micro-FPGA/CRUVI/ecosystem/FMC/FMC2CRUVI-LP/FMC2CRUVI-LP.png

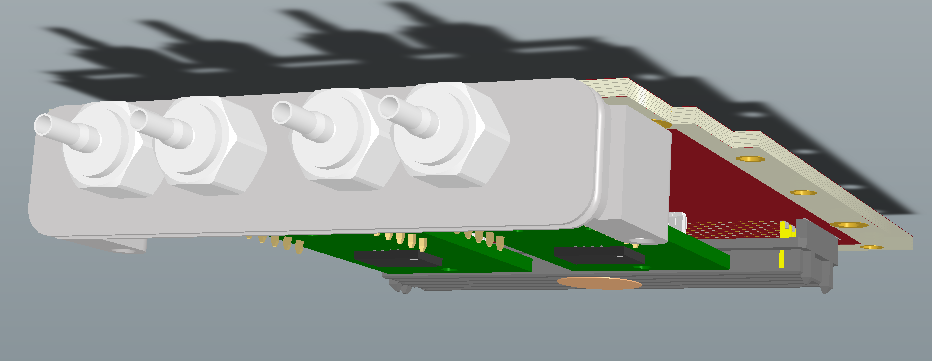
ecosystem/FMC/FMC2CRUVI-LP/FMC2CRUVI-LP.png
