micro-FPGA/CRUVI/ecosystem/TOFE/TOFE_1X_CRUVI_3W_Passive.png

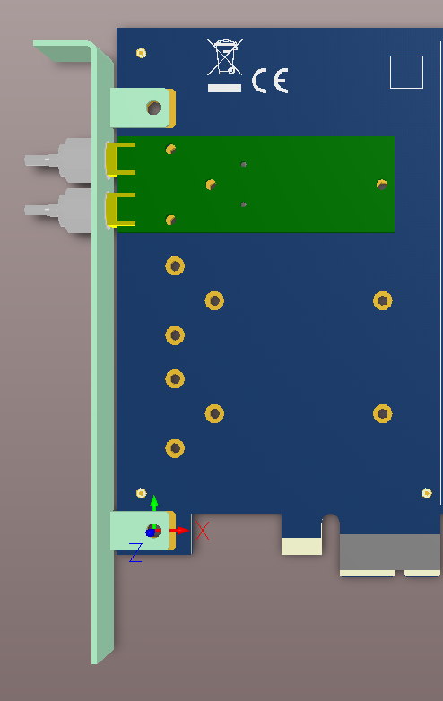
ecosystem/TOFE/TOFE_1X_CRUVI_3W_Passive.png
