micro-FPGA/CRUVI/README.md

# CRUVI
CRUVI Standard Specifications in [docs](https://github.com/micro-FPGA/CRUVI/tree/master/docs)

Mailinglist and discussions: https://groups.io/g/cruvi
