micro-FPGA/CRUVI/ecosystem/PMOD/README.md

Digilent PMOD

|Adapter|Status|
|---|---|
|CRUVI to PMOD single | Boards available |
|PMOD to CRUVI single | Boards available |

Note: if two CRUVI-2-PMOD adapters are inserted into adjacent CRUVI LS slots then dual wide PMOD modules could be used (the connector spacing matches).
