micro-FPGA/CRUVI/ecosystem/EEM/README.md

https://github.com/sinara-hw/meta/wiki/EEM

EEM has management I2C and 8 LVDS pairs that can be used as single ended I/O with unknown VCCIO voltage?

Maybe better to have EEM2CRUVI adapters always with FPGA smart translation?
