micro-FPGA/CRUVI/ecosystem/SYZYGY/README.md

Passive adapter from SYZYGY standard can fit one CRUVI HS connector almost completly so large number of CRUVI modules could be used with passive adapter. Mechanically one standard with SYZYGY can hold a two single width or one dual CRUVI module.

Passive adapter mapping from SYZYGY to CRUVI HS

|SYZYGY|CRUVI|Notes|
|-----|---|--|
|3.3V|VCC||
|5V|VBUS||
|VIO|VADJ||
|SDA|SDA||
|SCL|SCL||
|S0..S23|VADJ IO TBD||
|S24..S27|TBD|?|
|P2C_CLK|VADJ IO TBD||
|C2P_CLK|VADJ IO TBD||
|n/a|ALERT|with level shifter to S27 ?|
|R_GA|n/a|handled locally by SmartVIO|
