micro-FPGA/CRUVI/ecosystem/FMC/FMC2CRUVI-EVAL/README.md

This FMC card has CRUVI slots on the TOP so that any CRUVI modules including extended size one can be used without restrictions.
