micro-FPGA/CRUVI/ecosystem/FMC/FMC2CRUVI-LP/README.md

This FMC card can take 2 low profile CRUVI boards with full support of I/O via standard FMC bezel.
