micro-FPGA/CRUVI/CAD/Altium/templates/CR99500/current/hw/pcb/README.md

Tripple wide CRUVI carrier template with LS, HS and GT slots
