micro-FPGA/CRUVI/CAD/Altium/boards/CR00026/docs/3DB-CR00026-01-1.PDF

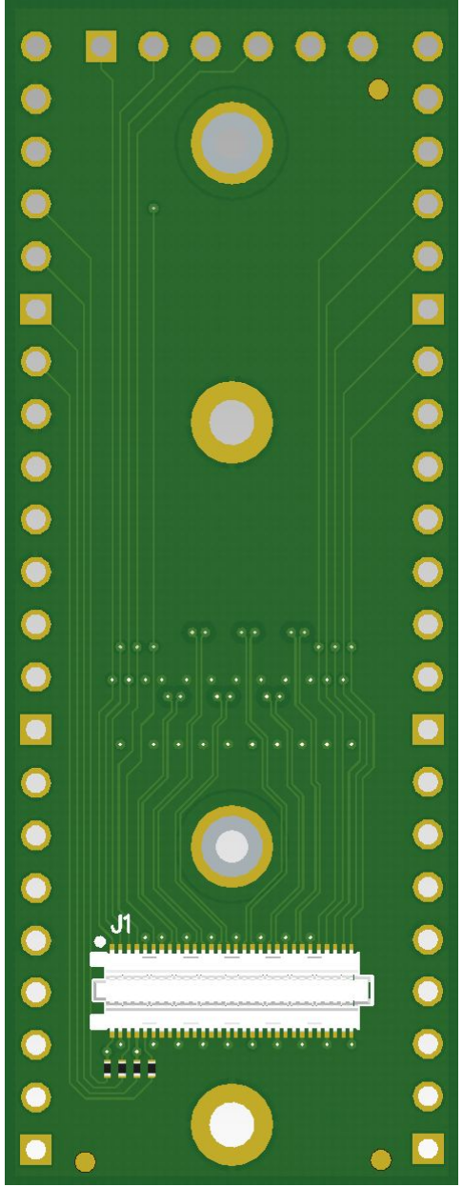
[picture p22: figure]
