micro-FPGA/CRUVI/ecosystem/FMC/FMC2CRUVI-EVAL/FMC2CRUVI-EVAL.png

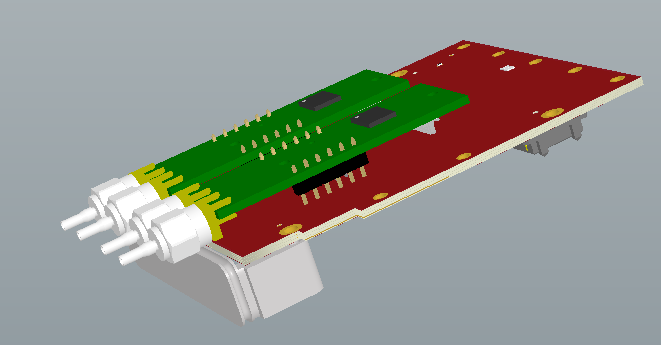
ecosystem/FMC/FMC2CRUVI-EVAL/FMC2CRUVI-EVAL.png
