micro-FPGA/CRUVI/ecosystem/PMOD/CRUVI_to_PMOD_single.png

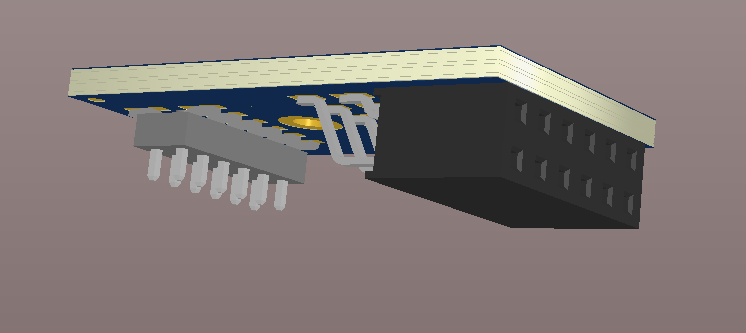
ecosystem/PMOD/CRUVI_to_PMOD_single.png
