micro-FPGA/CRUVI/ecosystem/QWIIC/CRUVI_to_QWIIC.png

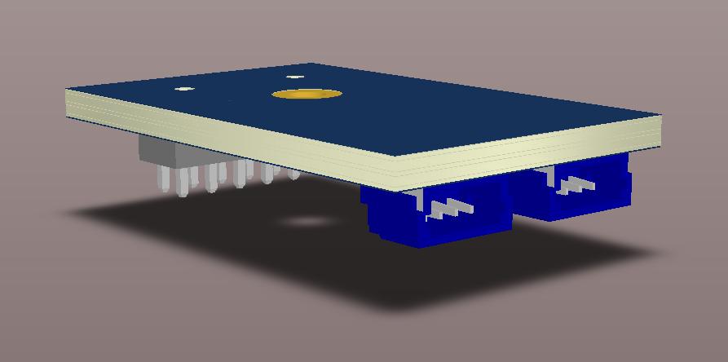
ecosystem/QWIIC/CRUVI_to_QWIIC.png
