micro-FPGA/CRUVI/ecosystem/shuttle/CRUVI-to-shuttle.png

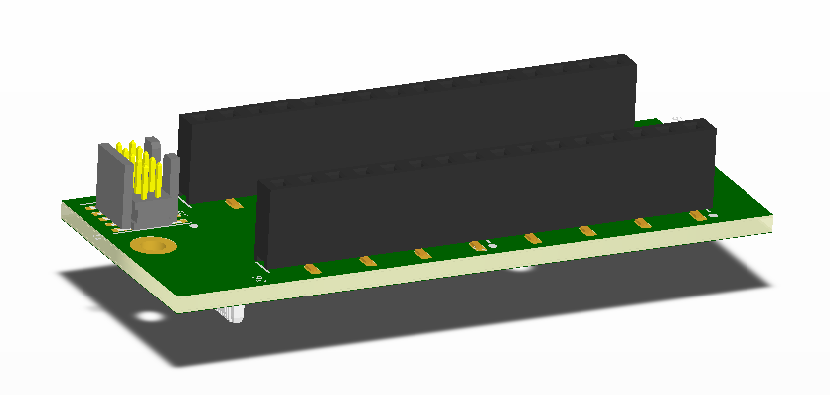
ecosystem/shuttle/CRUVI-to-shuttle.png
