micro-FPGA/CRUVI/ecosystem/shuttle/shuttle-to-CRUVI.png

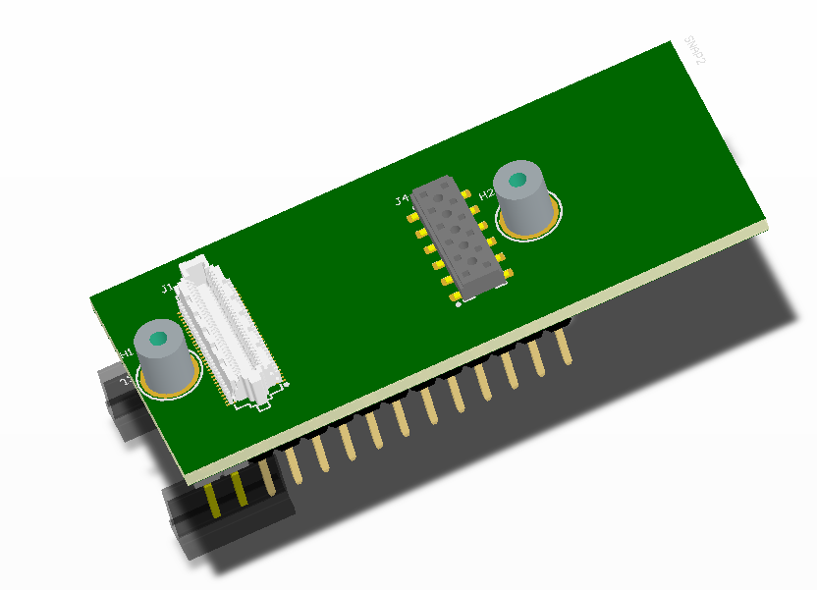
ecosystem/shuttle/shuttle-to-CRUVI.png
