micro-FPGA/CRUVI/ecosystem/SYZYGY/syzygy-2-cruvi.png

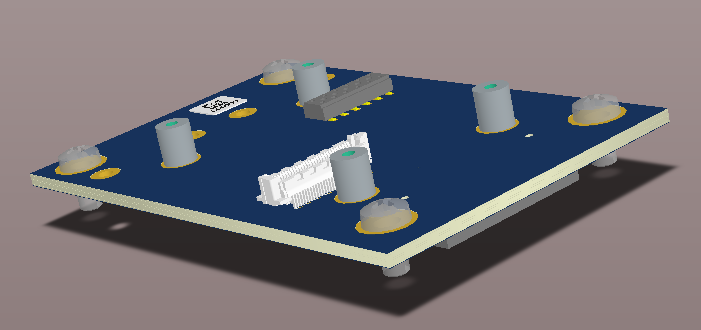
ecosystem/SYZYGY/syzygy-2-cruvi.png
