micro-FPGA/CRUVI/carriers/CR00103/test_litex/README.md

This is simple test on CR00103 that Litex generated SoC works.

As starting some top.v from ANOTHER litex project is taken, then the files are added to Radiant project. And it works.
