micro-FPGA/CRUVI/carriers/CR00103/test_litex/litex_boot.png

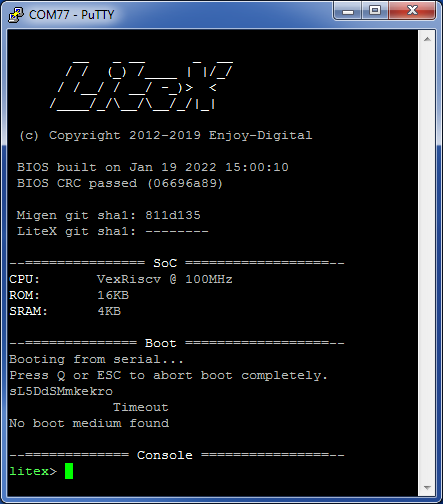
carriers/CR00103/test_litex/litex_boot.png
