micro-FPGA/CRUVI/CAD/Altium/templates/CR99400/current/hw/pcb/manufacturing reports/PDF/SCH-CR99400-01-A.PDF

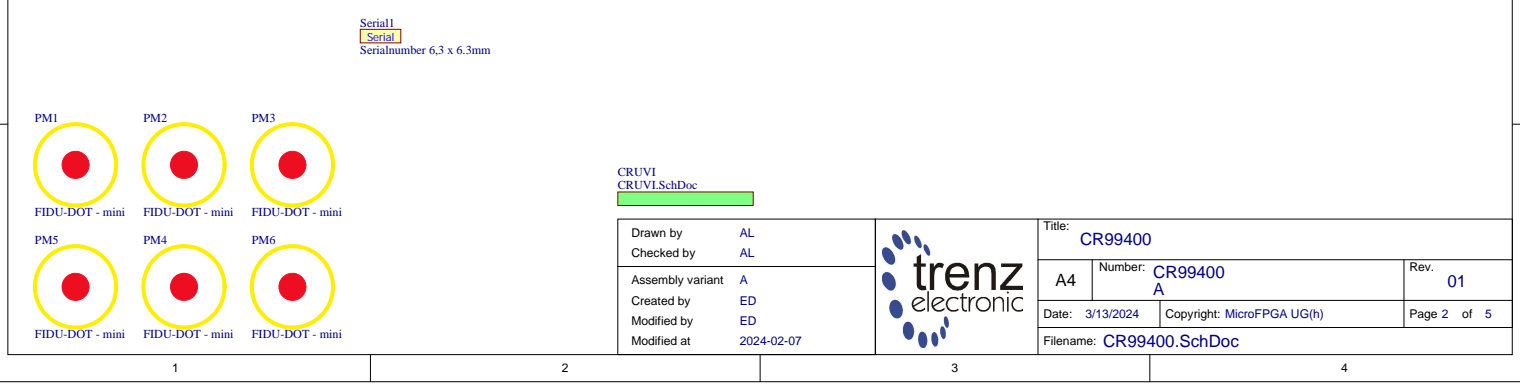
[picture p30: page 1]

Drawn by AL Checked by AL | | Title: CR99400

A4 | Number: CR99400 A | Rev. 01

Date: 3/13/2024 | Copyright: MicroFPGA UG(h) | Page 2 of 5

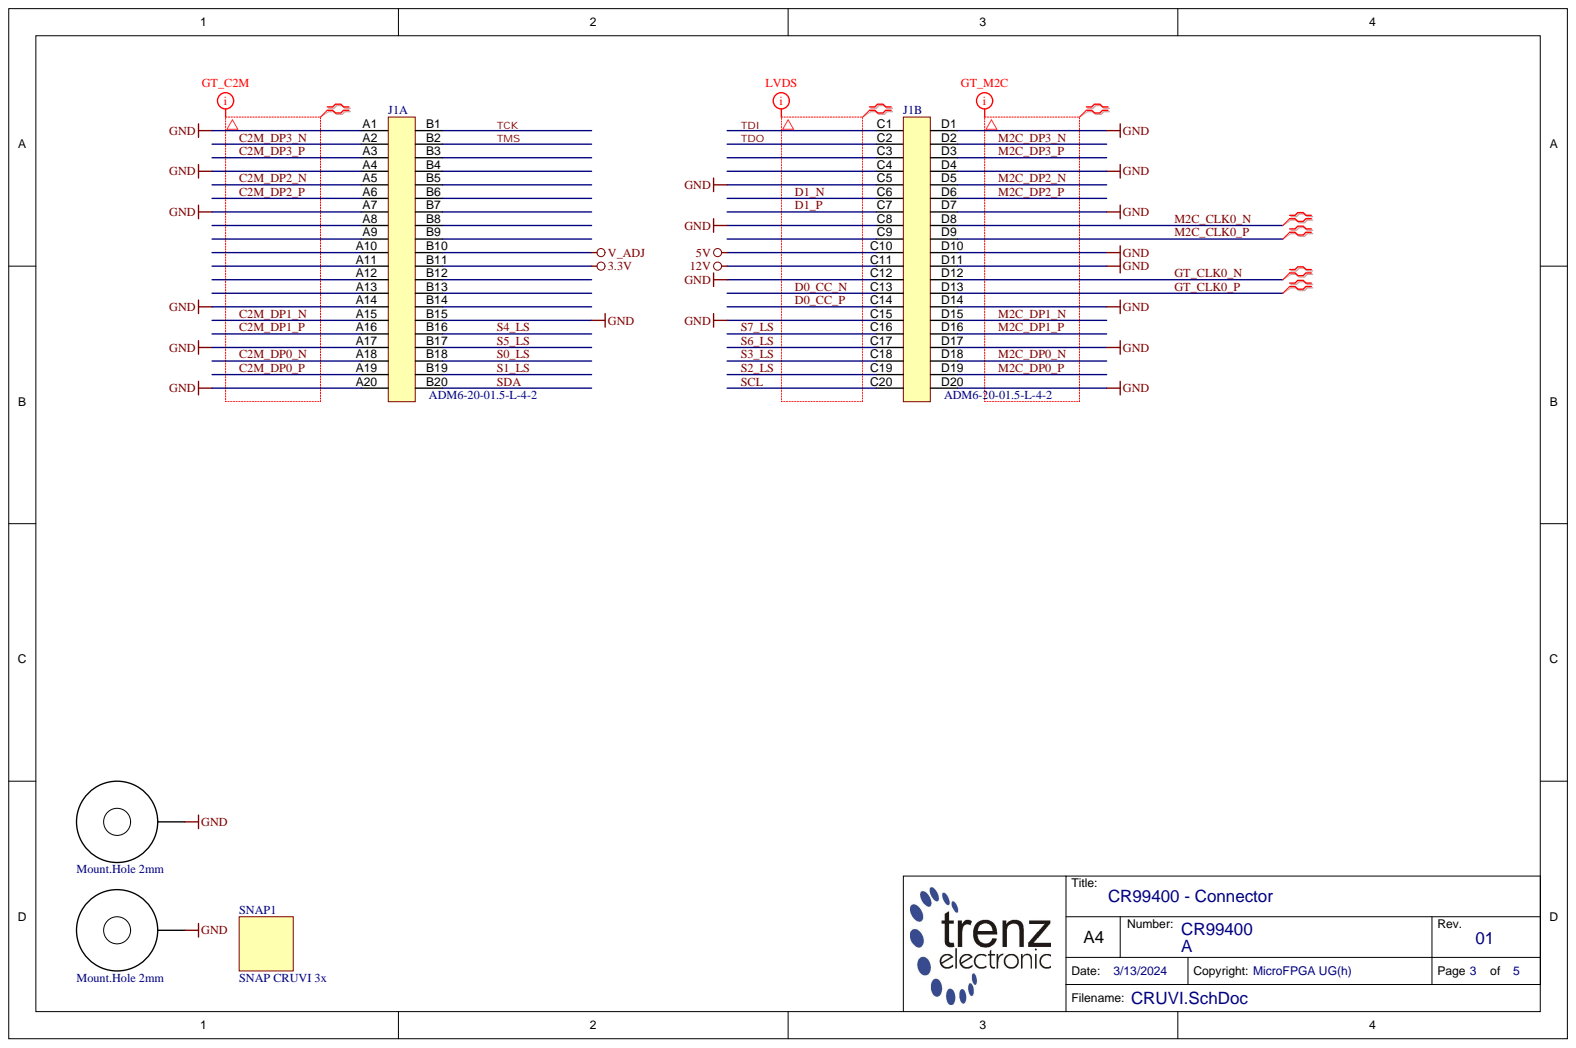
[picture p31: page 2]

D11
D12 D13 D14

Title: CR99400 - Connector

A4 | Number: CR99400 A | Rev. 01

Date: 3/13/2024 | Copyright: MicroFPGA UG(h) | Page 3 of 5
