micro-FPGA/CRUVI/CAD/Altium/boards/CR00026/docs/SCH-CR00026-01-1.PDF

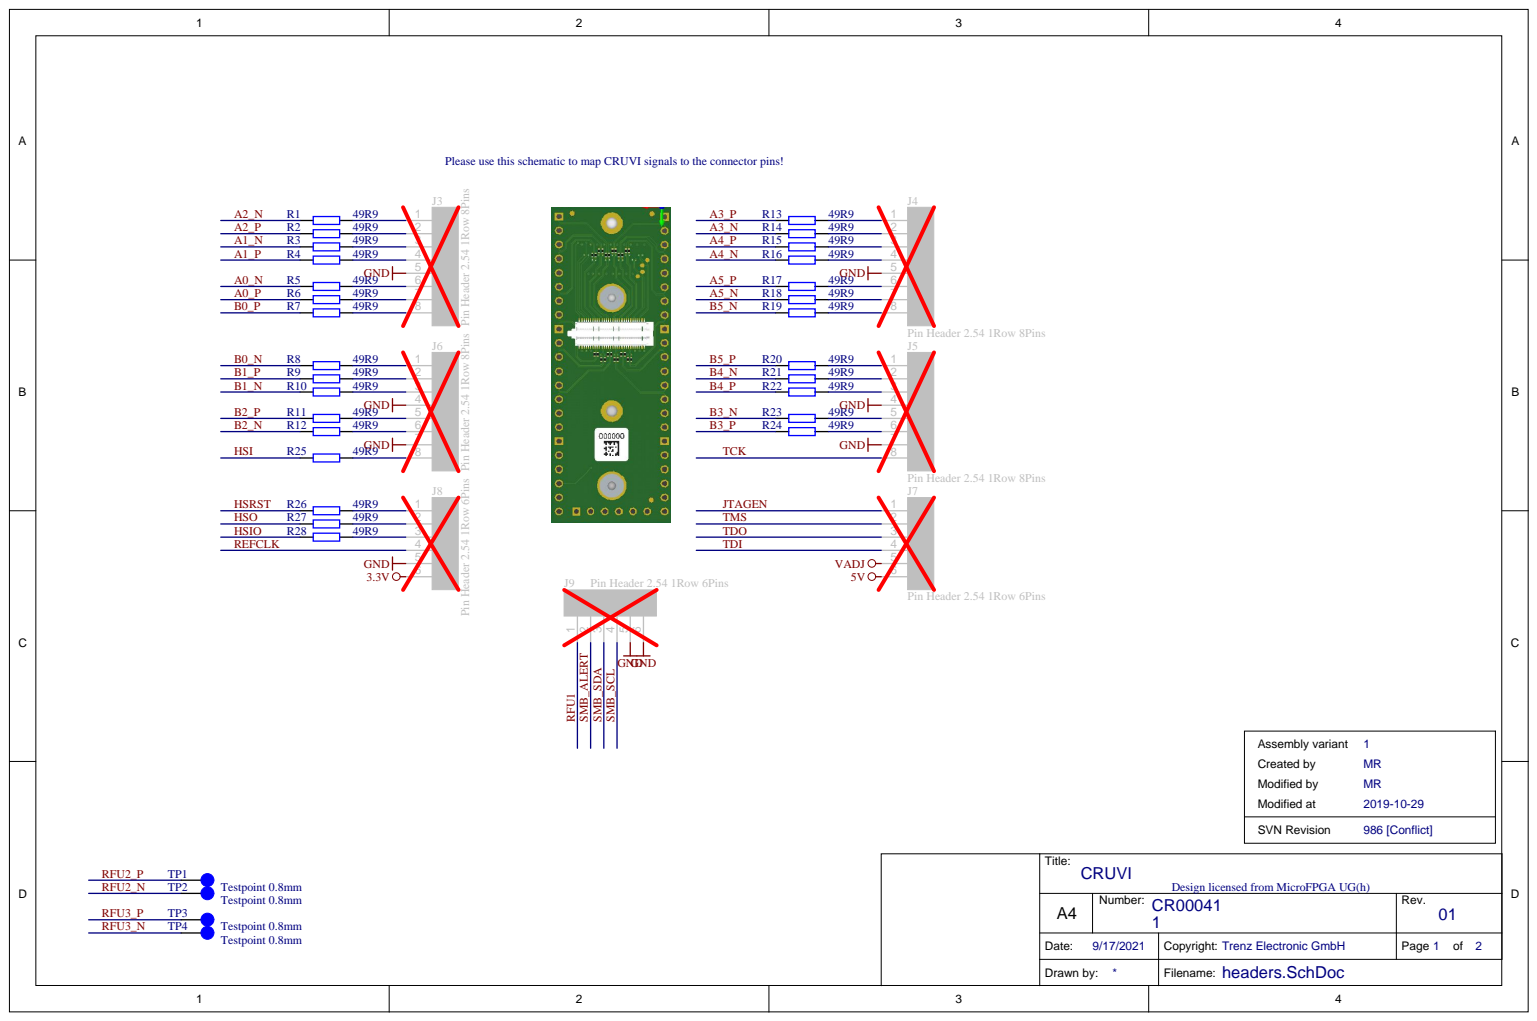
[picture p32: page 1]

Please use this schematic to map CRUVI signals to the connector pins!

Title: CRUVI Design licensed from MicroFPGA UG(h)

A4 | Number: CR00041 1 | Rev. 01

Date: 9/17/2021 | Copyright: Trenz Electronic GmbH | Page 1 of 2

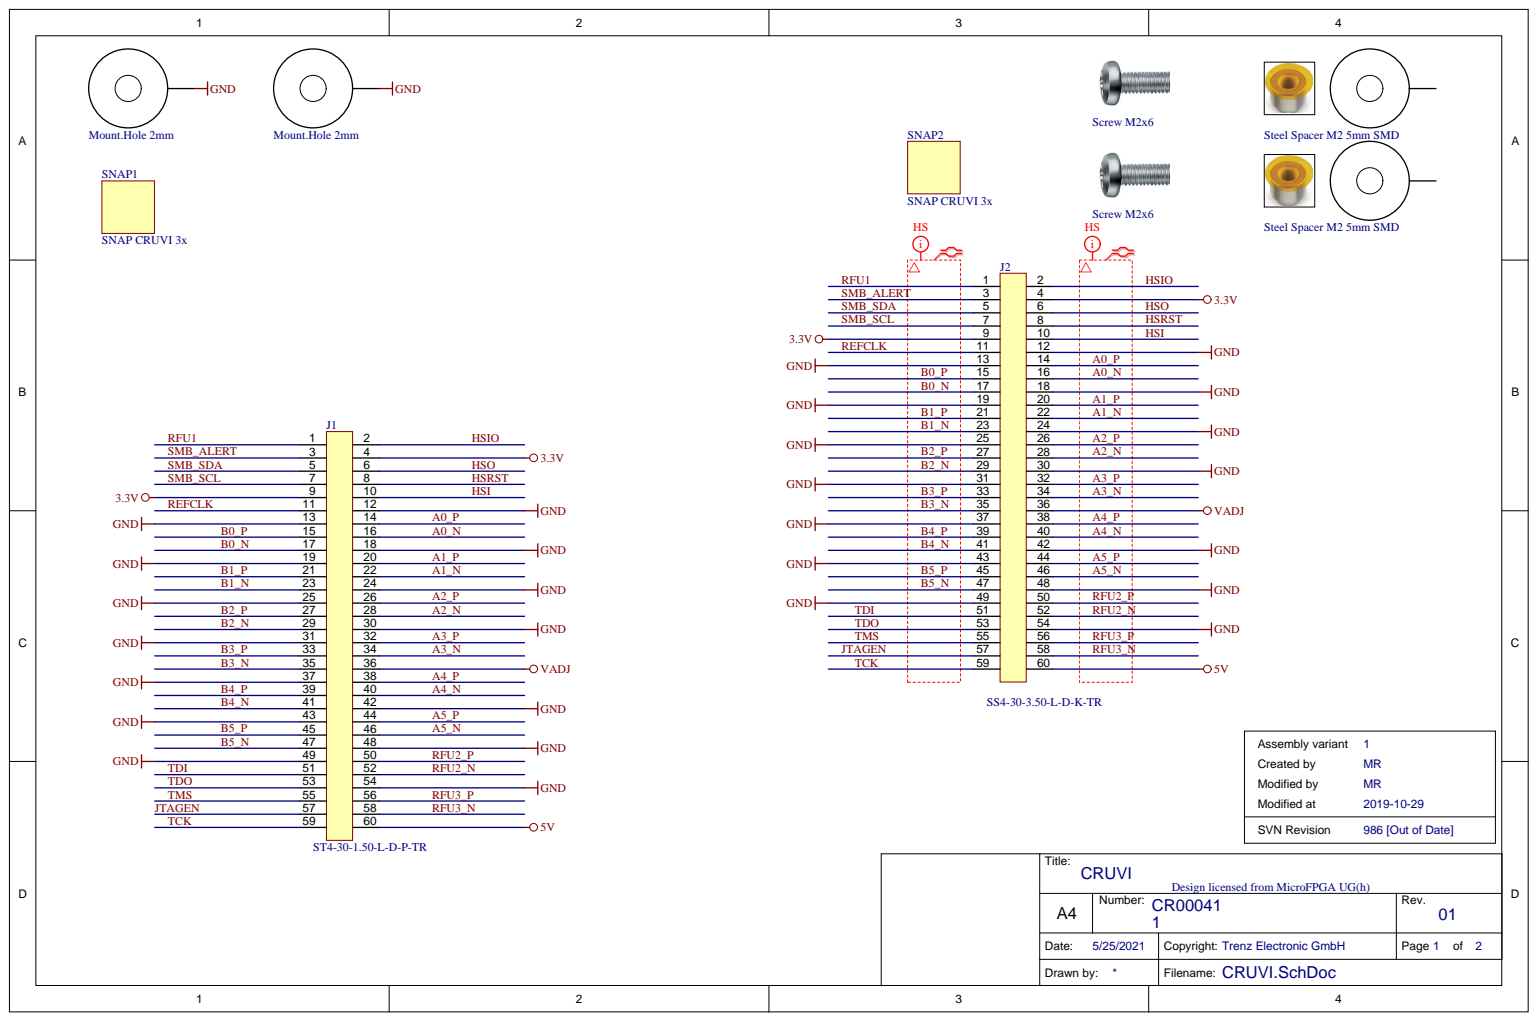
[picture p33: page 2]

50 | RFU2_P RFU2_N

RFU3_P RFU3_N

Title: CRUVI Design licensed from MicroFPGA UG(h)

A4 | Number: CR00041 1 | Rev. 01

Date: 5/25/2021 | Copyright: Trenz Electronic GmbH | Page 1 of 2

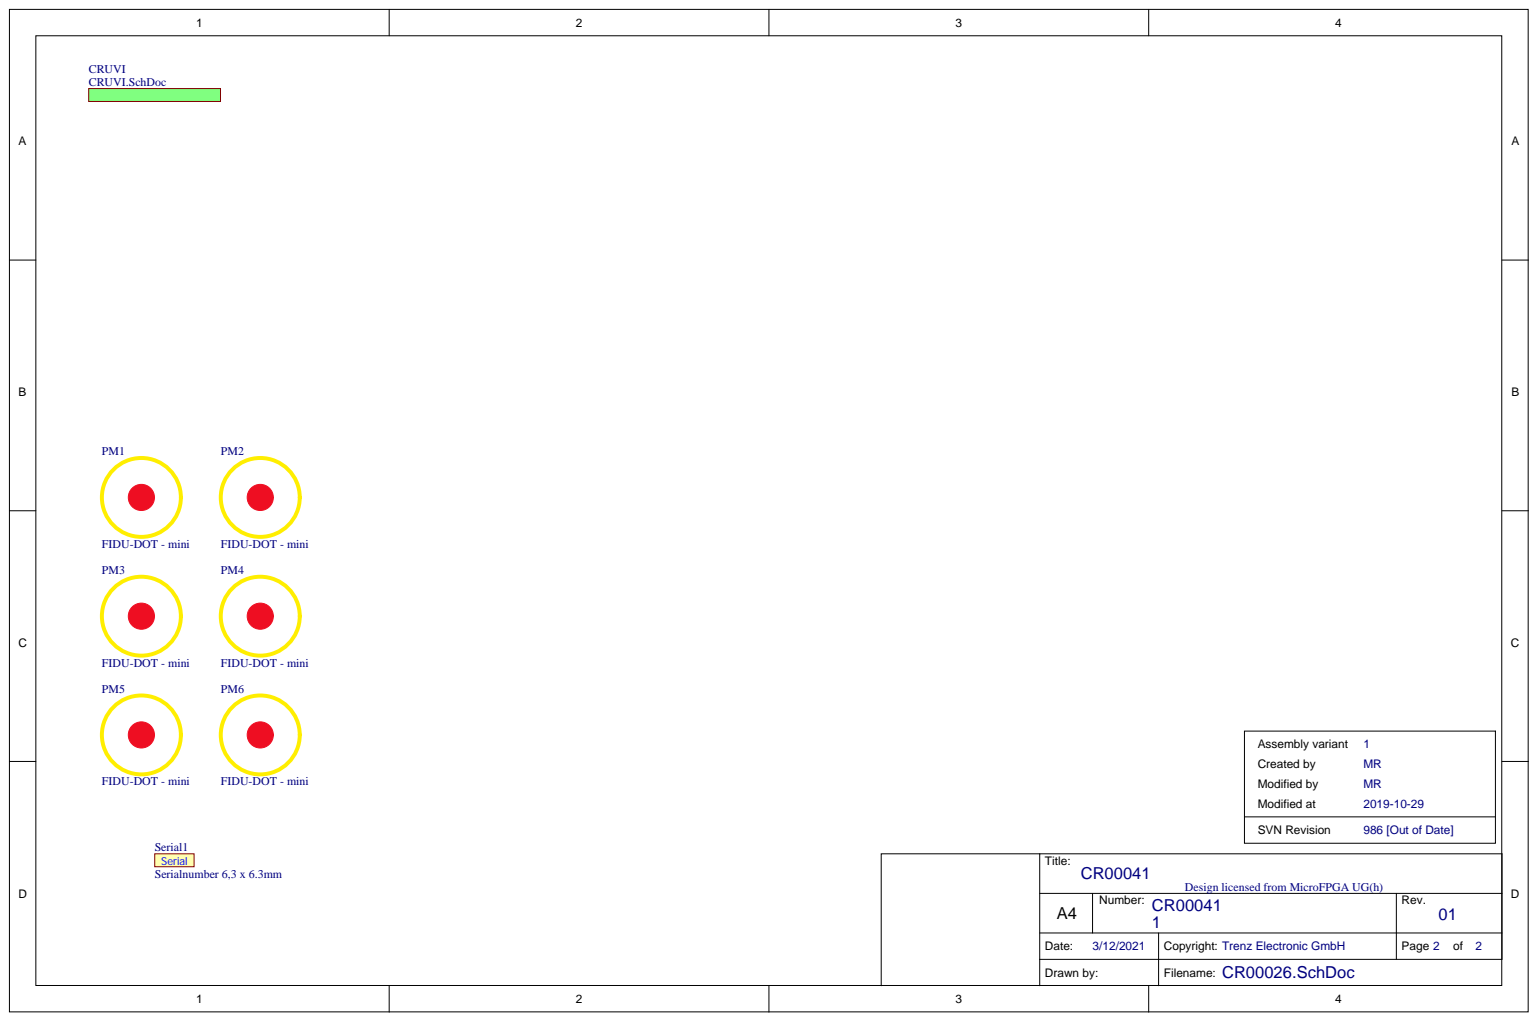
[picture p34: page 3]

Design licensed from MicroFPGA UG(h)

A4 | Number: CR00041 1 | Rev. 01

Date: 3/12/2021 | Copyright: Trenz Electronic GmbH | Page 2 of 2
