micro-FPGA/CRUVI/CAD/Altium/templates/CR99500/current/hw/pcb/manufacturing reports/PDF/3DB-CR99500-01-No Variations.PDF

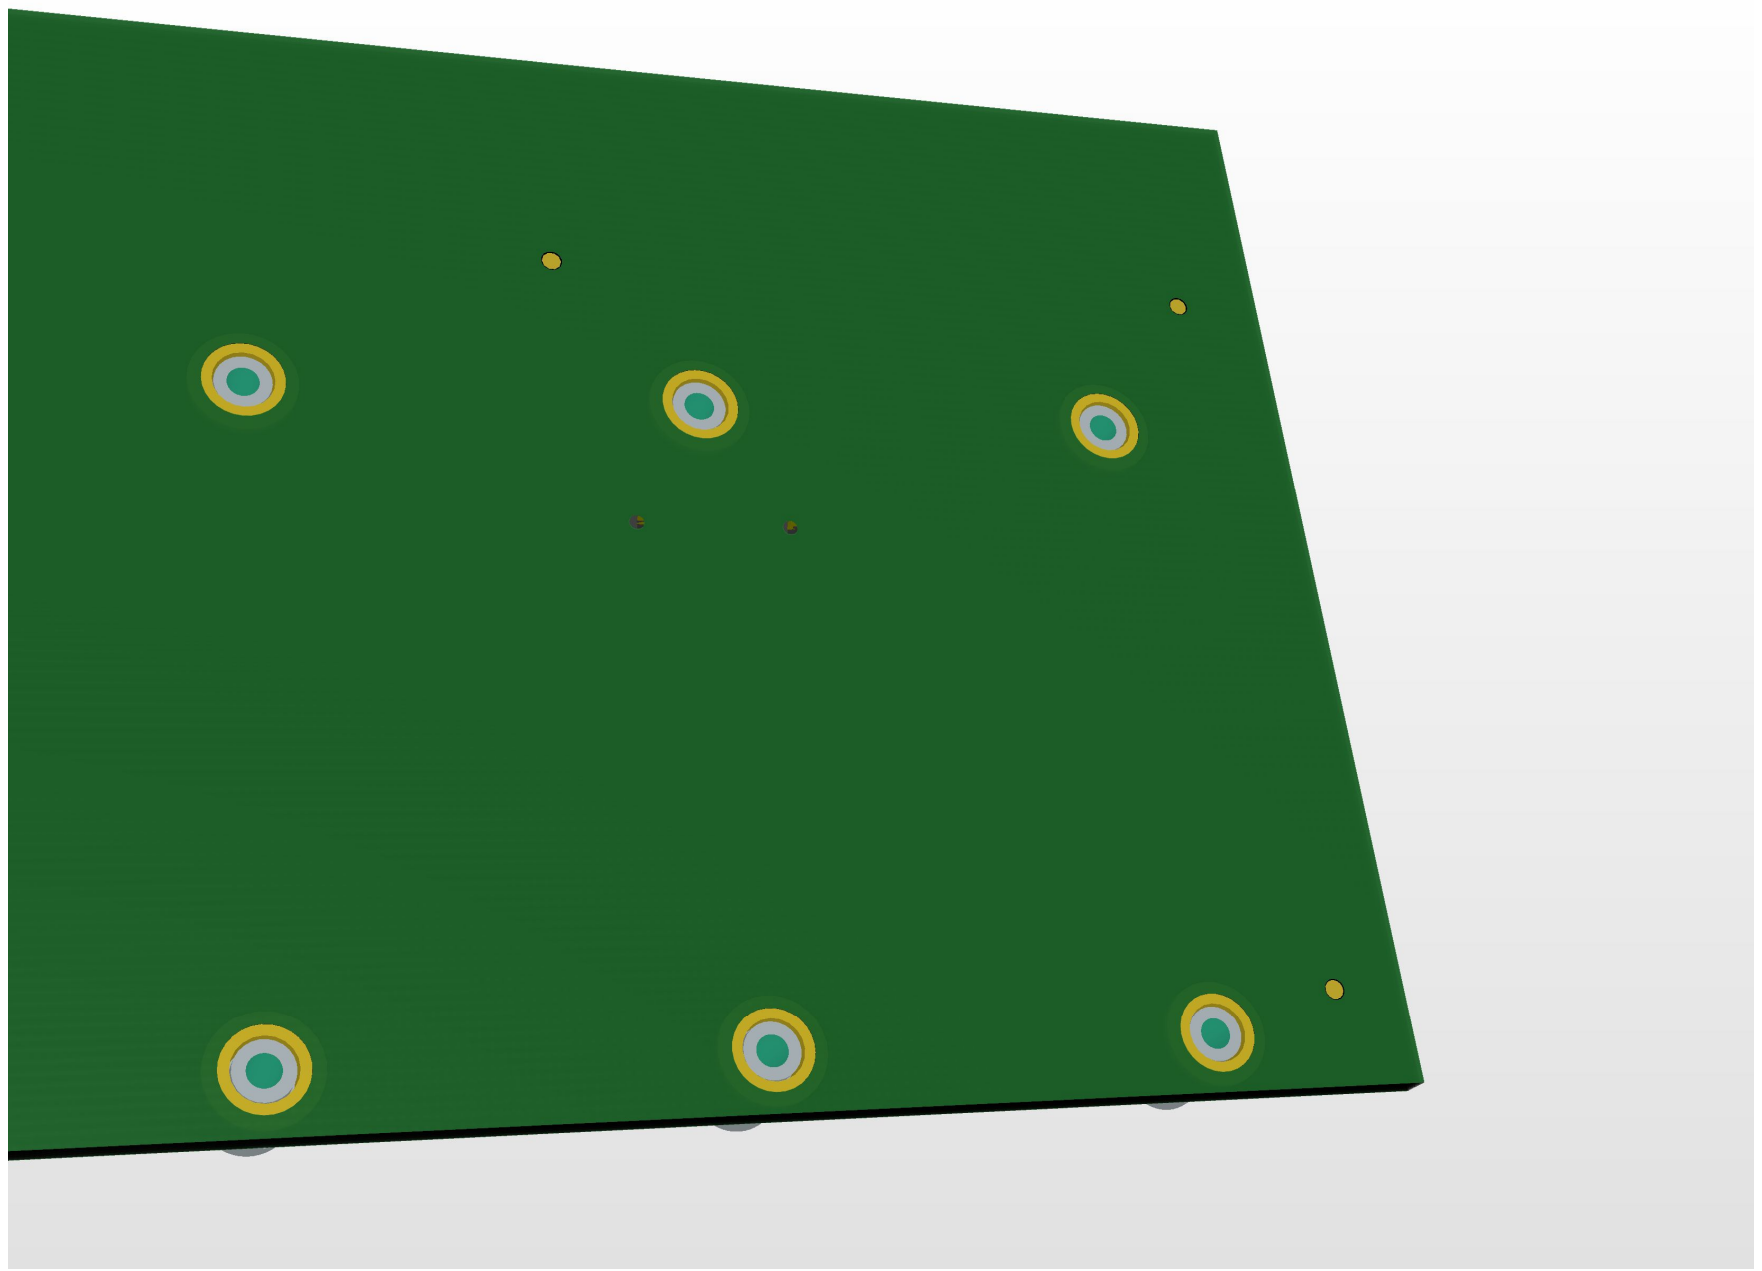
[picture p35: page 1]
