micro-FPGA/CRUVI/CAD/Altium/templates/CR99500/current/hw/pcb/manufacturing reports/PDF/AD-CR99500-01-A.PDF

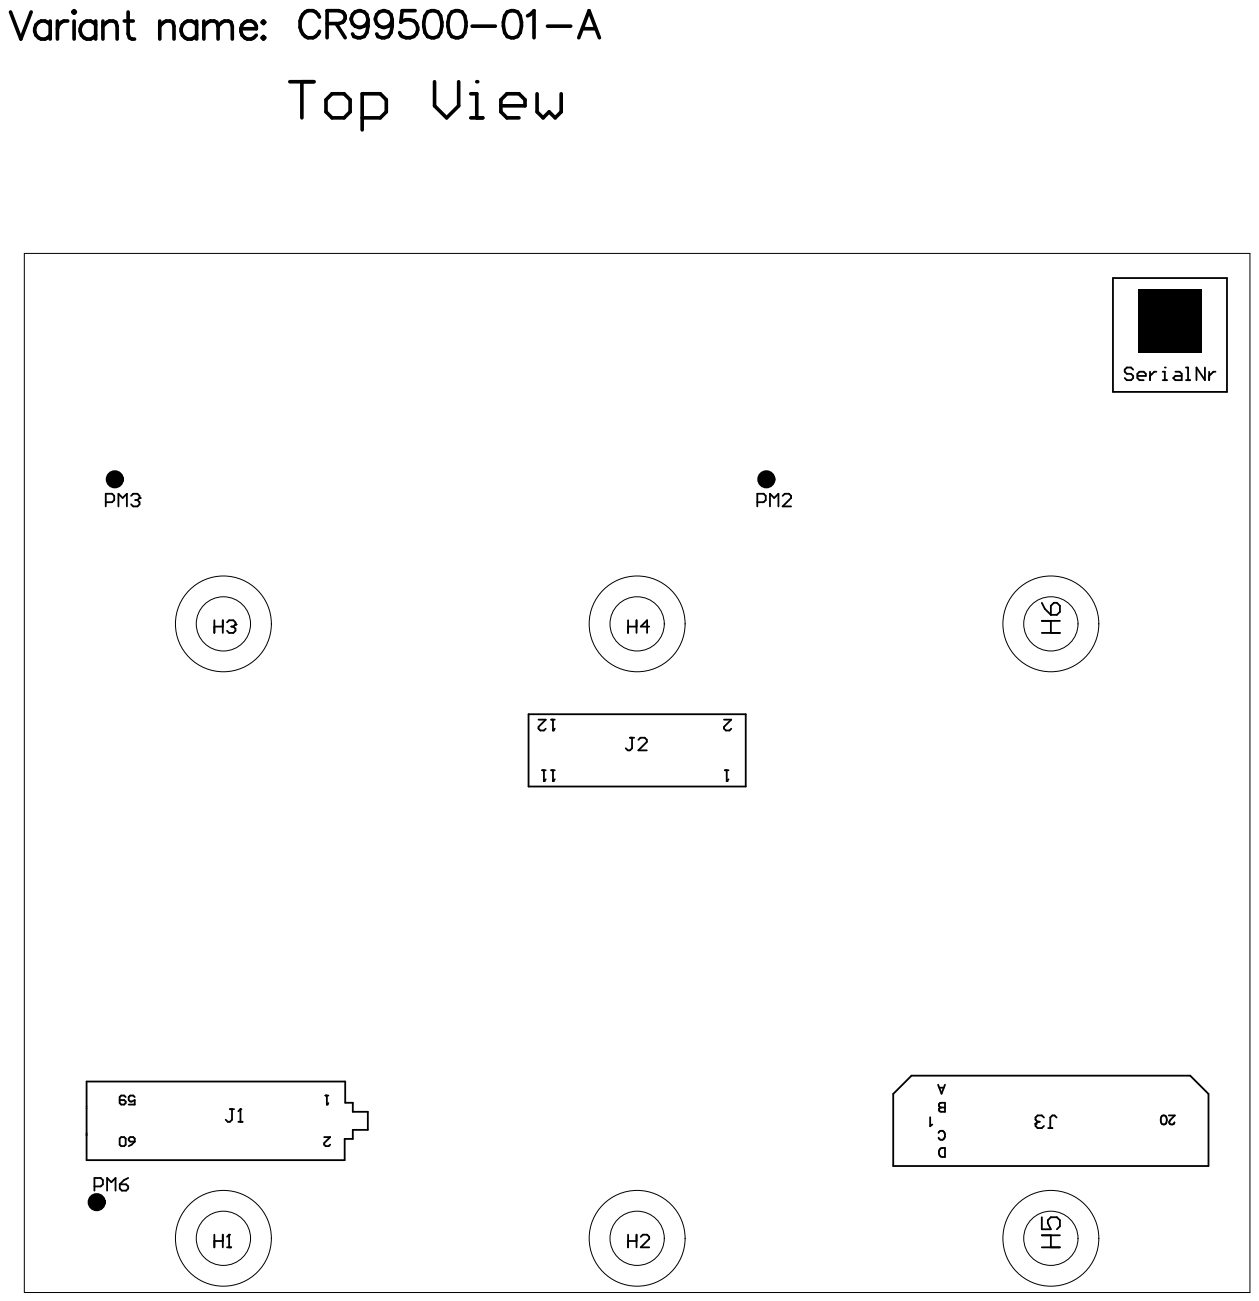
[picture p37: page 1]

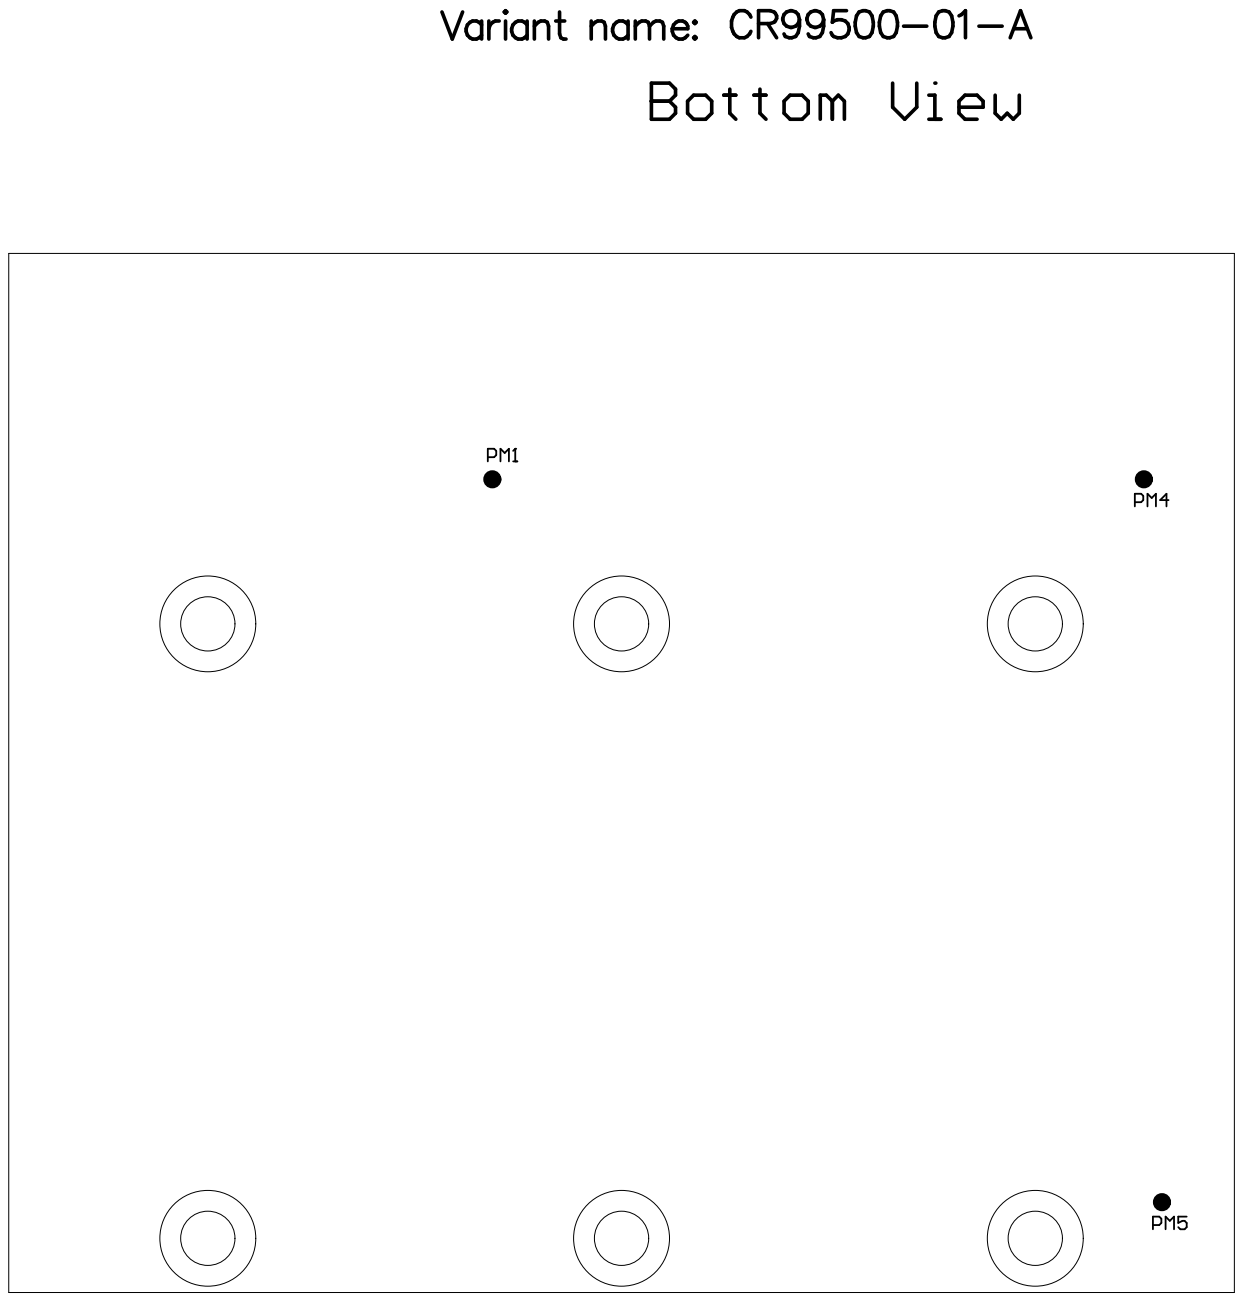
[picture p38: page 2]
