micro-FPGA/CRUVI/CAD/Altium/templates/CR99500/current/hw/pcb/manufacturing reports/PDF/DIM-CR99500-01-No Variations.PDF

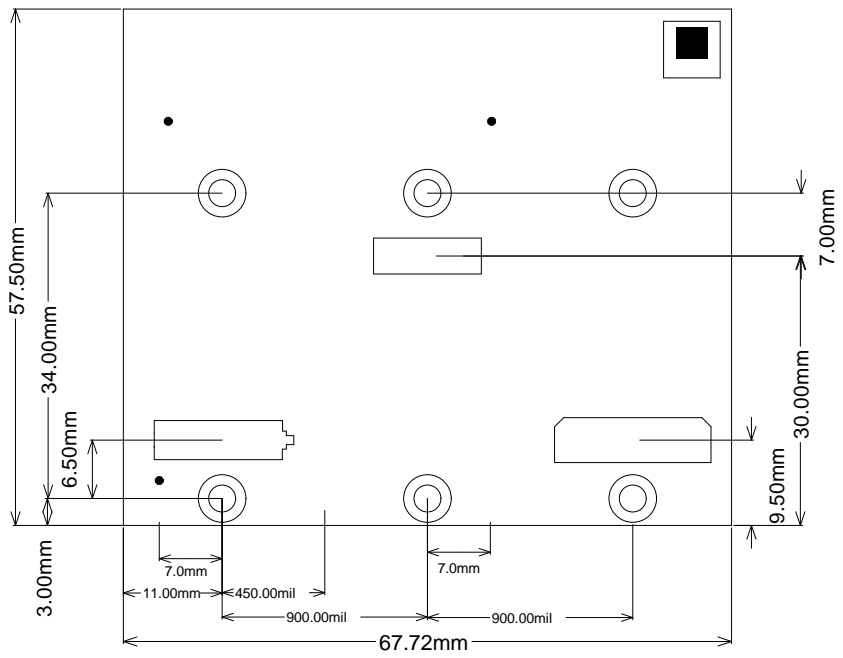
[picture p39: page 1]

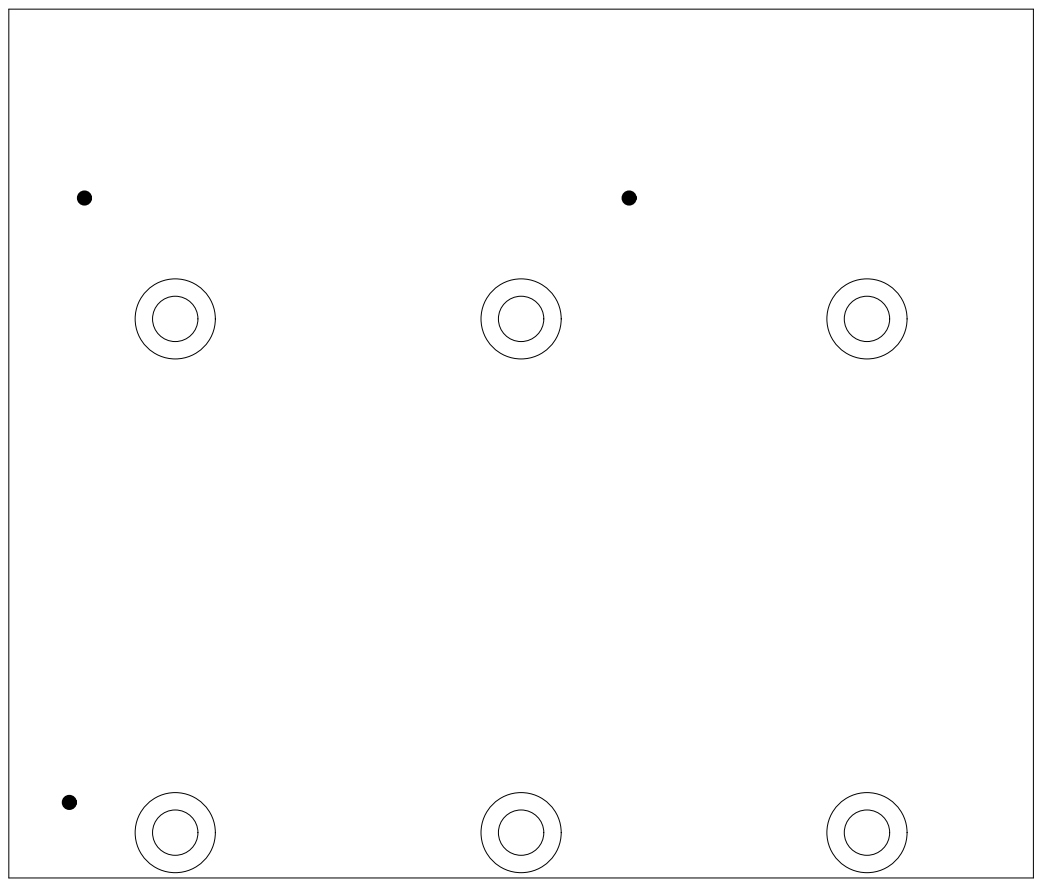
[picture p40: page 2]
