micro-FPGA/CRUVI/CAD/Altium/templates/CR99500/current/hw/pcb/manufacturing reports/PDF/SCH-CR99500-01-A.PDF

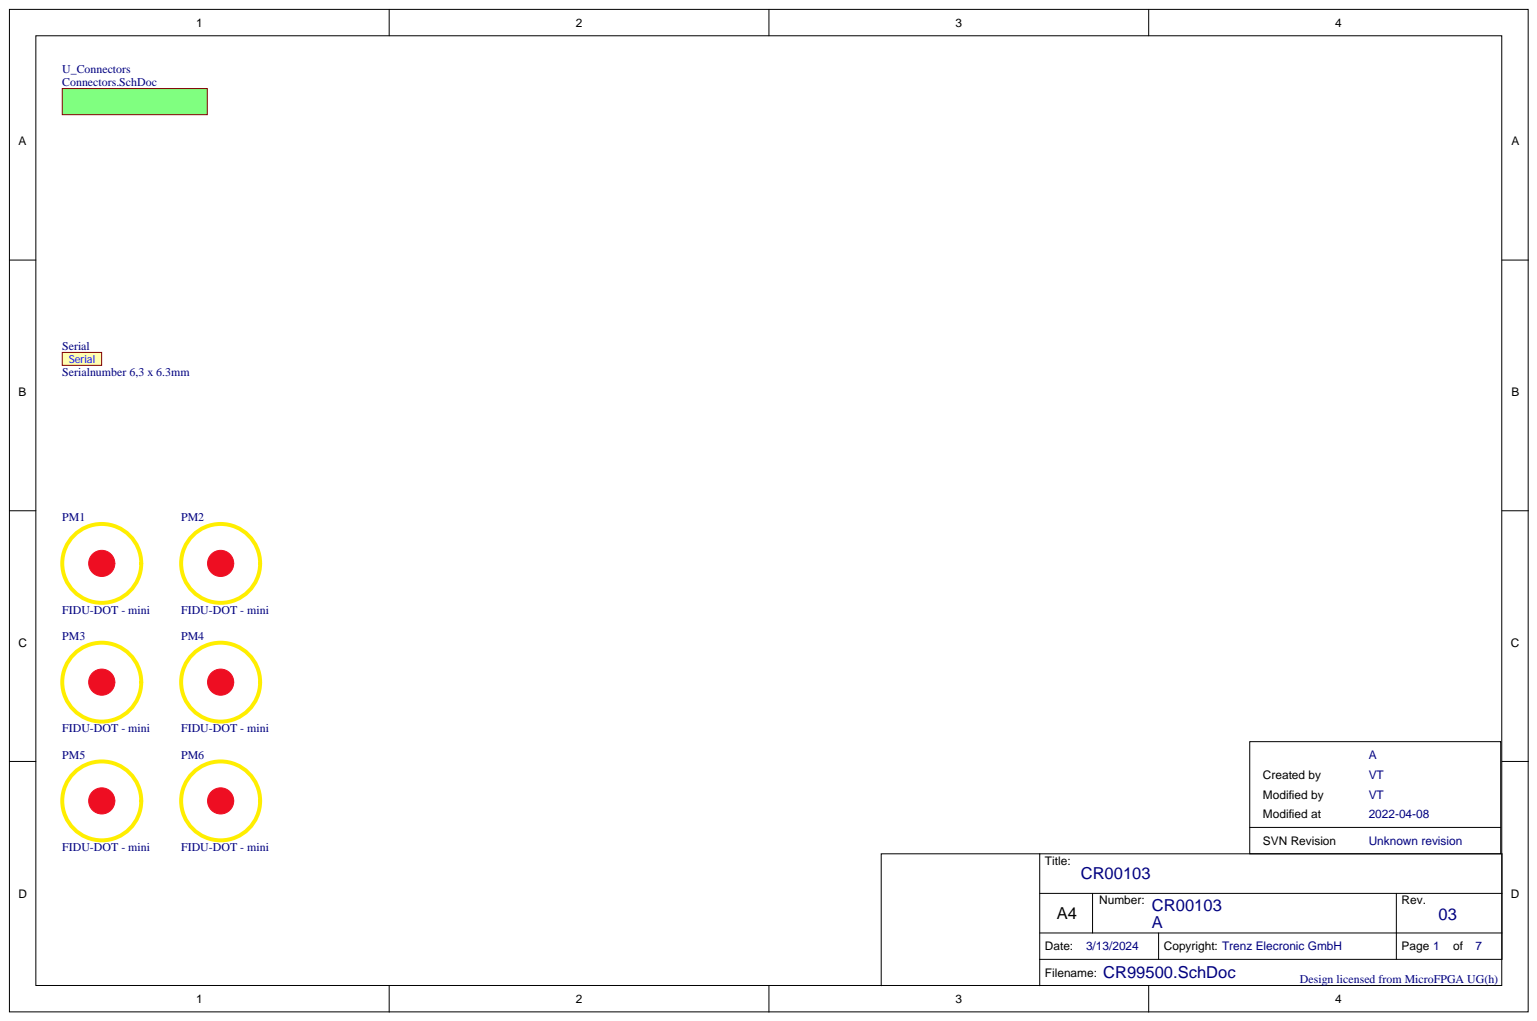
[picture p41: page 1]

Title: CR00103

A4 | Number: CR00103 A | Rev. 03

Date: 3/13/2024 | Copyright: Trenz Elecronic GmbH | Page 1 of 7

Design licensed from MicroFPGA UG(h)

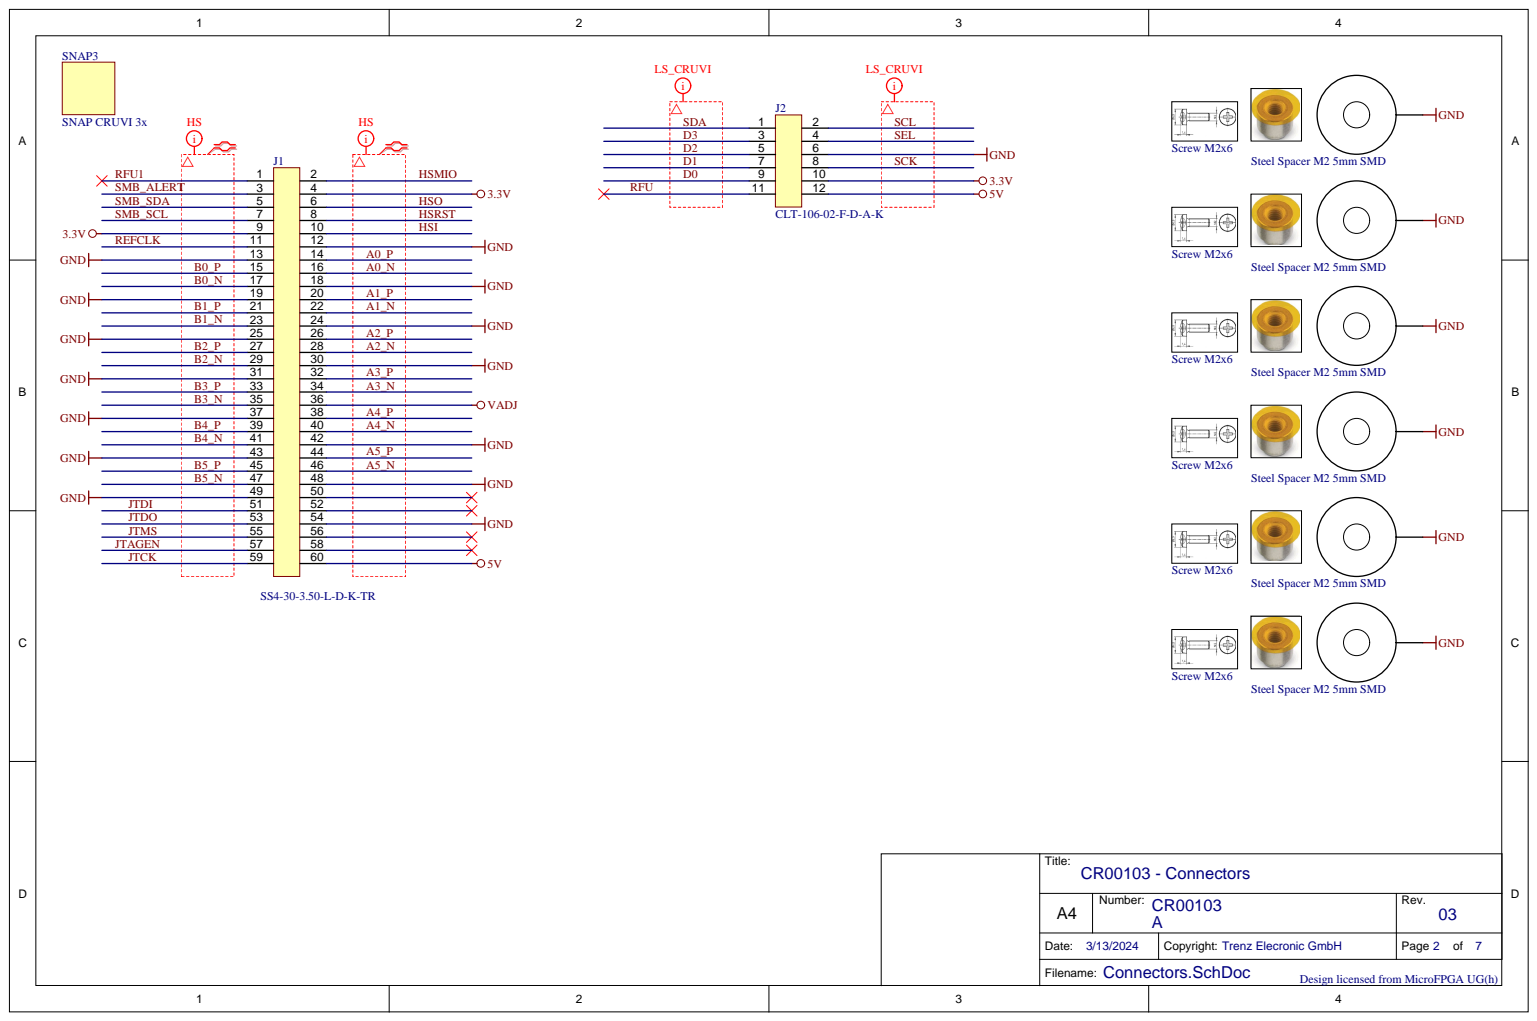
[picture p42: page 2]

Title: CR00103 - Connectors

A4 | Number: CR00103 A | Rev. 03

Date: 3/13/2024 | Copyright: Trenz Elecronic GmbH | Page 2 of 7

Design licensed from MicroFPGA UG(h)

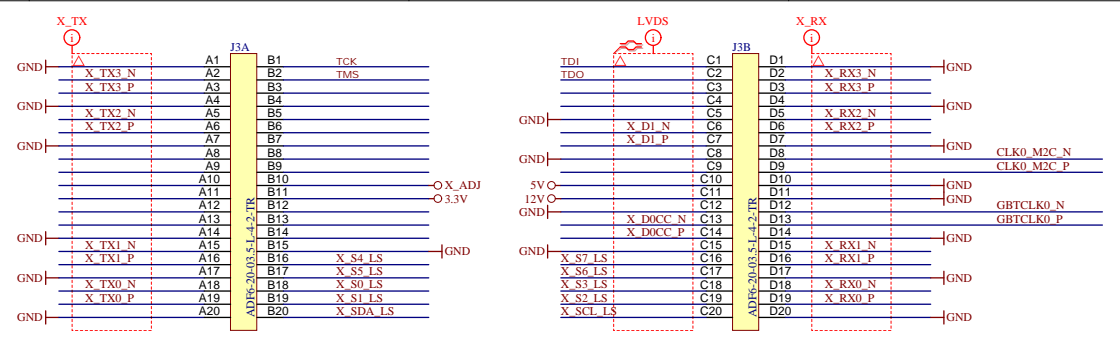
[picture p43: page 3]

D11
D12 D13 D14

Title: CRUVI

A4 | Number: CR00111 A | Rev. 01

Date: 3/13/2024 | Copyright: MicroFPGA UG | Page 3 of 6

Filename: CRUVI-GT.SchDoc
