micro-FPGA/CRUVI/CAD/Altium/templates/CR99001/current/hw/pcb/manufacturing reports/PDF/3DB-CR00001-01-1.PDF

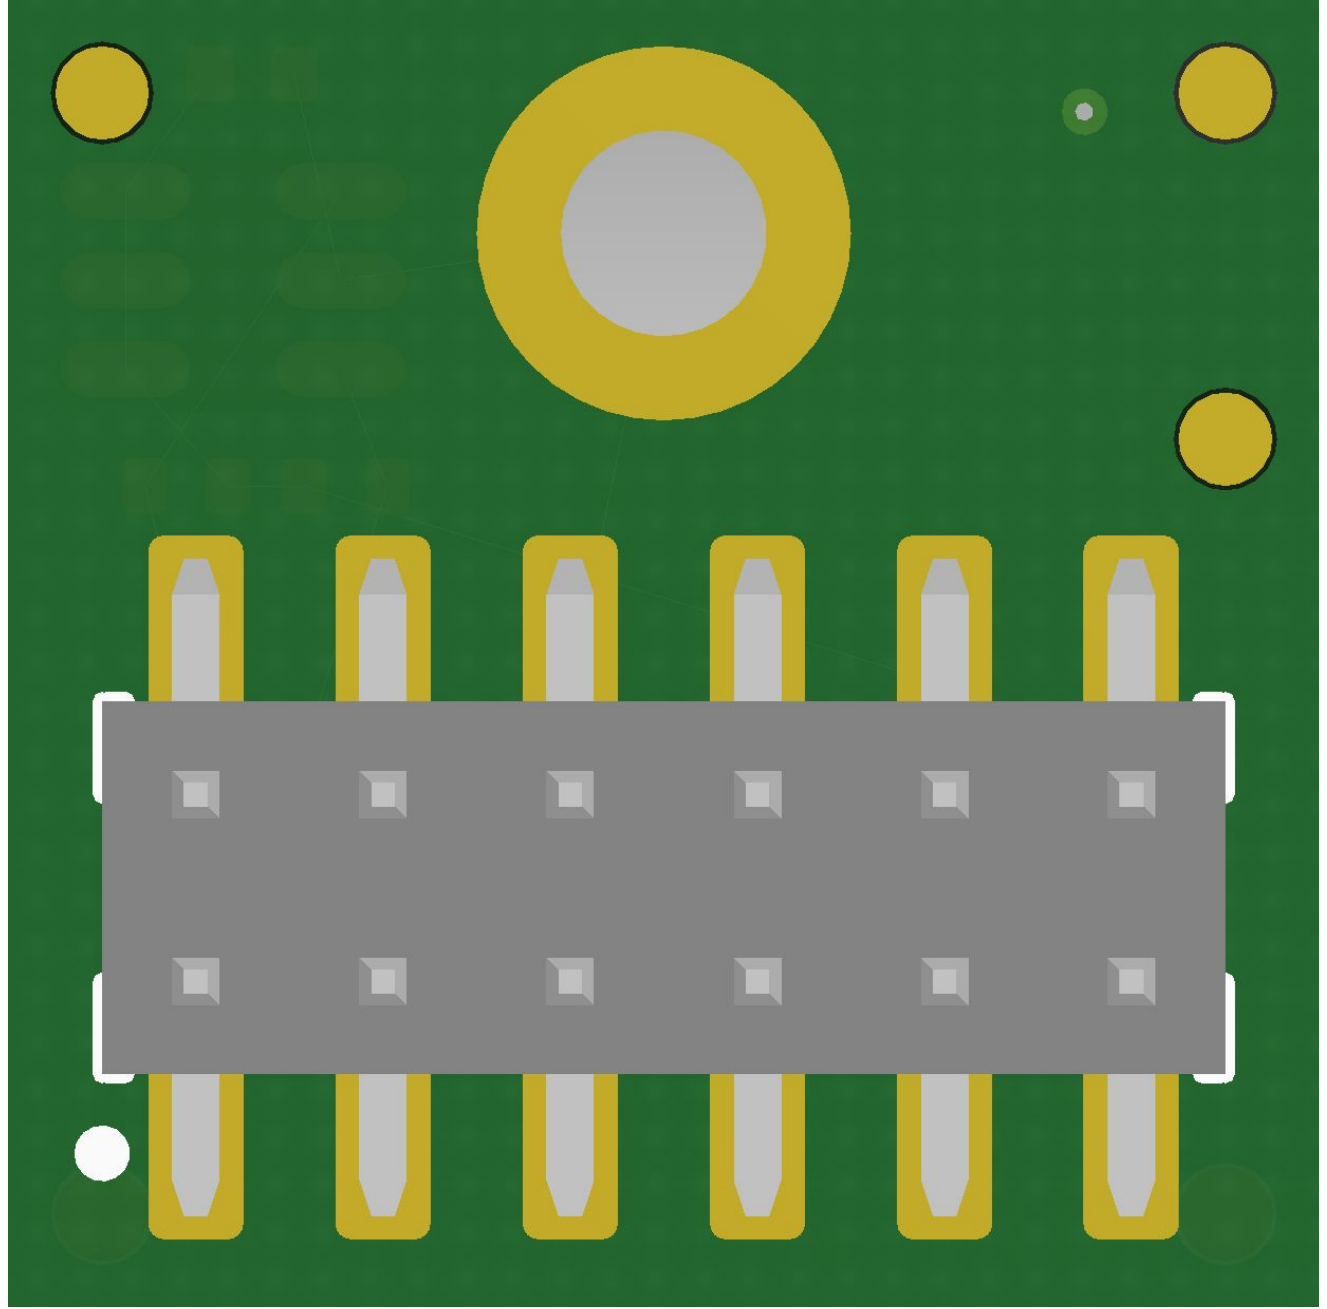
[picture p44: page 1]
