micro-FPGA/CRUVI/CAD/Altium/templates/CR99001/current/hw/pcb/manufacturing reports/PDF/3DT-CR00001-01-1.PDF

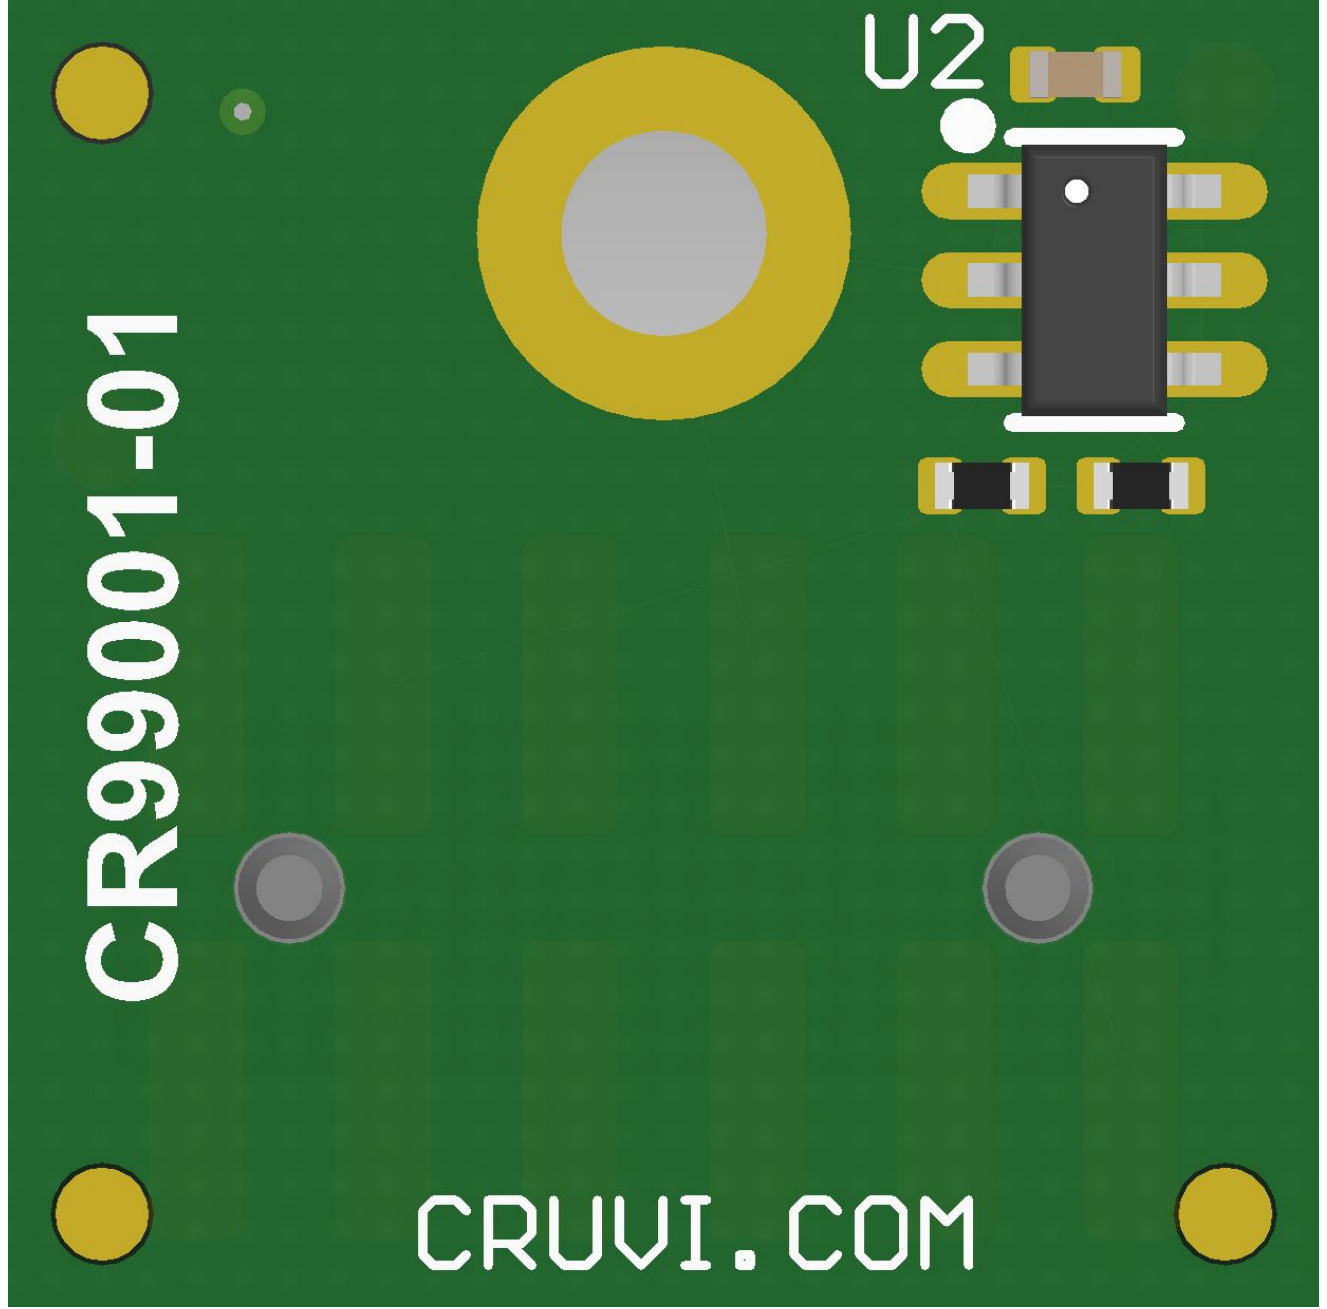
[picture p45: page 1]
