micro-FPGA/CRUVI/CAD/Altium/templates/CR99001/current/hw/pcb/manufacturing reports/PDF/AD-CR00001-01-1.PDF

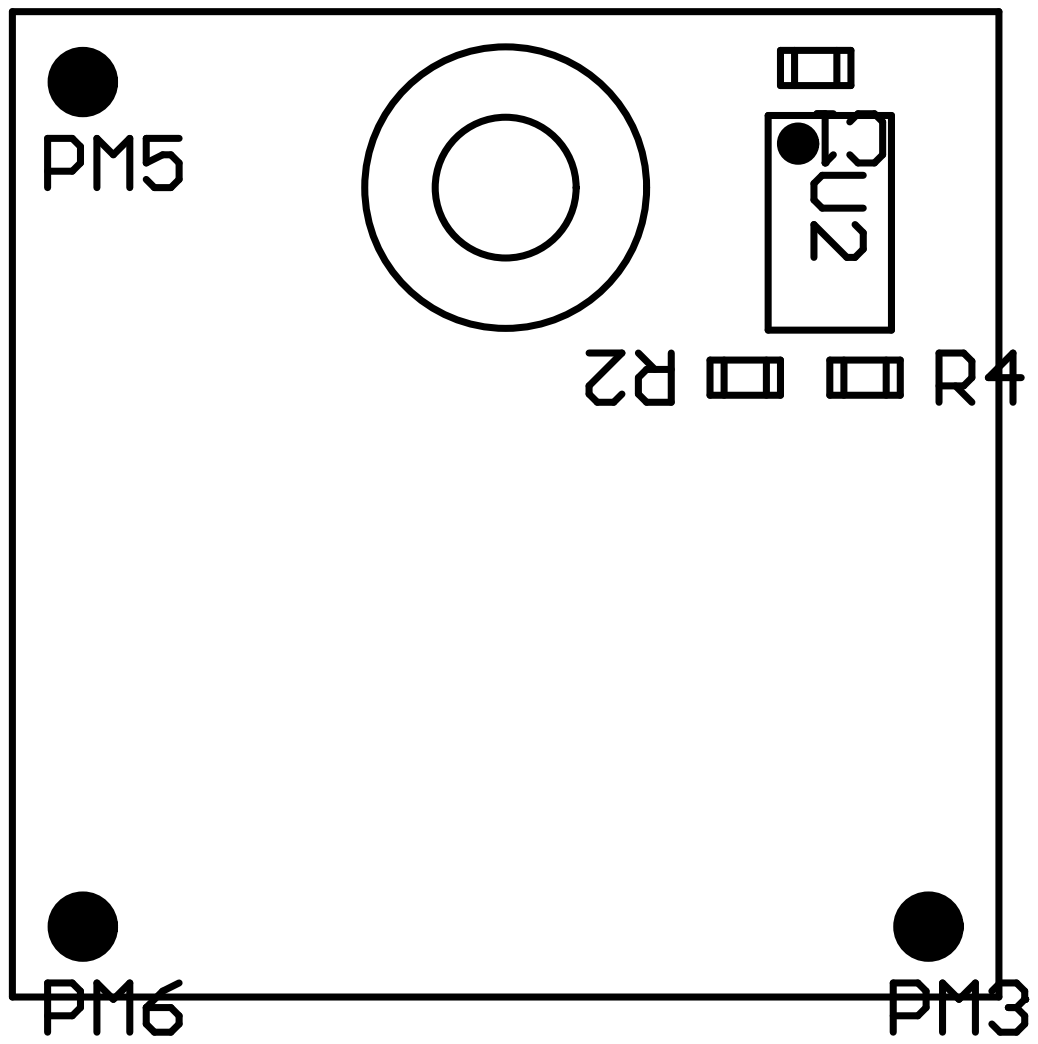
[picture p46: page 1]

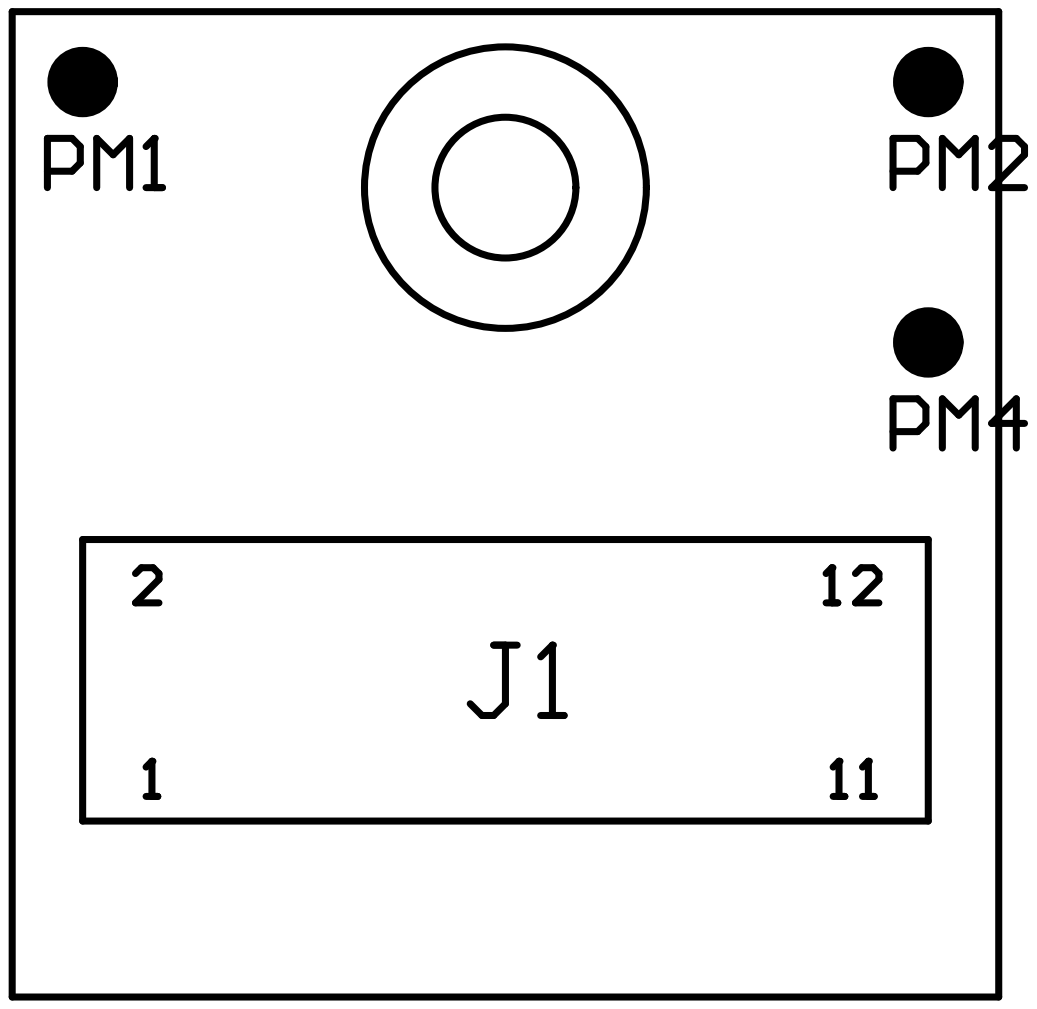
[picture p47: page 2]
