micro-FPGA/CRUVI/CAD/Altium/templates/CR99001/current/hw/pcb/manufacturing reports/PDF/DIM-CR00001-01-1.PDF

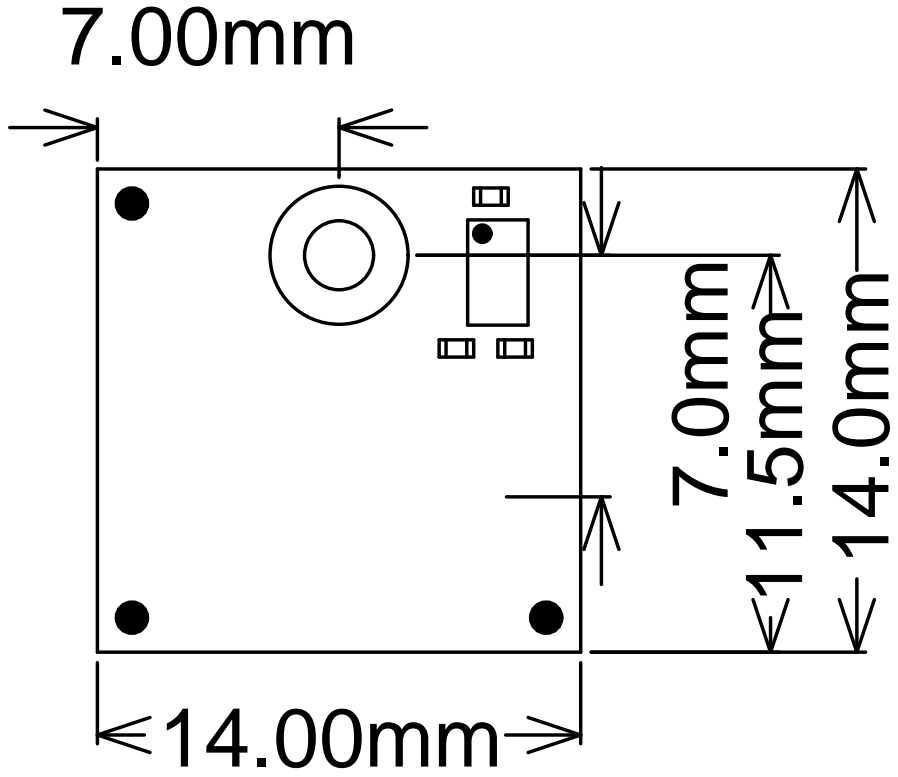
[picture p48: page 1]

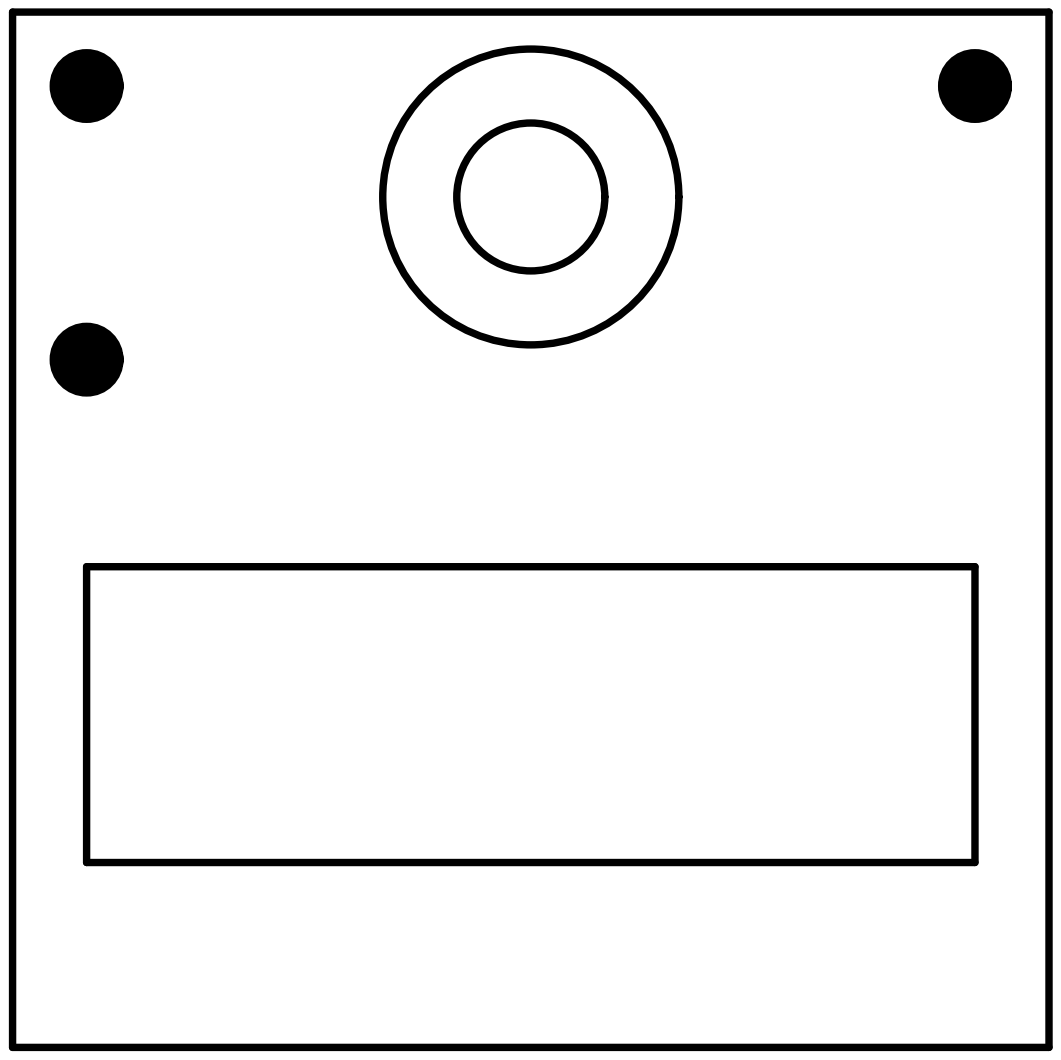
[picture p49: page 2]
