micro-FPGA/CRUVI/CAD/Altium/templates/CR99001/current/hw/pcb/manufacturing reports/PDF/SCH-CR00001-01-0.PDF

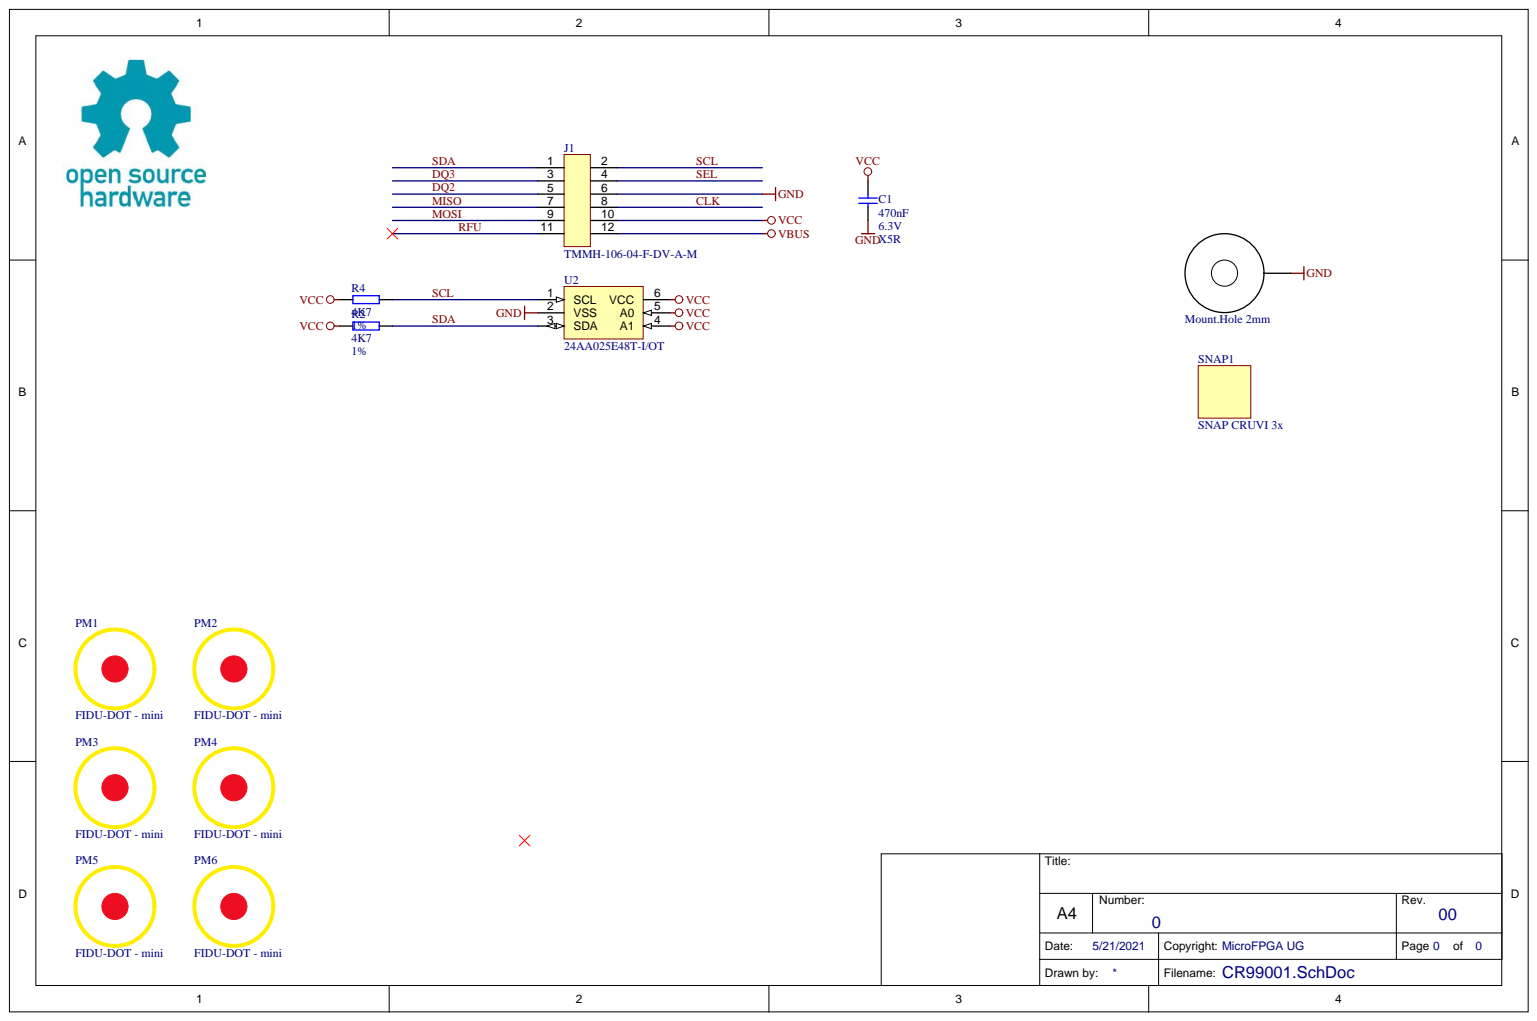
[picture p50: page 1]

Title:

A4 | Number: 0 | Rev. 00

Date: 5/21/2021 | Copyright: MicroFPGA UG | Page 0 of 0
