micro-FPGA/CRUVI/CAD/Altium/boards/CR00101/docs/3DB-CR00101-01.PDF

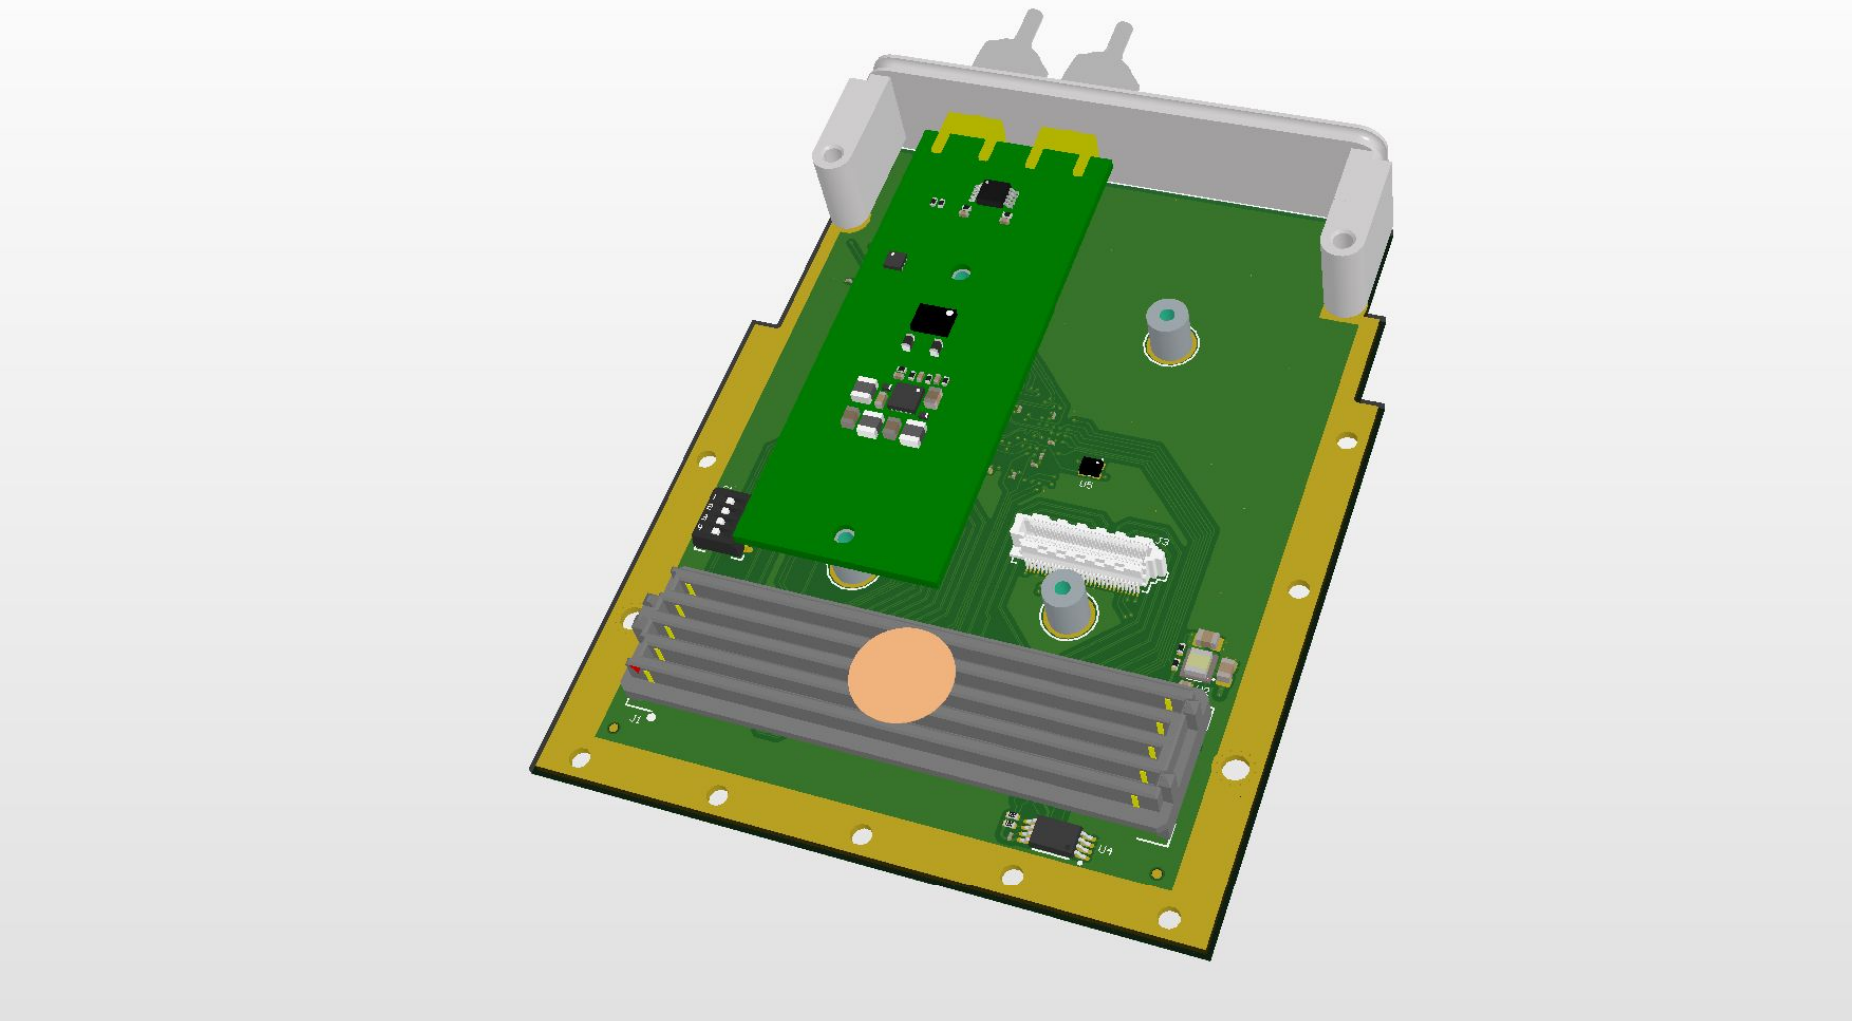
[picture p51: page 1]
