micro-FPGA/CRUVI/CAD/Altium/boards/CR00101/docs/3DT-CR00101-01.PDF

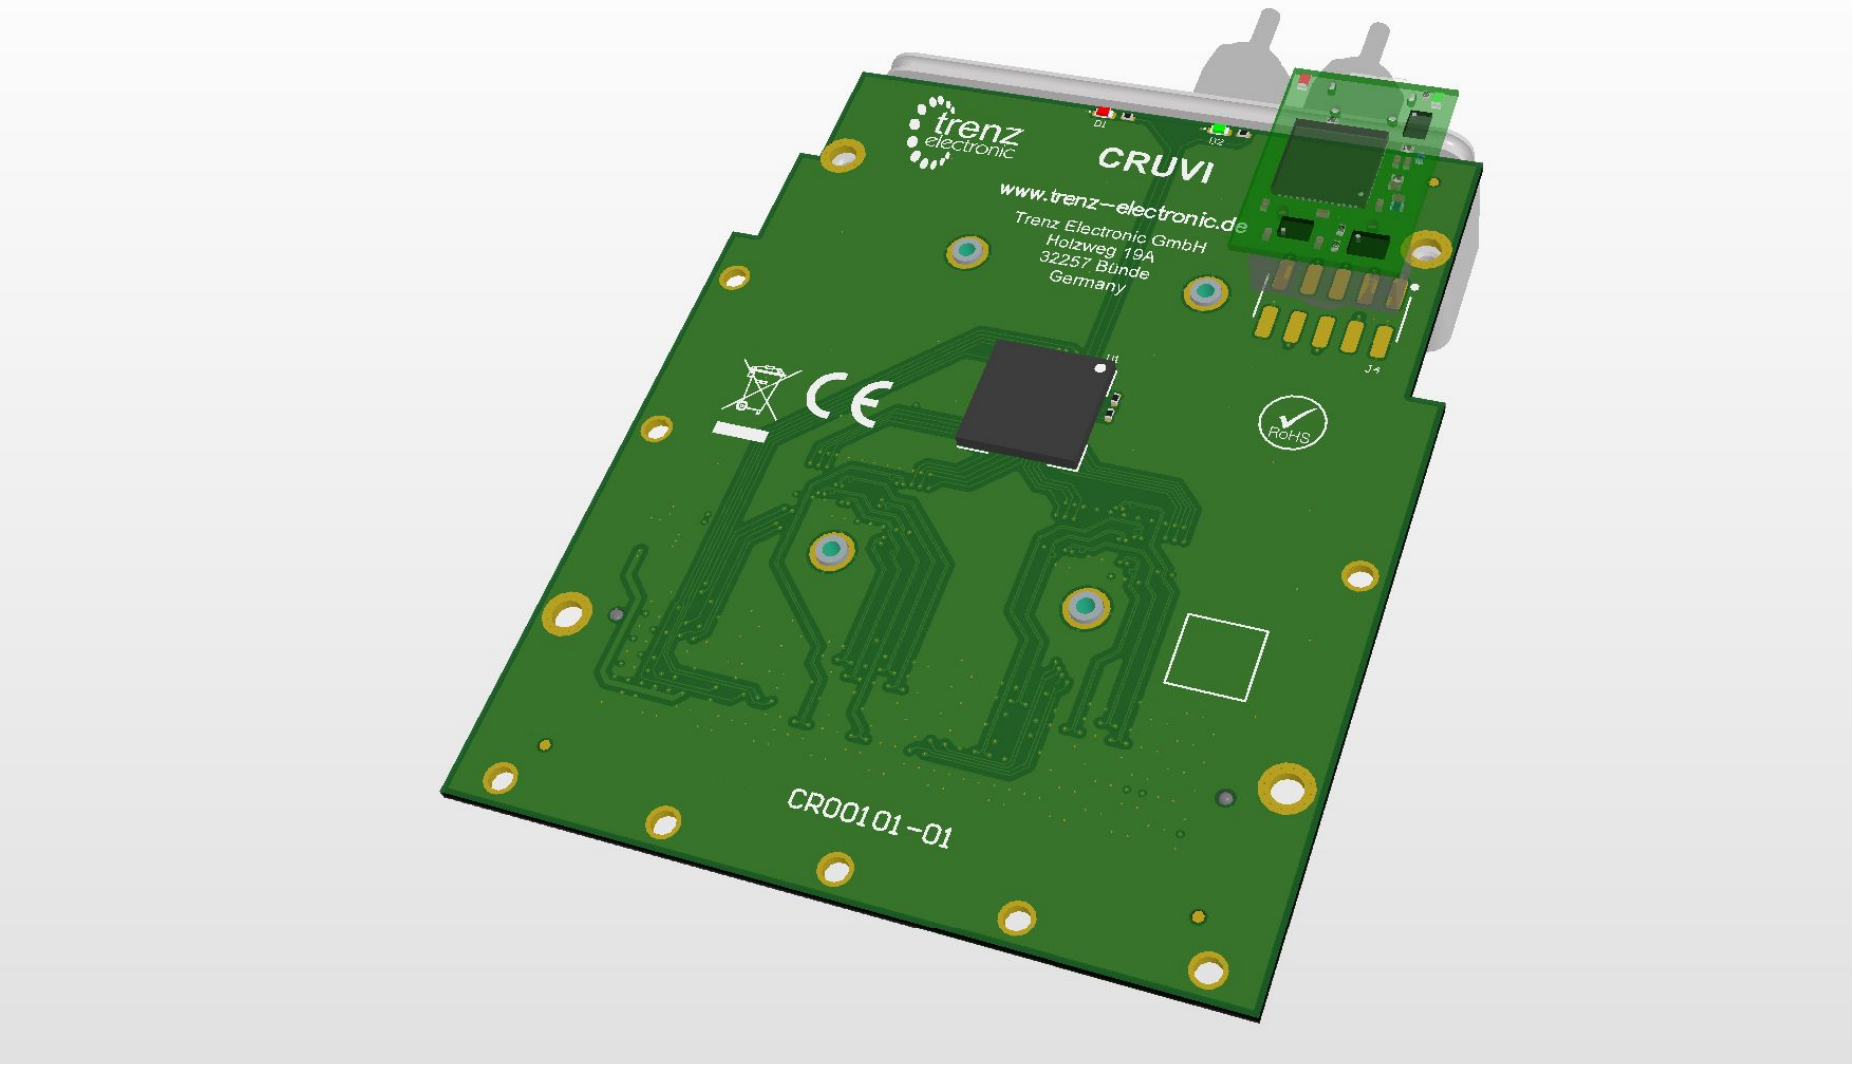
[picture p52: page 1]
