micro-FPGA/CRUVI/CAD/Altium/boards/CR00101/docs/AD-CR00101-01.PDF

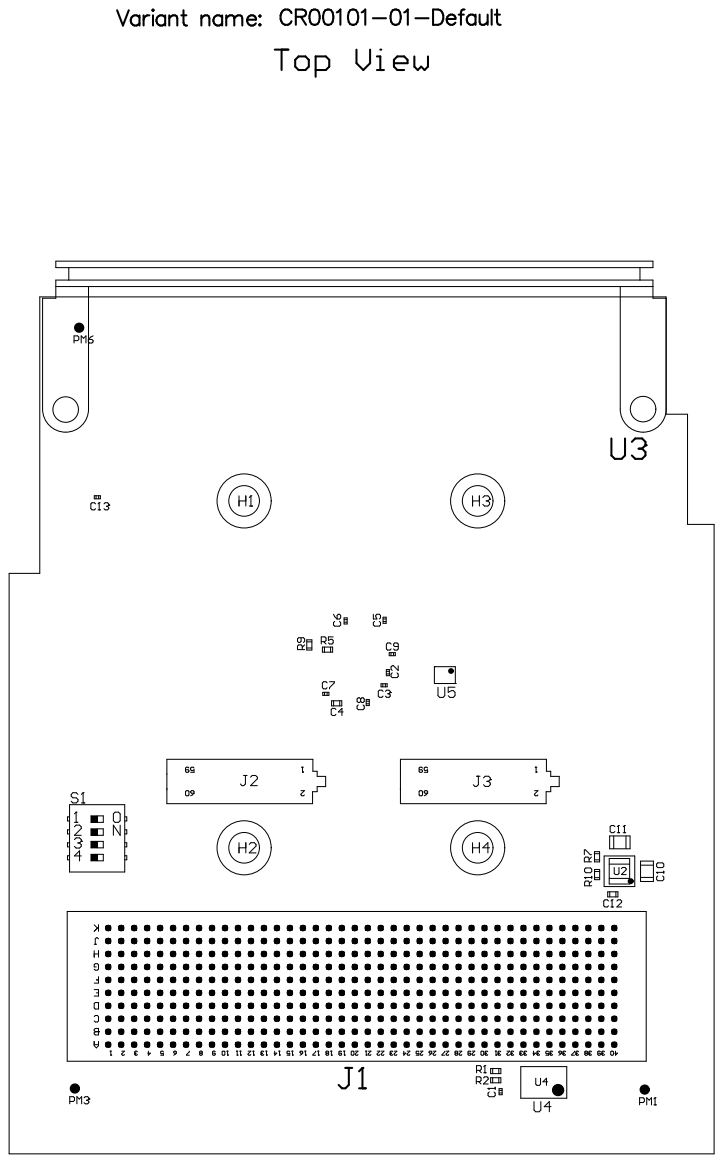
[picture p53: page 1]

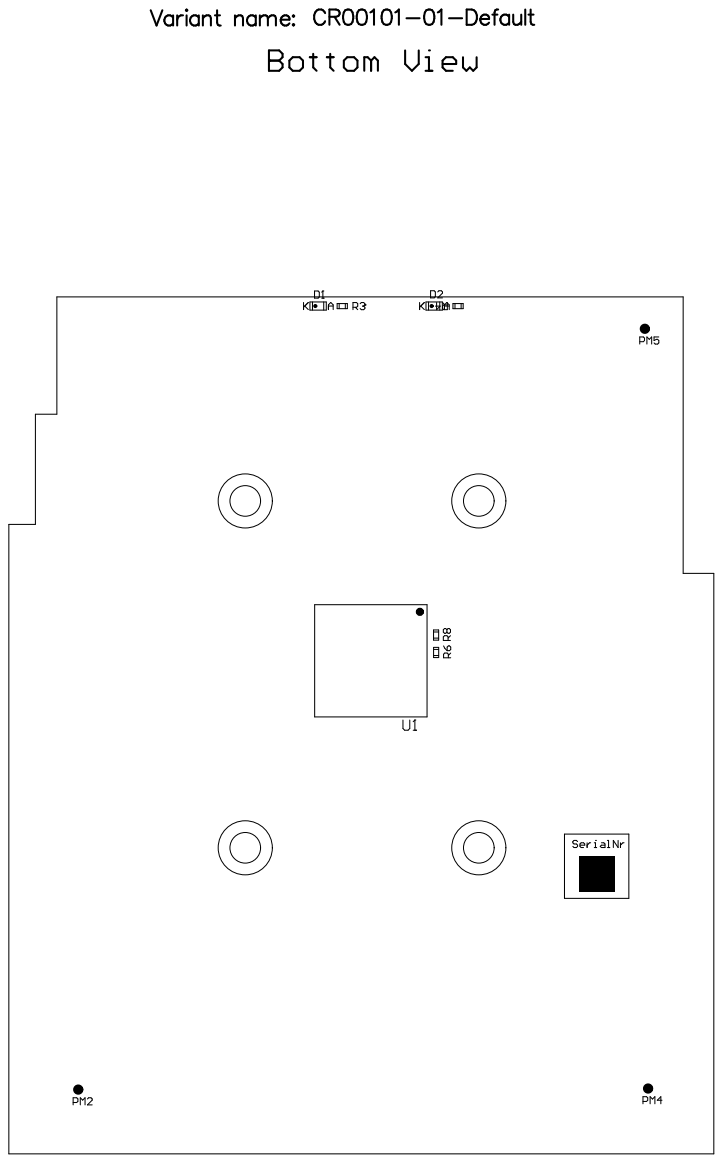
[picture p54: page 2]

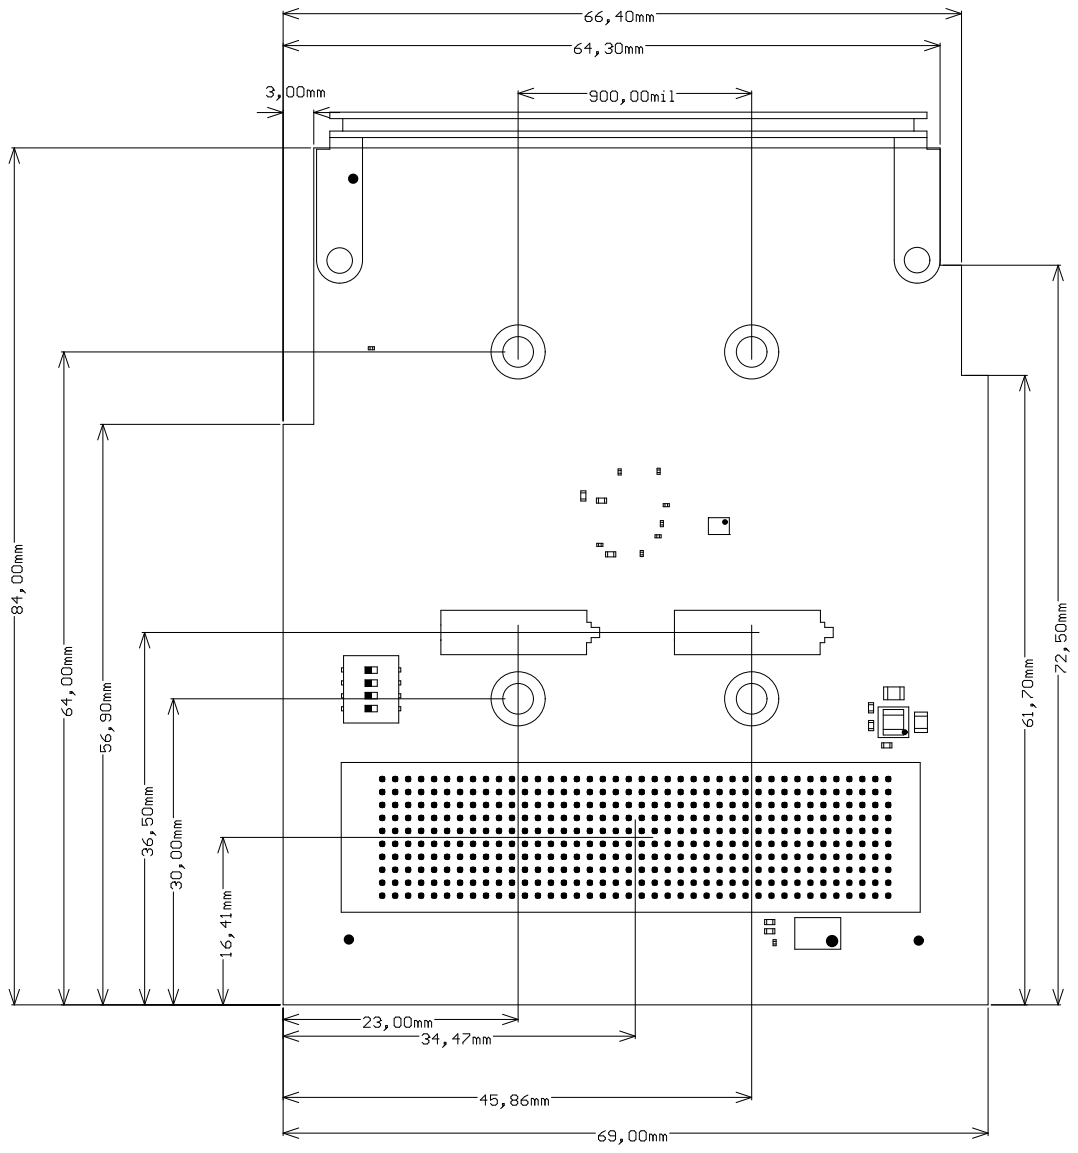
[picture p55: page 3]

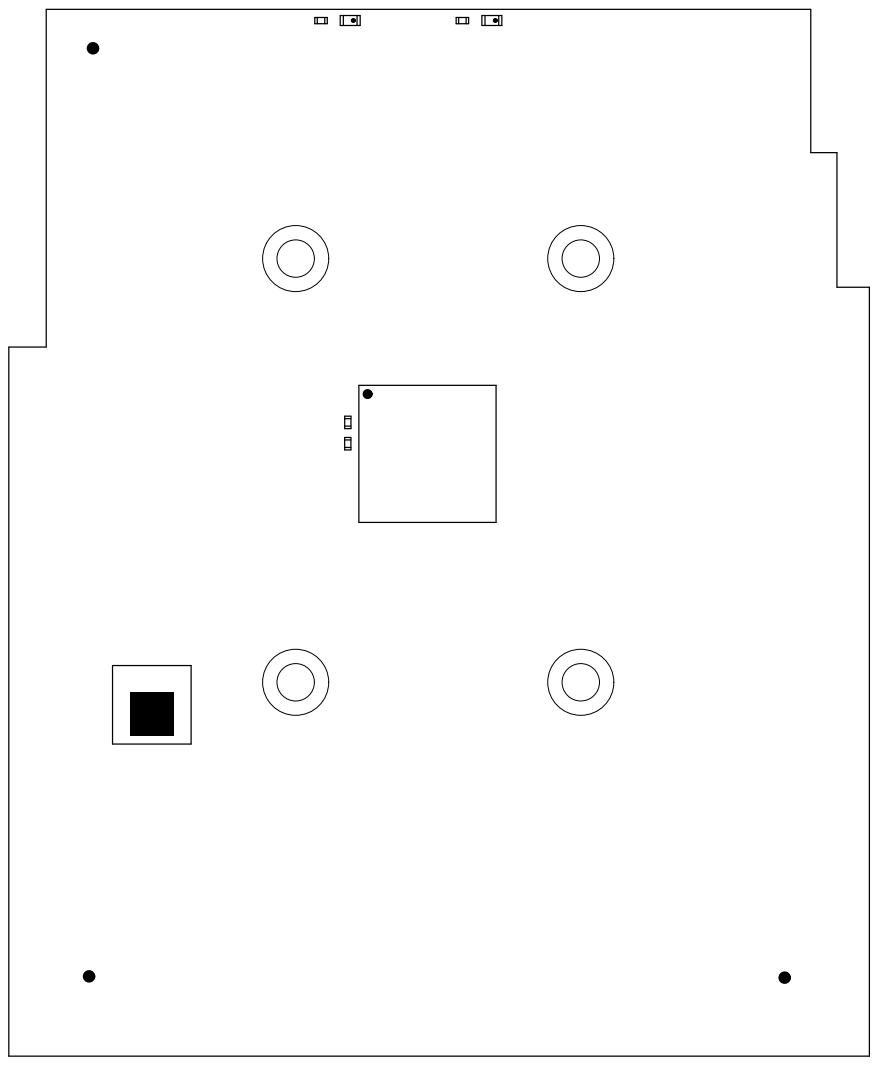
[picture p56: page 4]
