micro-FPGA/CRUVI/CAD/Altium/boards/CR00101/docs/SCH-CR00101-01.PDF

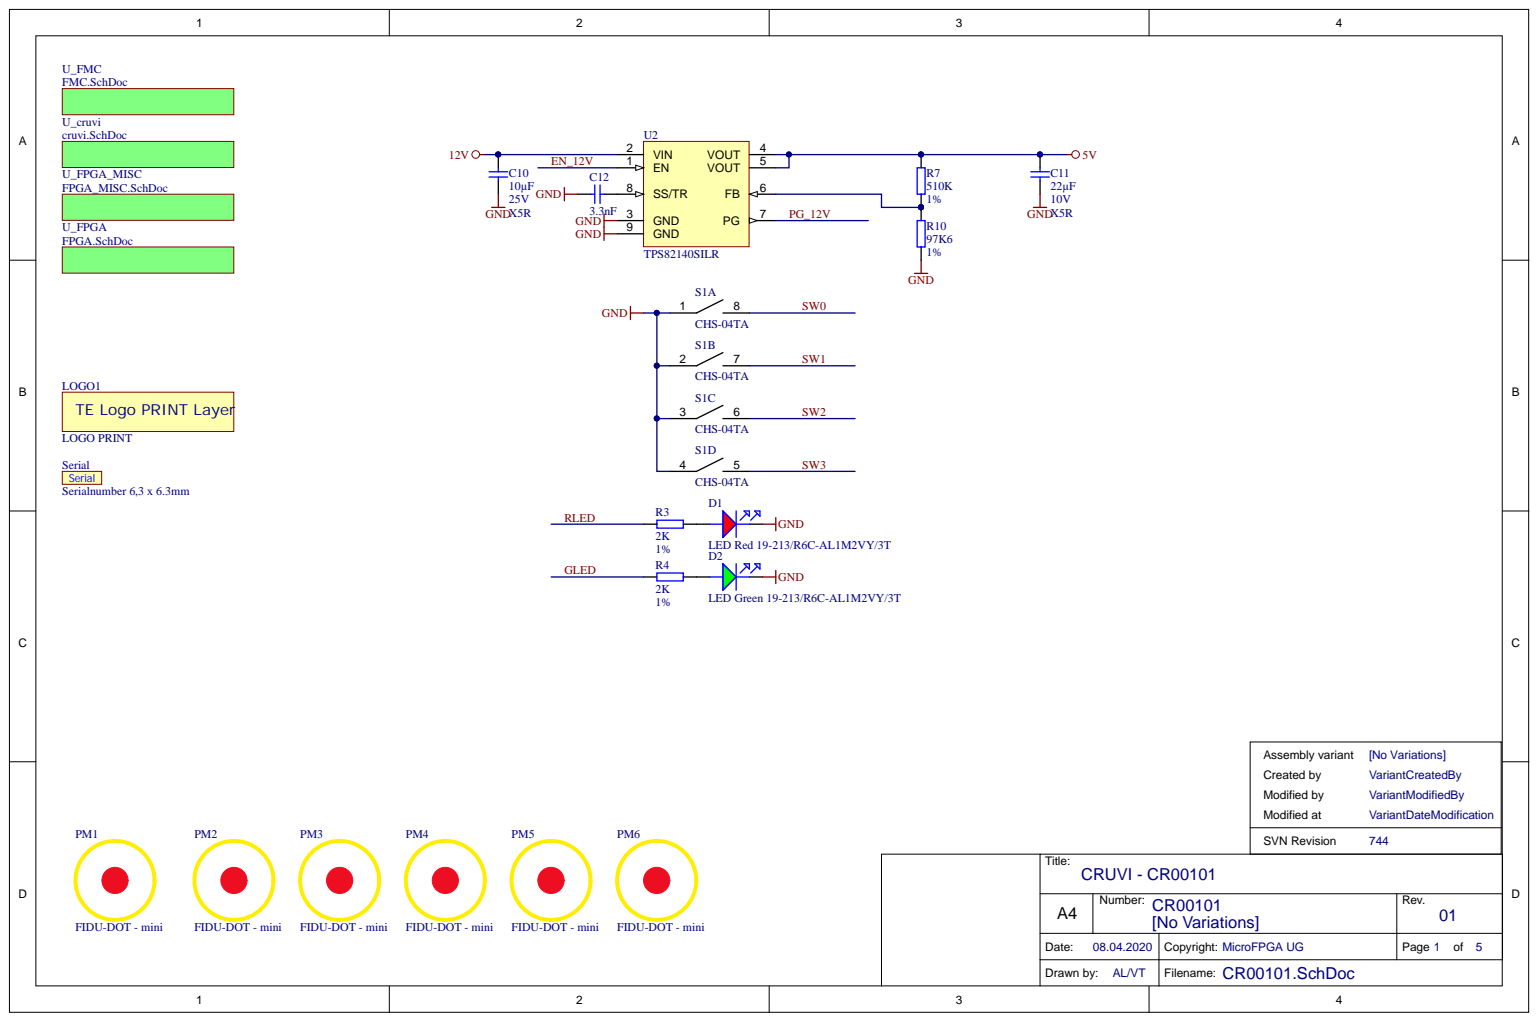
[picture p57: page 1]

LOGO1
TE Logo PRINT Layer

Title: CRUVI - CR00101

A4 | Number: CR00101 [No Variations] | Rev. 01

Date: 08.04.2020 | Copyright: MicroFPGA UG | Page 1 of 5

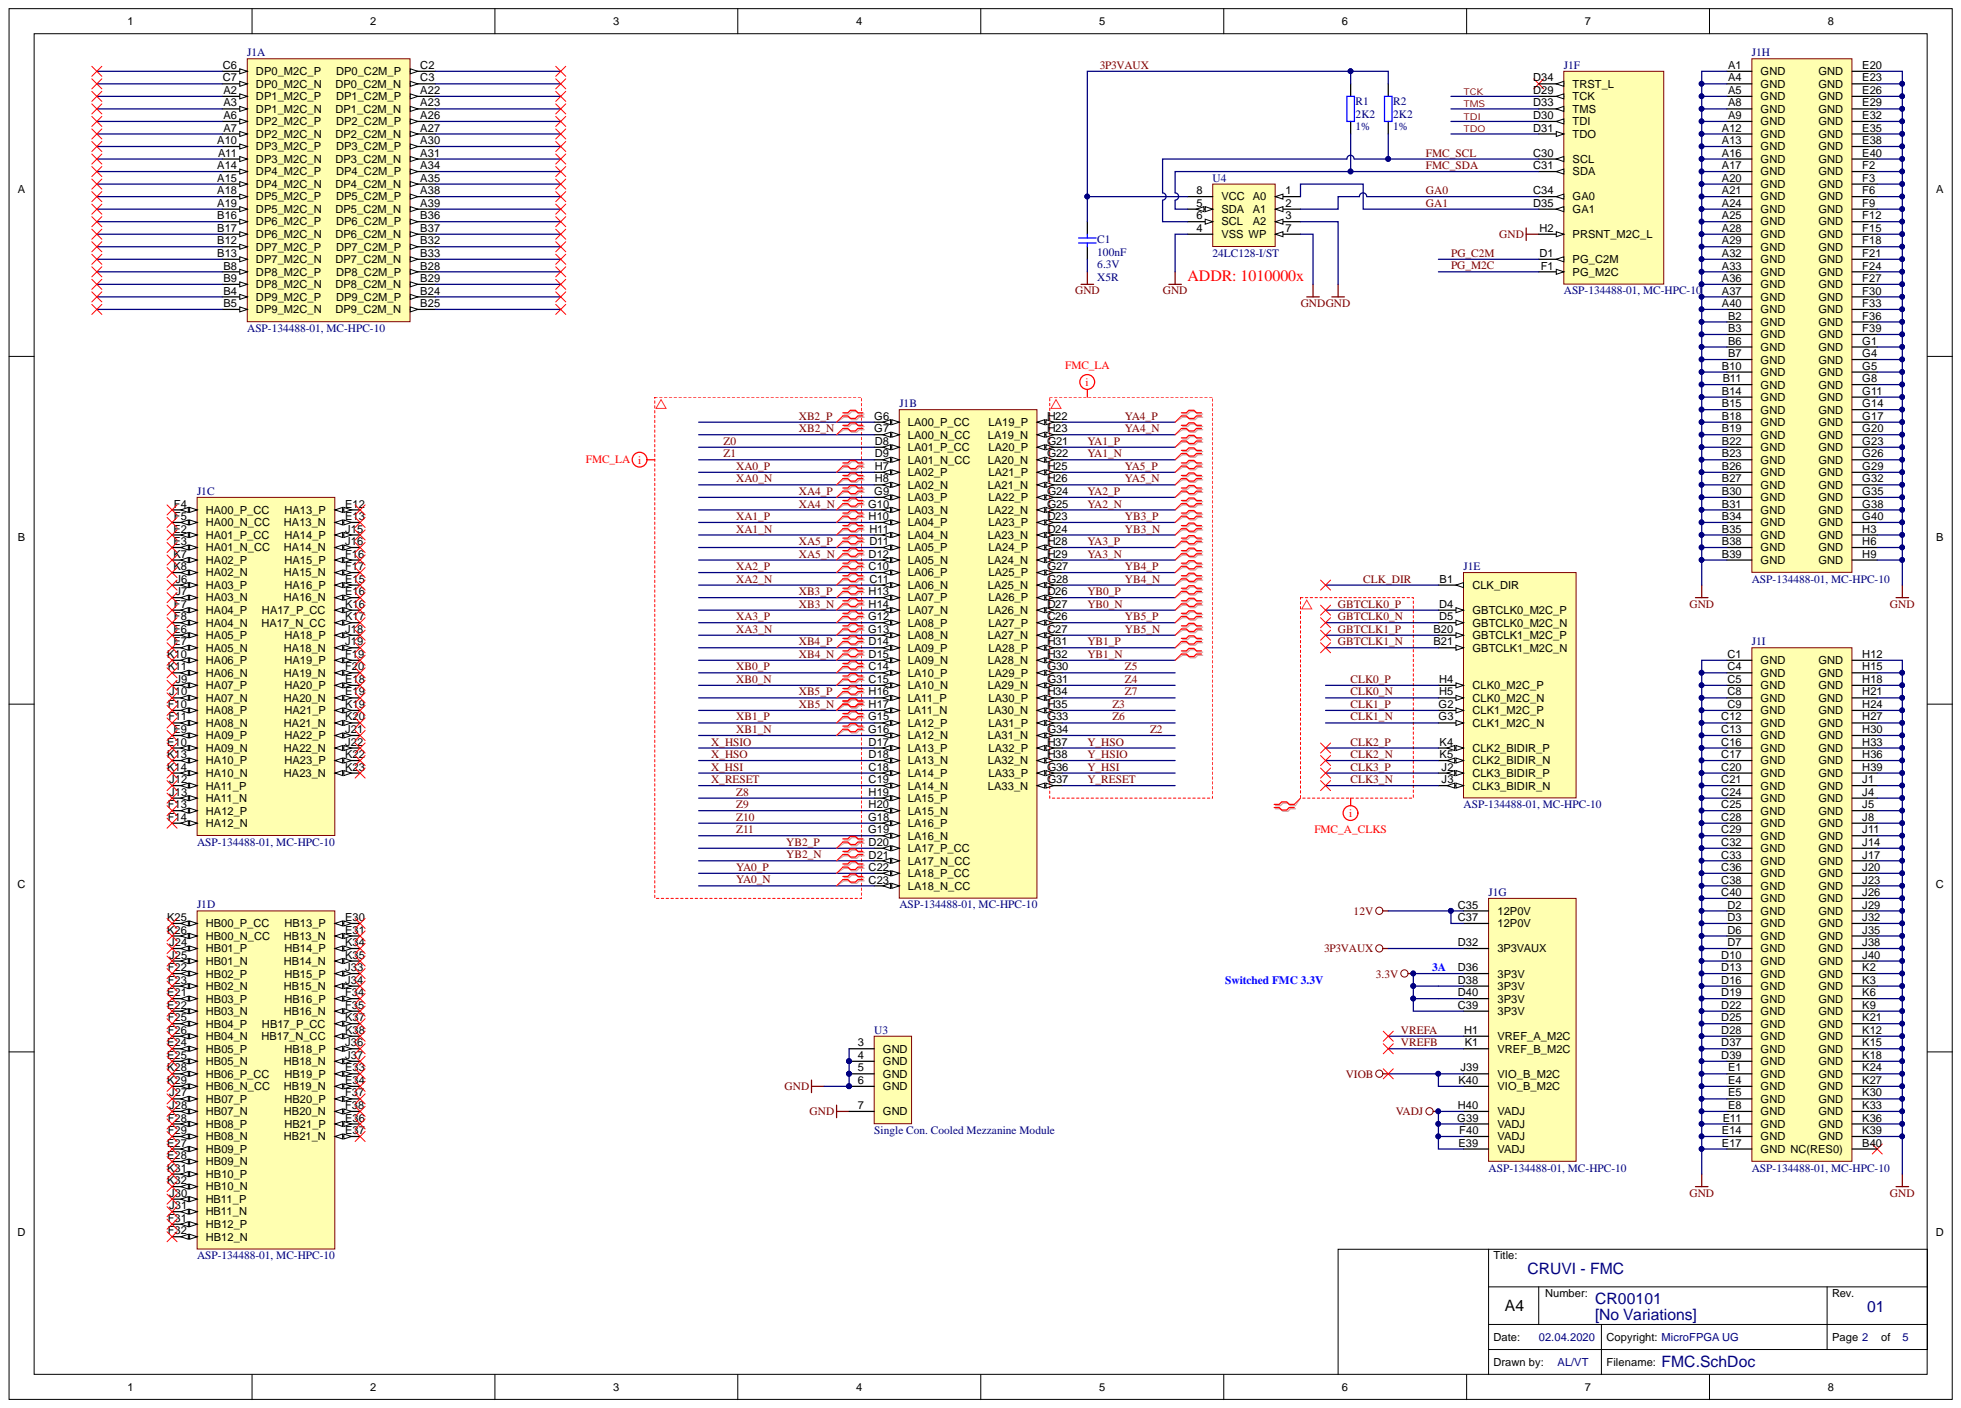
[picture p58: page 2]

PG_M2C TMS TDI TDO TCK

U4 | | | | SDA C31 GA0 C34

FMC_SDA

5 | VCC A0 SDA A1 SCL A2 VSS WP | 2 | GA1

Title: CRUVI - FMC

A4 | Number: CR00101 [No Variations] | 01 Rev.

Date: 02.04.2020 | Copyright: MicroFPG A UG | Page 2 of 5

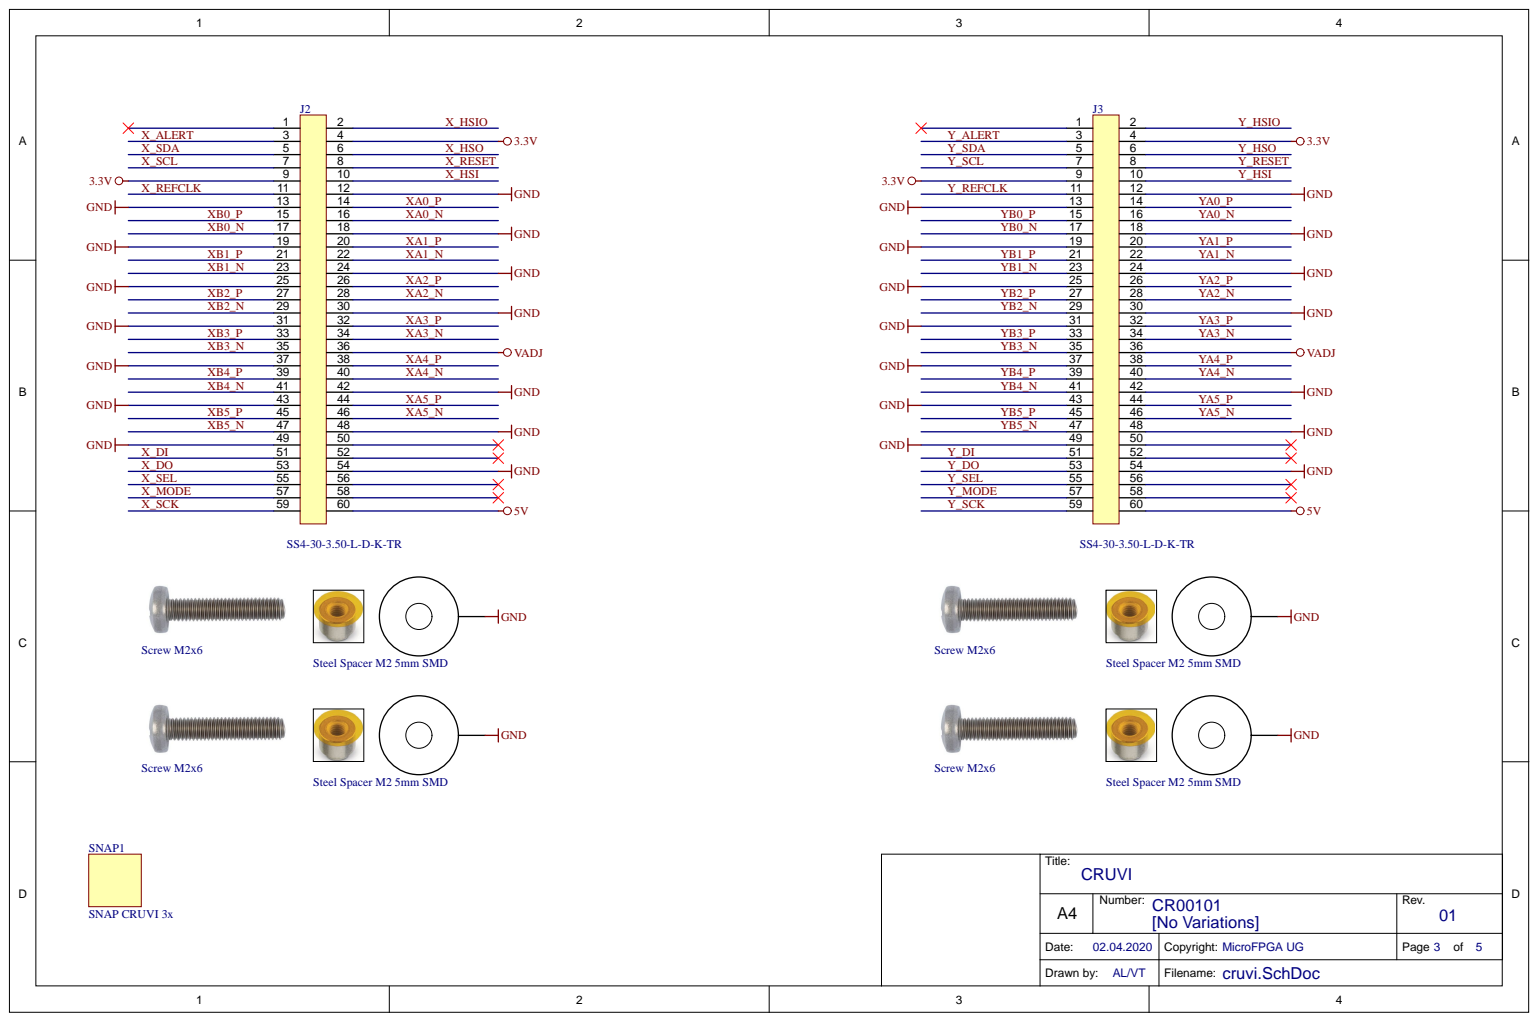
[picture p59: page 3]

Title: CRUVI

A4 | Number: CR00101 [No Variations] | Rev . 01

Date: 02.04.2020 | Copyright: MicroFPGA UG | Page 3 of 5

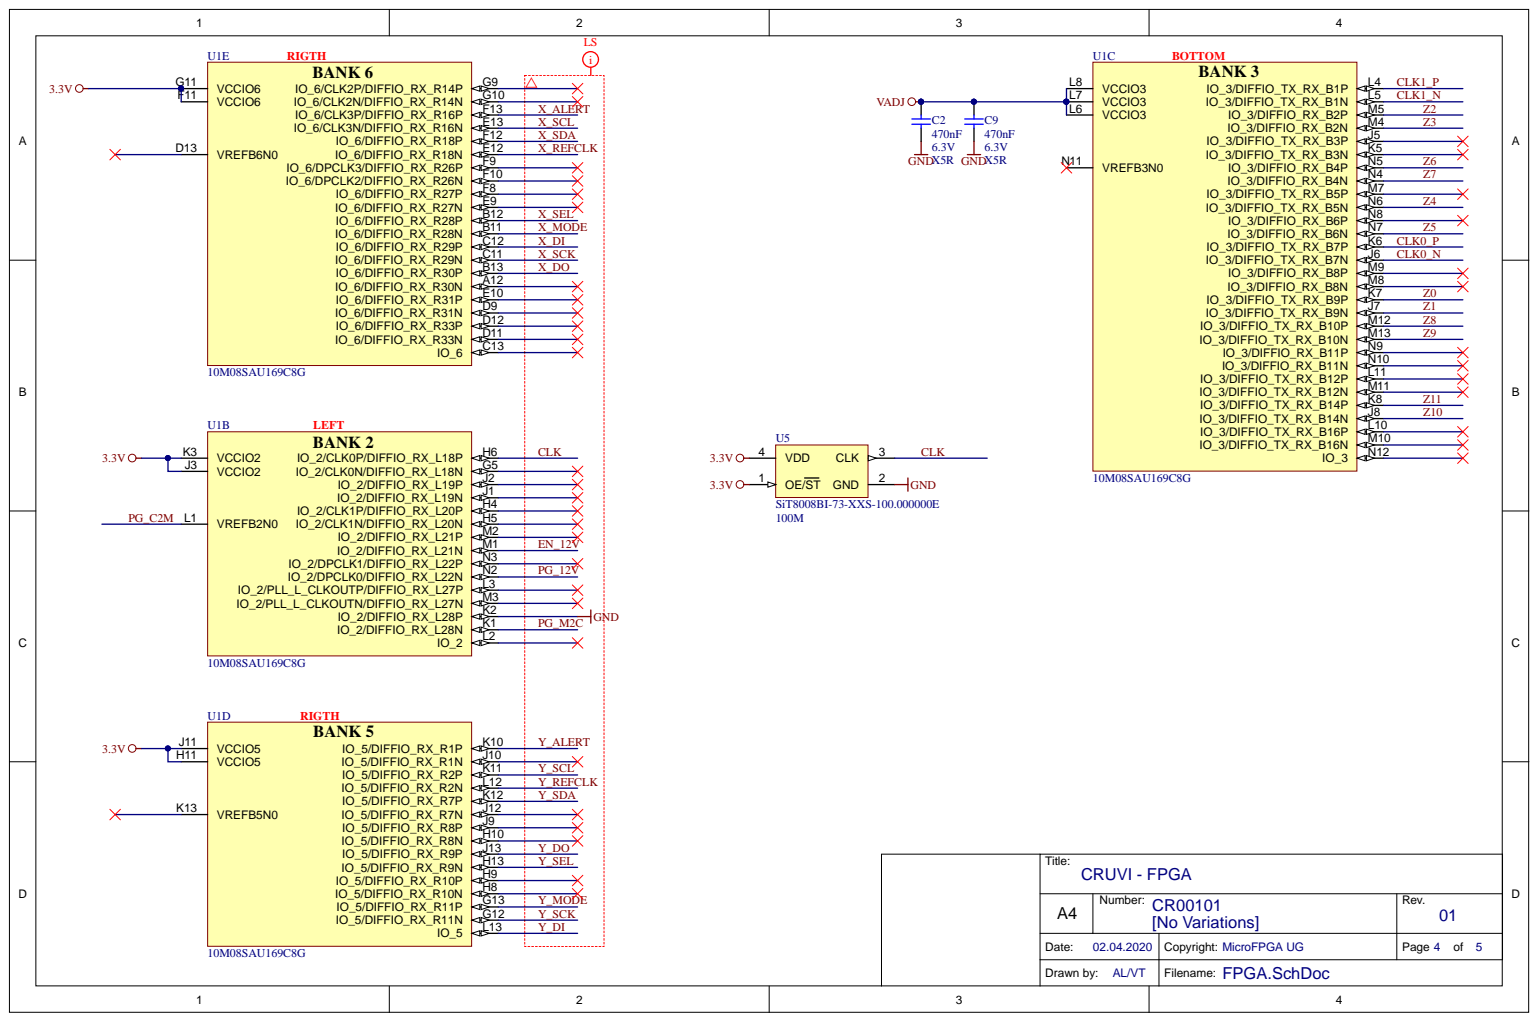
[picture p60: page 4]

Title: CRUVI - FPGA

A4 | Number: CR00101 [No Variations] | Rev . 01

Date: 02.04.2020 | Copyright: MicroFPGA UG | Page 4 of 5

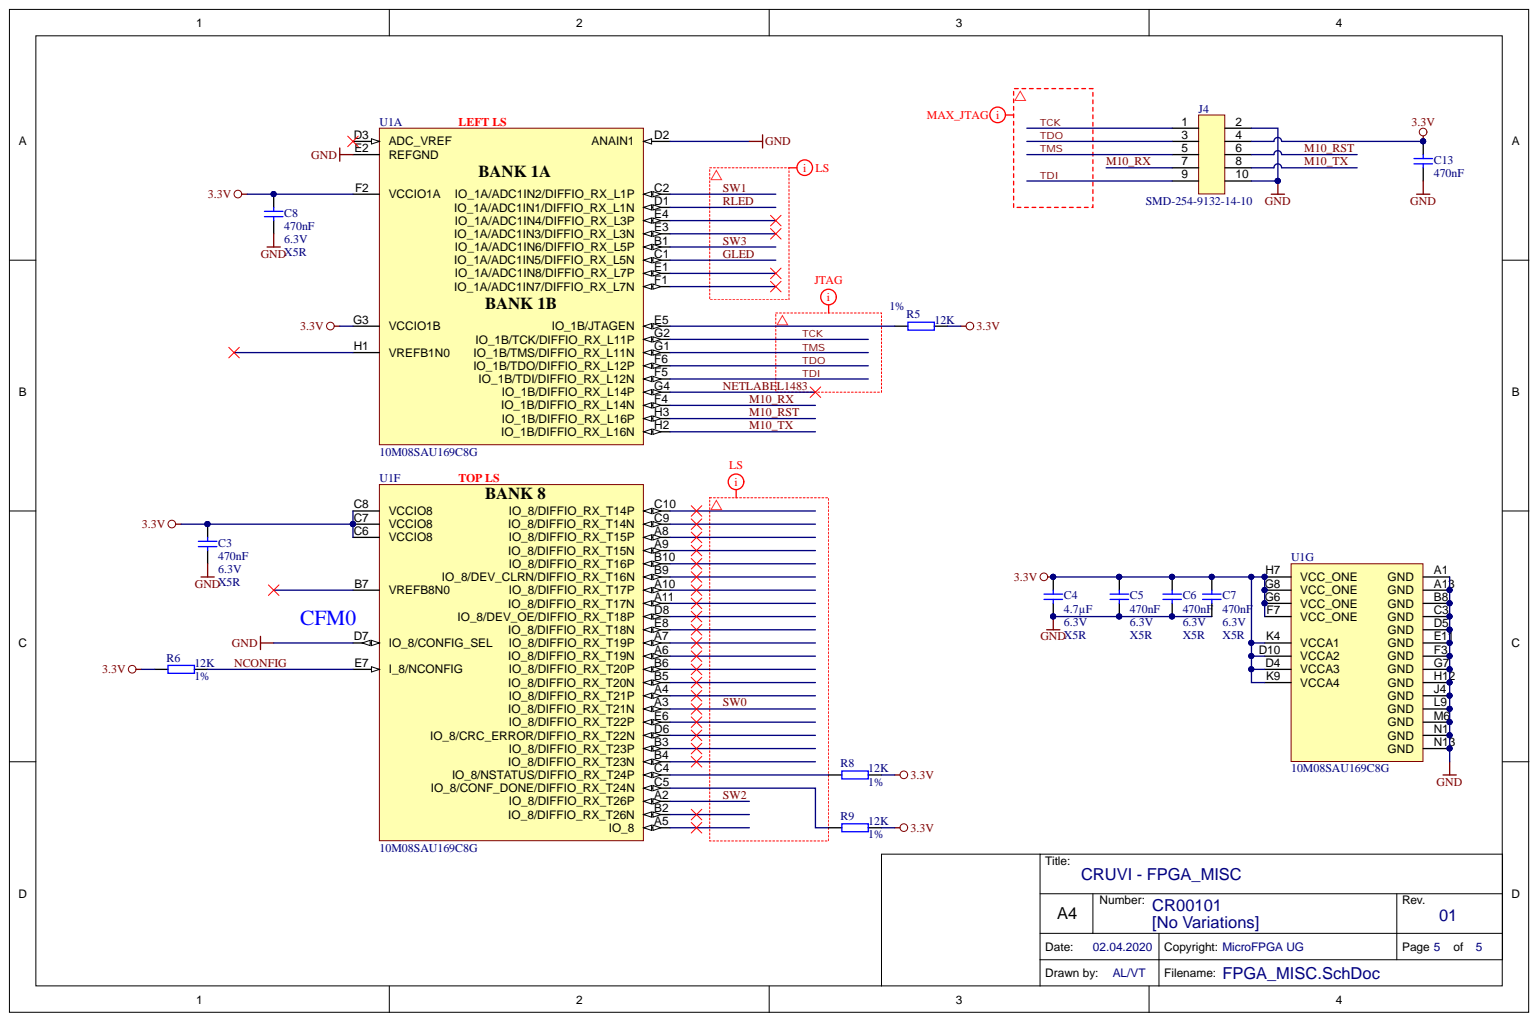
[picture p61: page 5]

Title: CRUVI - FPGA_MISC

A4 | Number: CR00101 [No Variations] | Rev . 01

Date: 02.04.2020 | Copyright: MicroFPGA UG | Page 5 of 5
