micro-FPGA/CRUVI/CAD/Altium/boards/CR00041/docs/3DB-CR00041-02-1.PDF

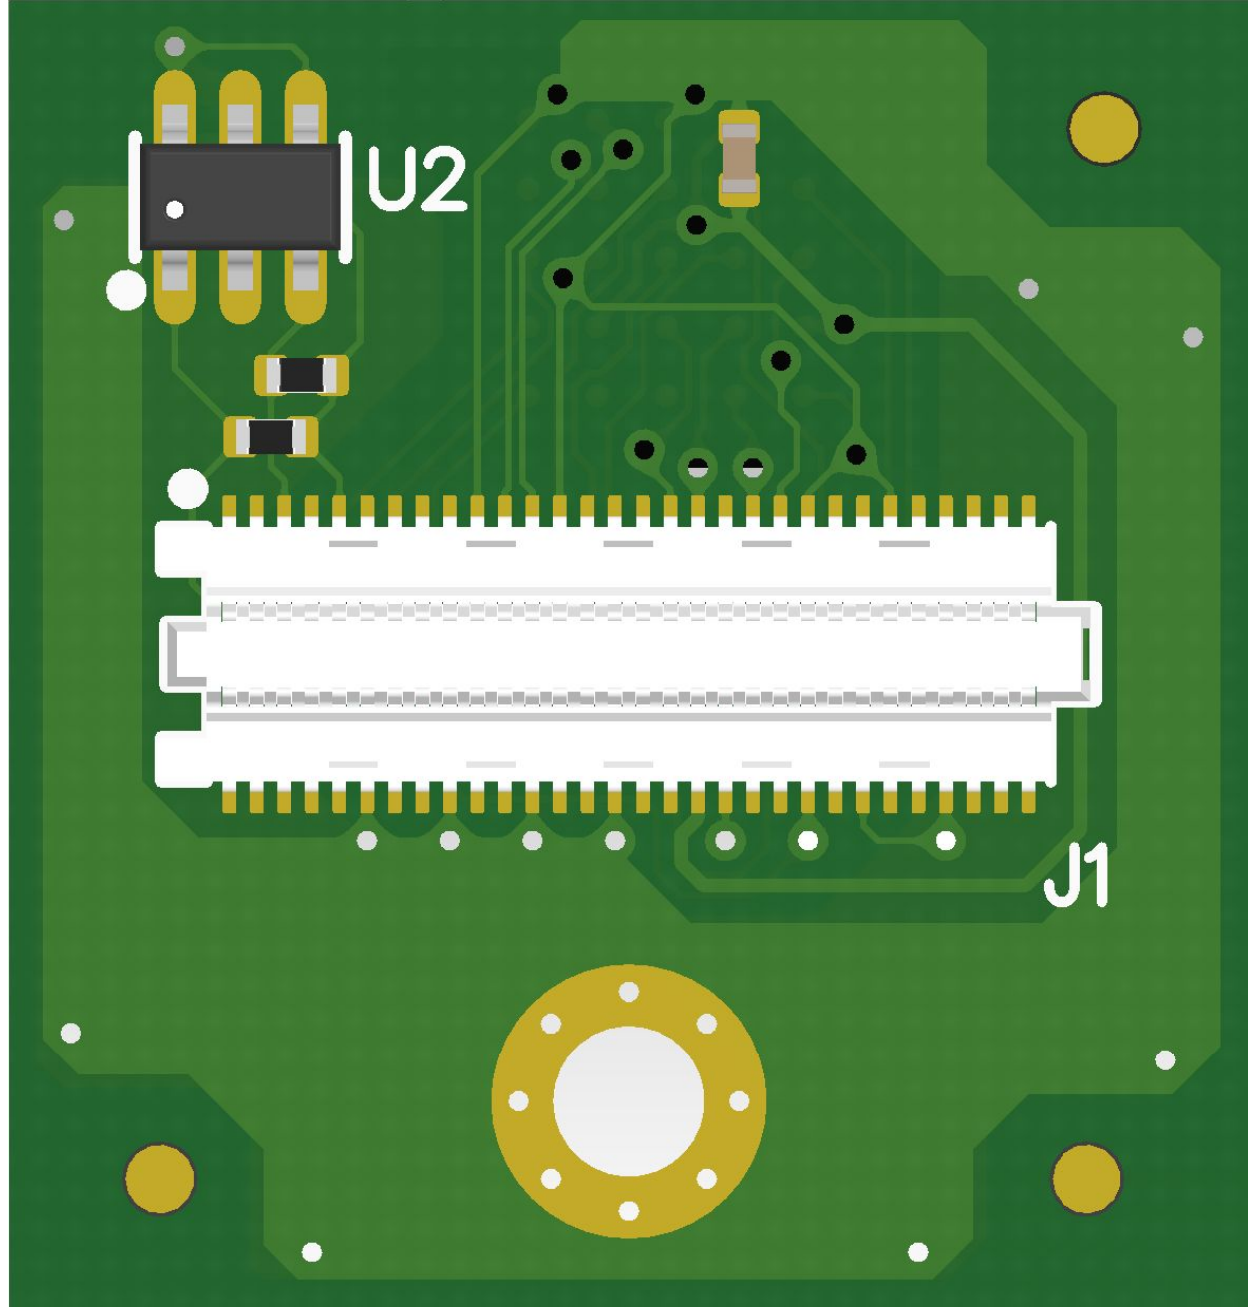
[picture p62: page 1]
