micro-FPGA/CRUVI/CAD/Altium/boards/CR00041/docs/3DT-CR00041-02-1.PDF

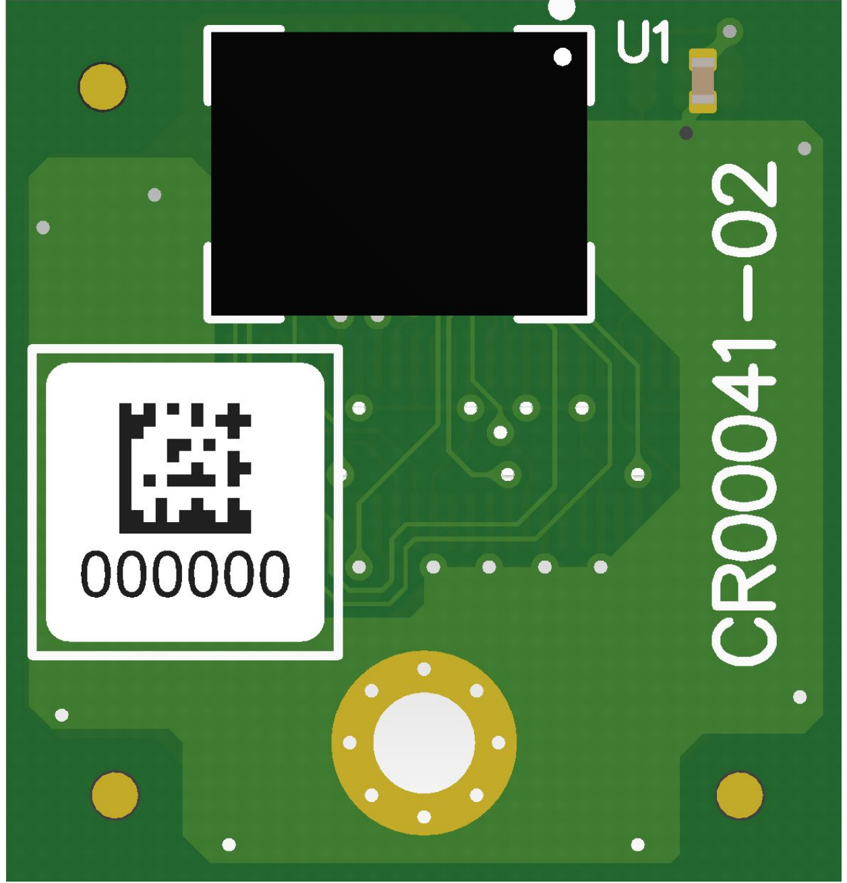
[picture p63: page 1]
