micro-FPGA/CRUVI/CAD/Altium/boards/CR00041/docs/AD-CR00041-02-1.PDF

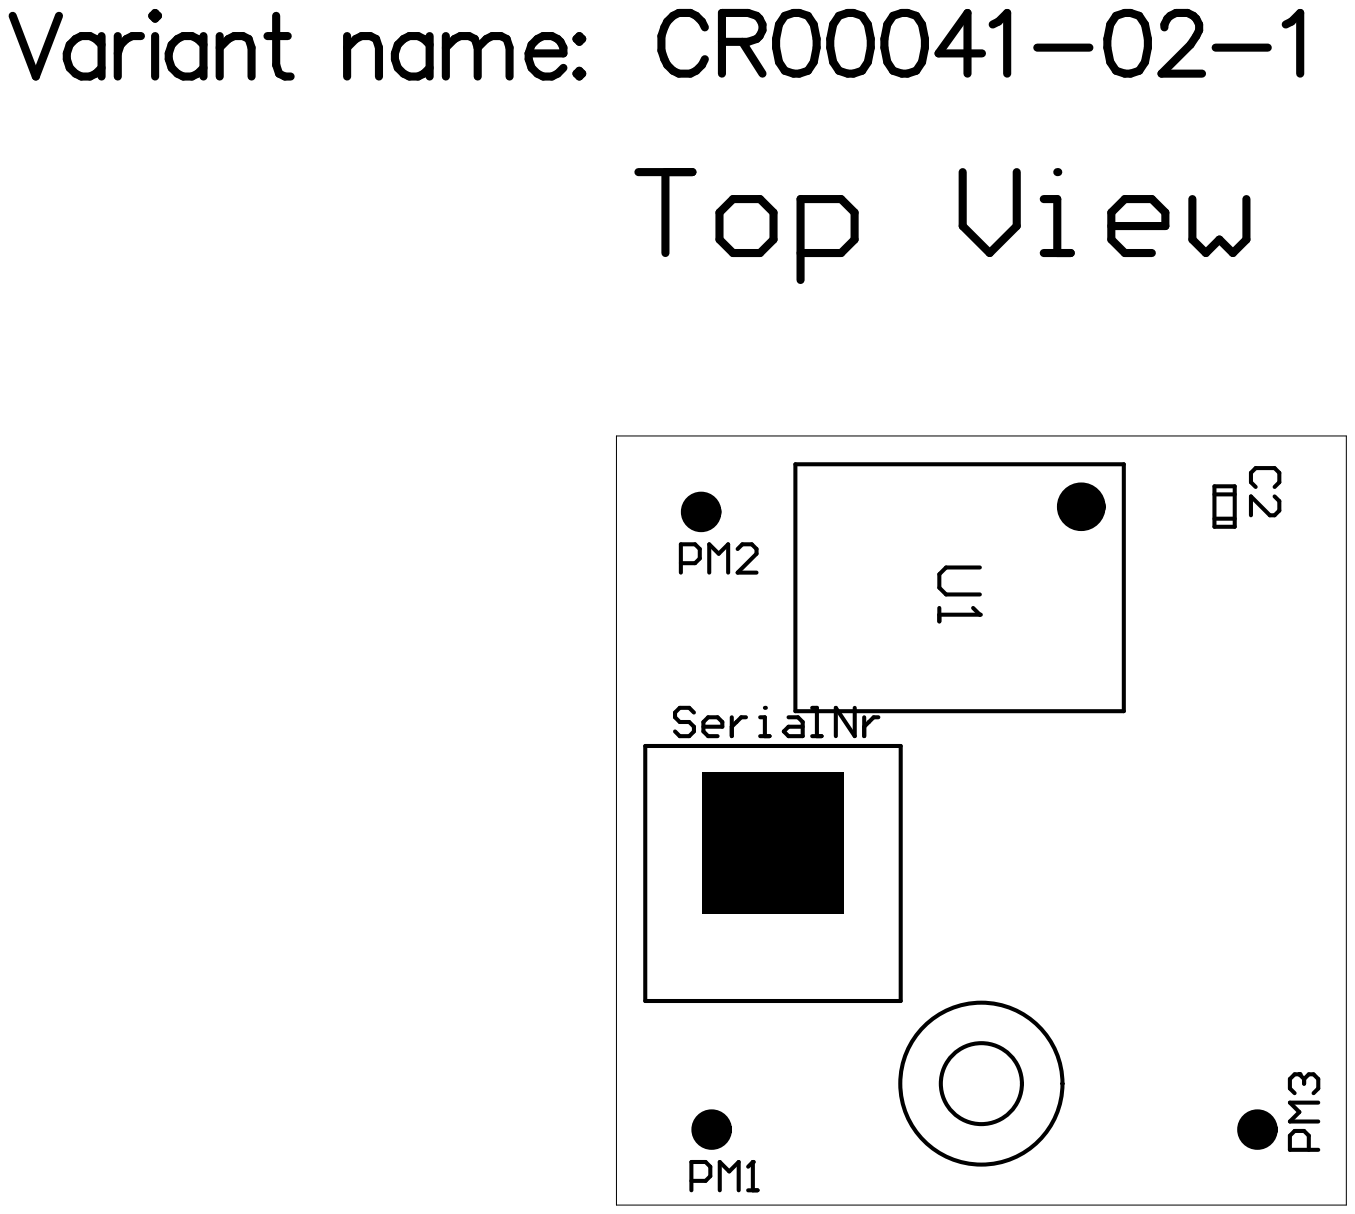
[picture p64: page 1]

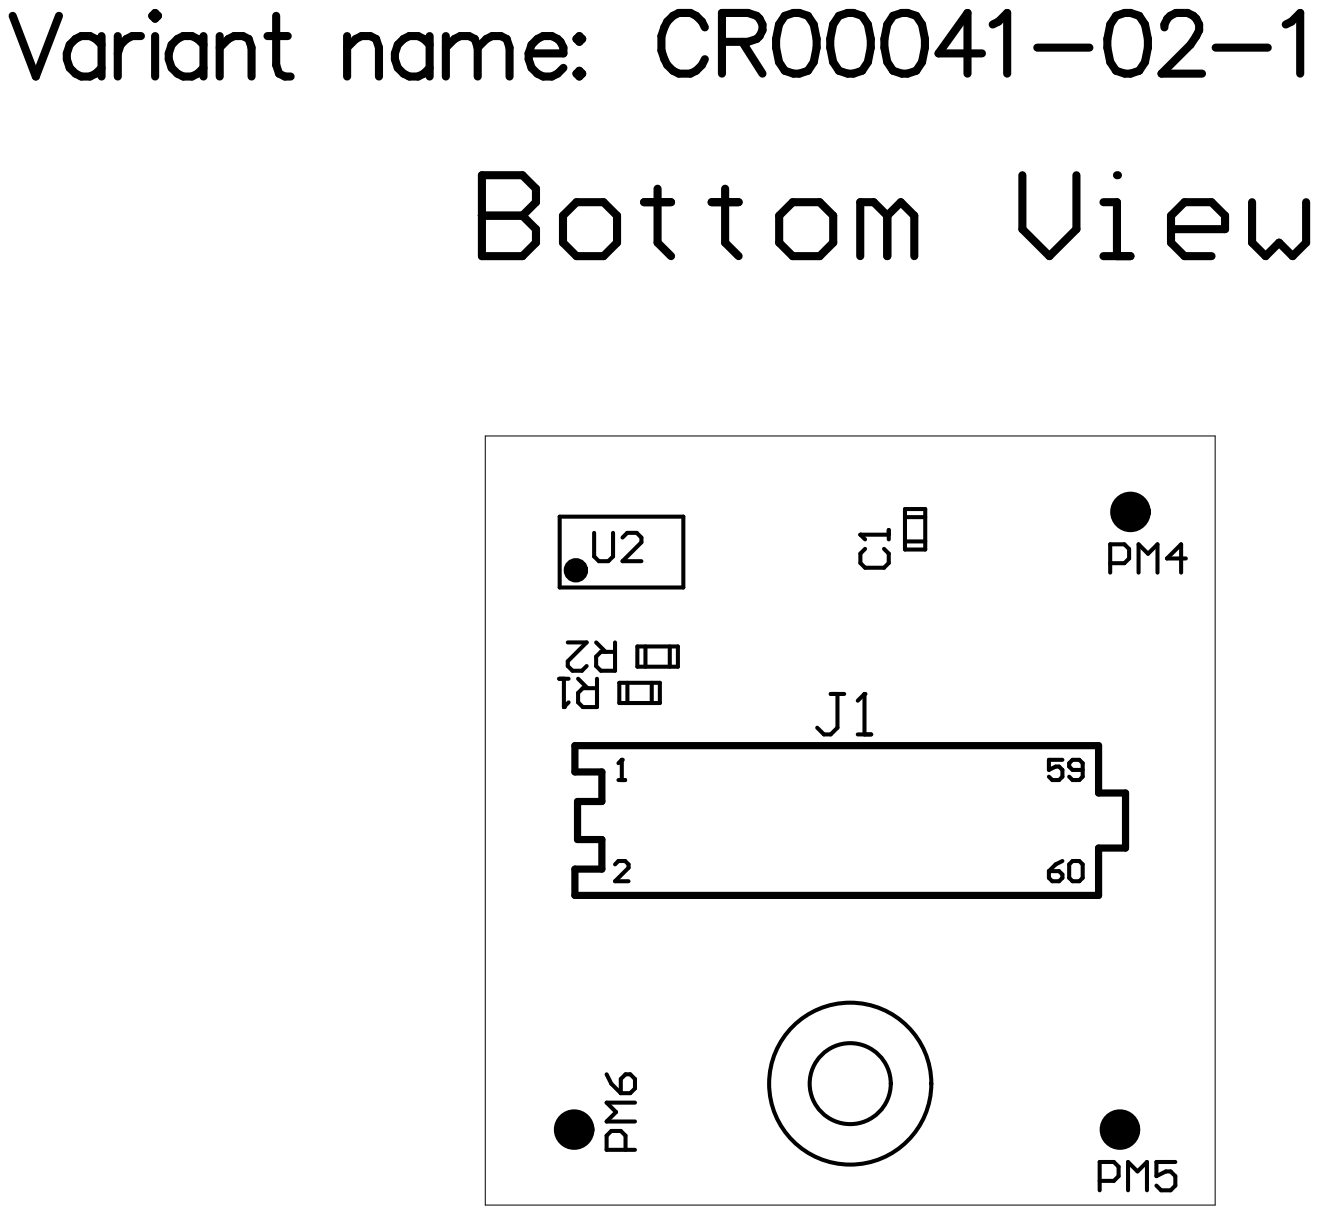
[picture p65: page 2]
