micro-FPGA/CRUVI/CAD/Altium/boards/CR00041/docs/DIM-CR00041-02-1.PDF

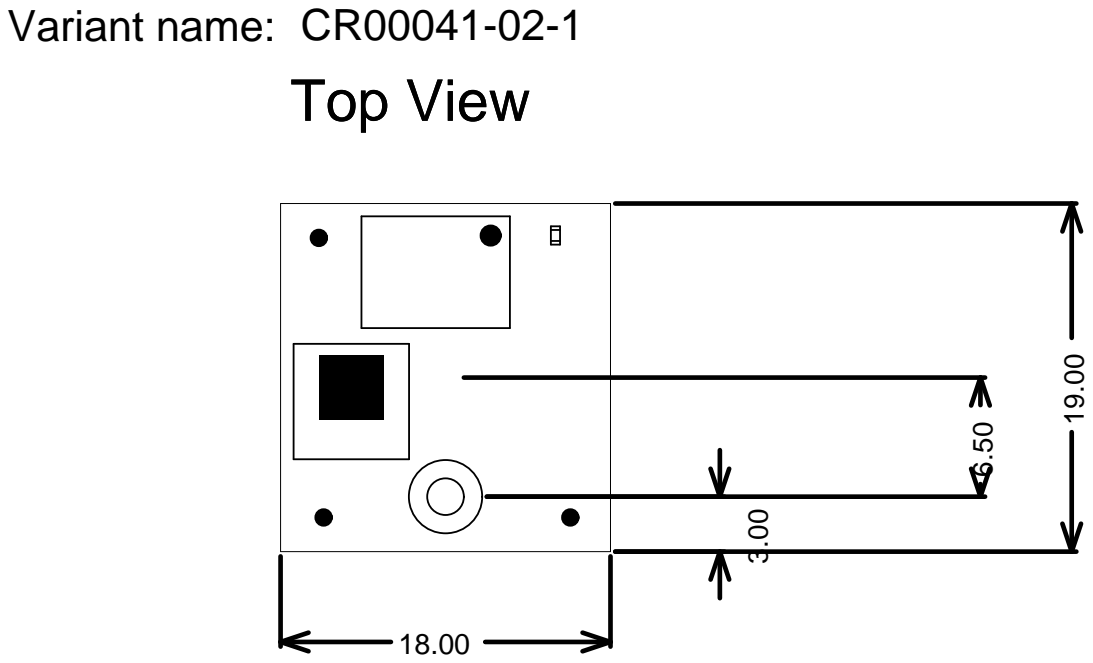
[picture p66: page 1]

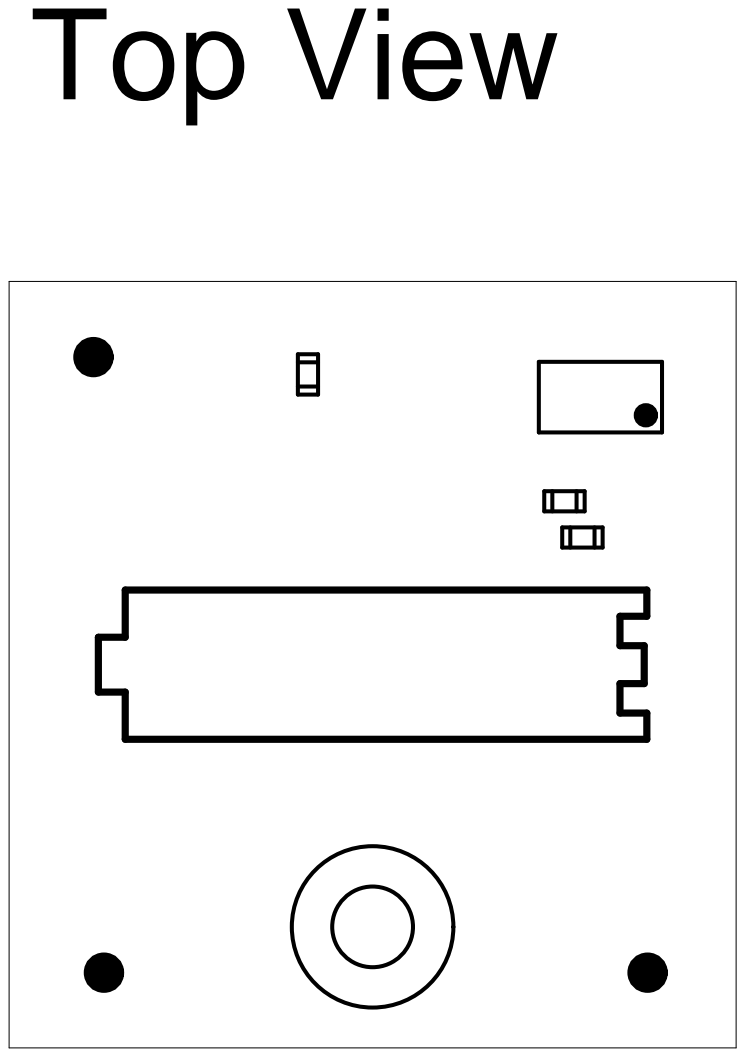
[picture p67: page 2]
