micro-FPGA/CRUVI/CAD/Altium/boards/CR00041/docs/SCH-CR00041-02-1.PDF

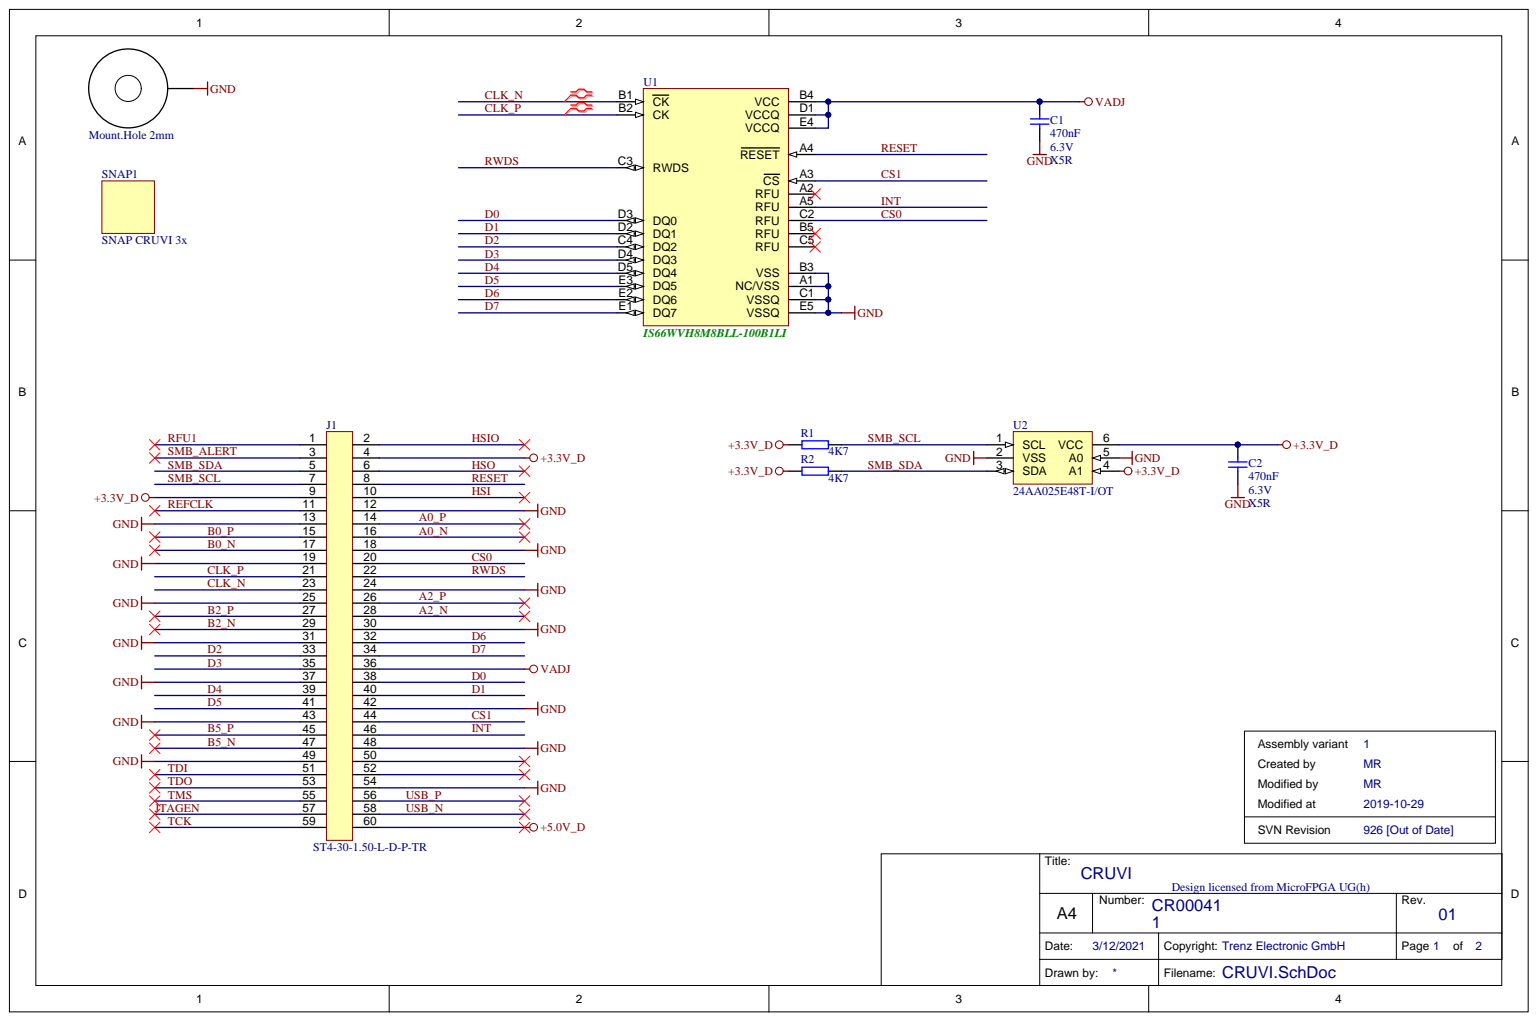
[picture p68: page 1]

Title: CRUVI Design licensed from MicroFPGA UG(h)

A4 | Number: CR00041 1 | Rev. 01

Date: 3/12/2021 | Copyright: Trenz Electronic GmbH | Page 1 of 2

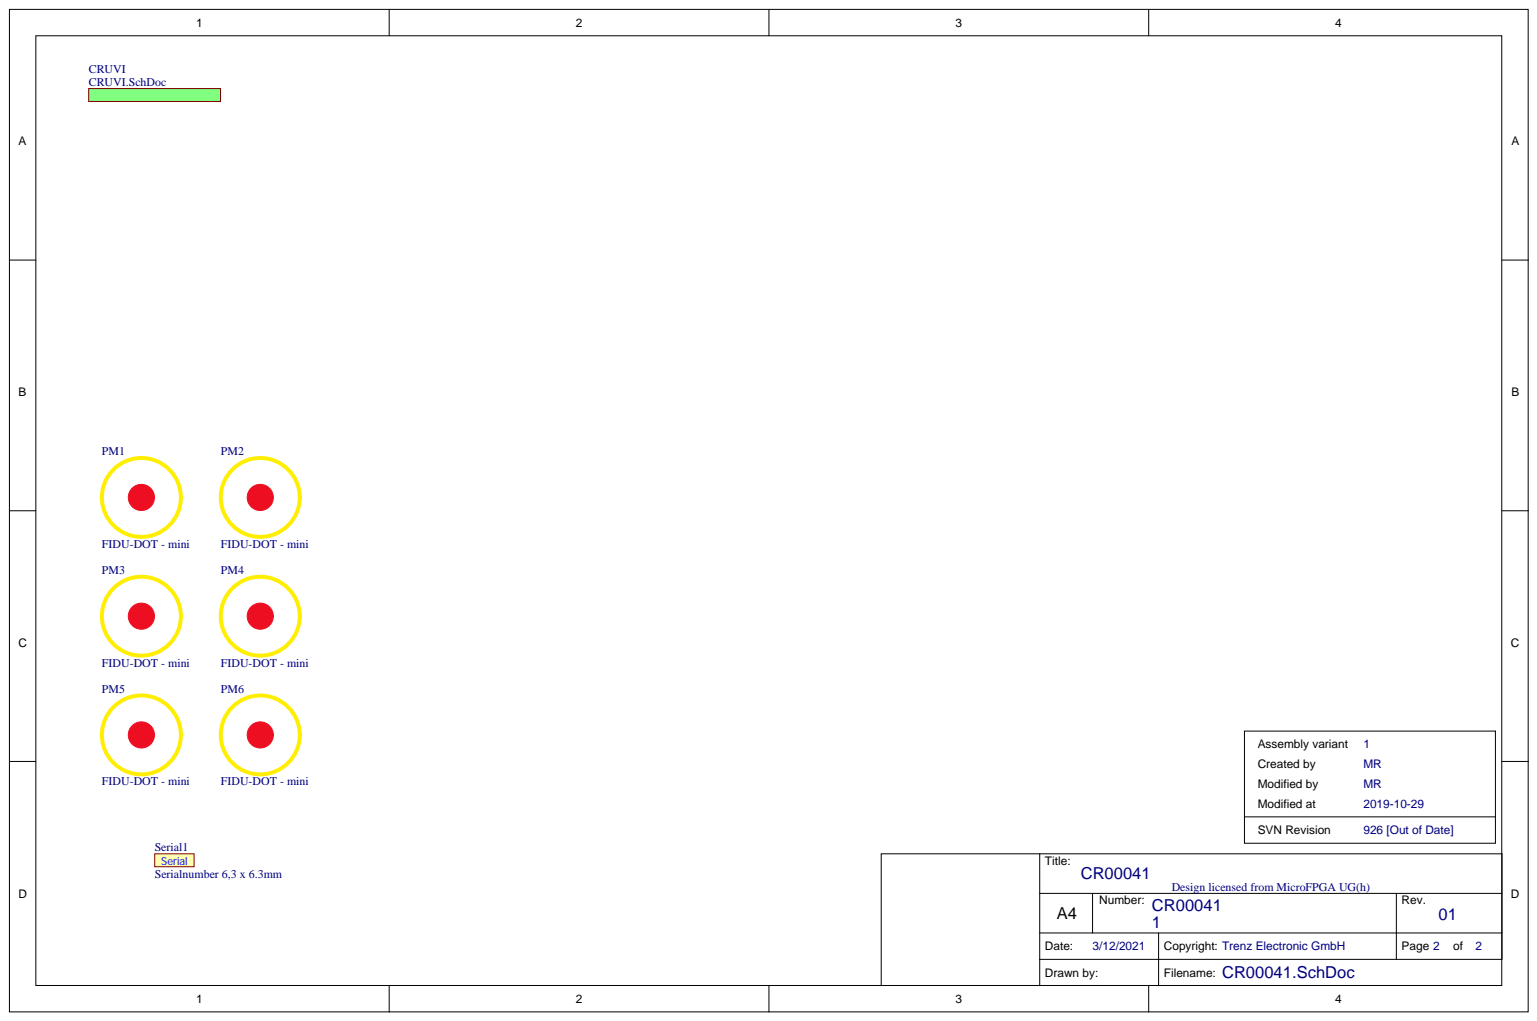
[picture p69: page 2]

Design licensed from MicroFPGA UG(h)

A4 | Number: CR00041 1 | Rev. 01

Date: 3/12/2021 | Copyright: Trenz Electronic GmbH | Page 2 of 2
