micro-FPGA/CRUVI/CAD/Altium/boards/CR00045/docs/3DB-CR00045-01-1.PDF

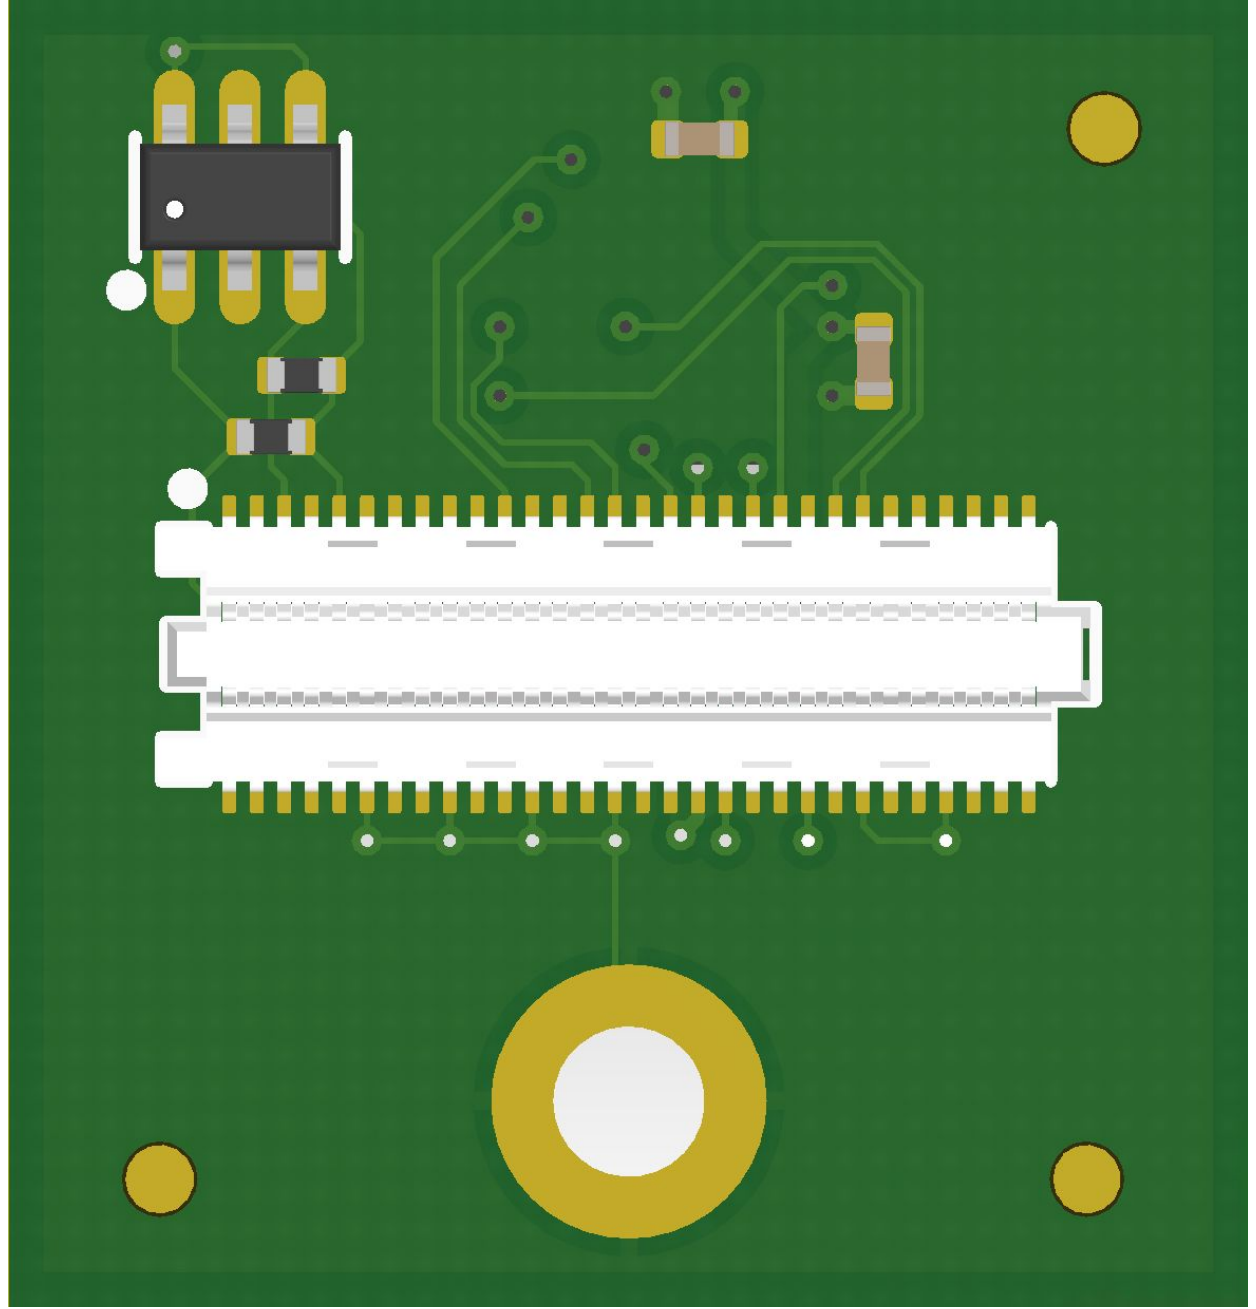
[picture p70: page 1]
