micro-FPGA/CRUVI/CAD/Altium/boards/CR00045/docs/3DT-CR00045-01-1.PDF

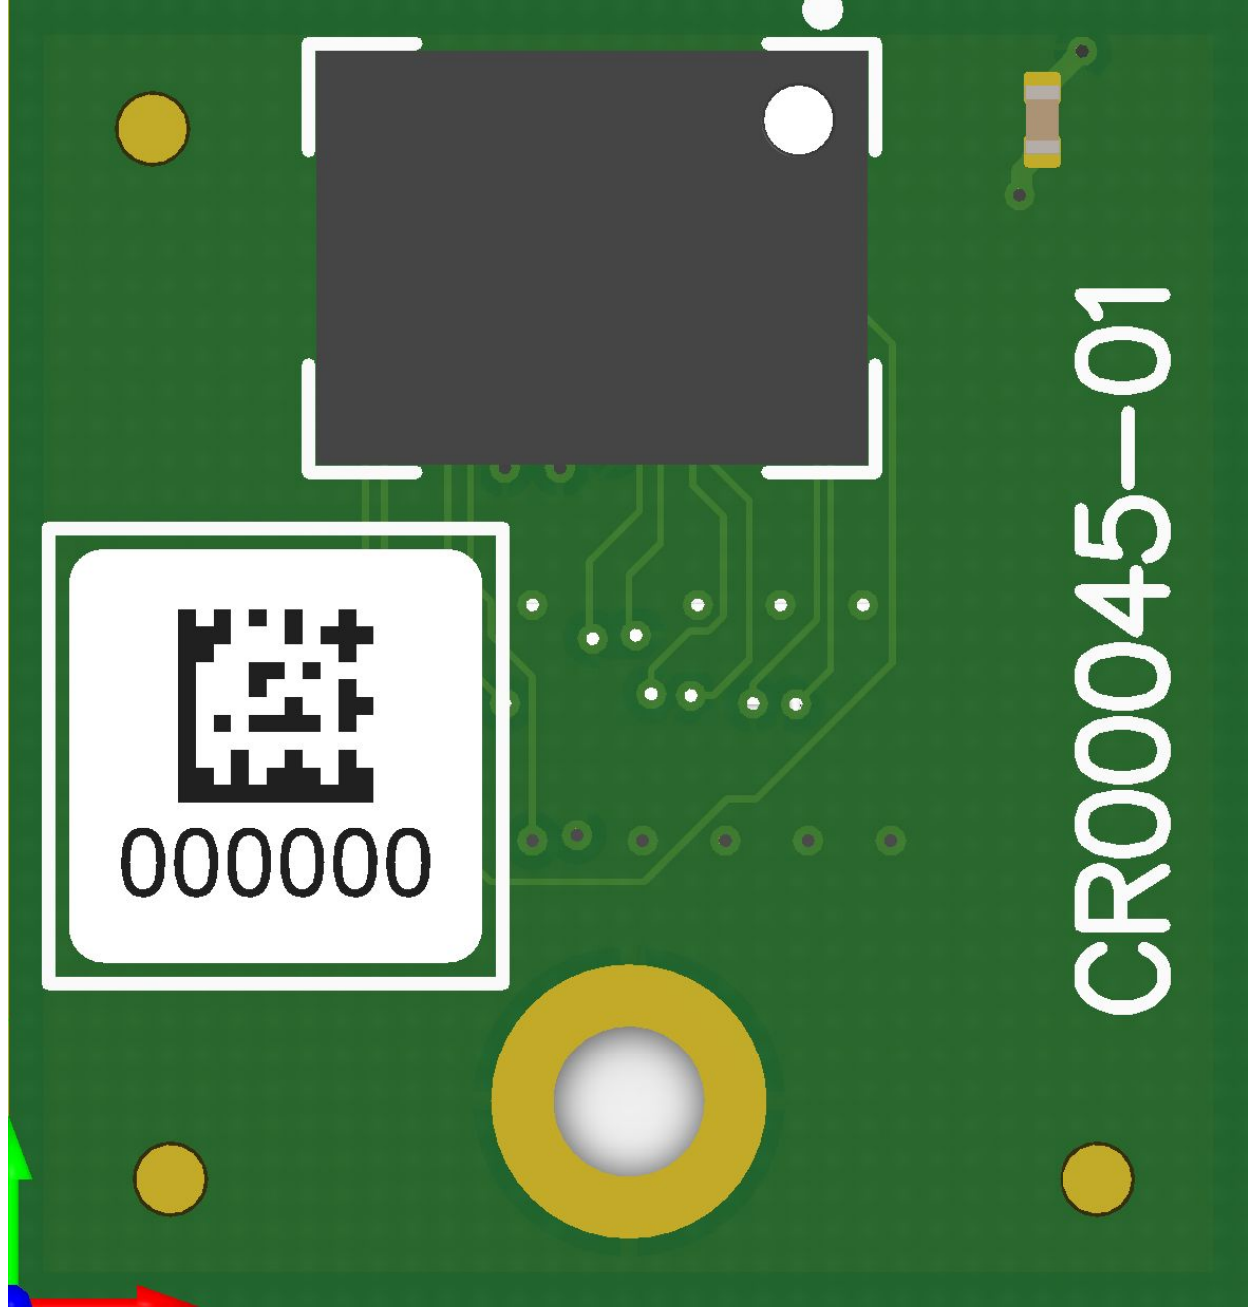
[picture p71: page 1]
