micro-FPGA/CRUVI/CAD/Altium/boards/CR00045/docs/AD-CR00045-01-1.PDF

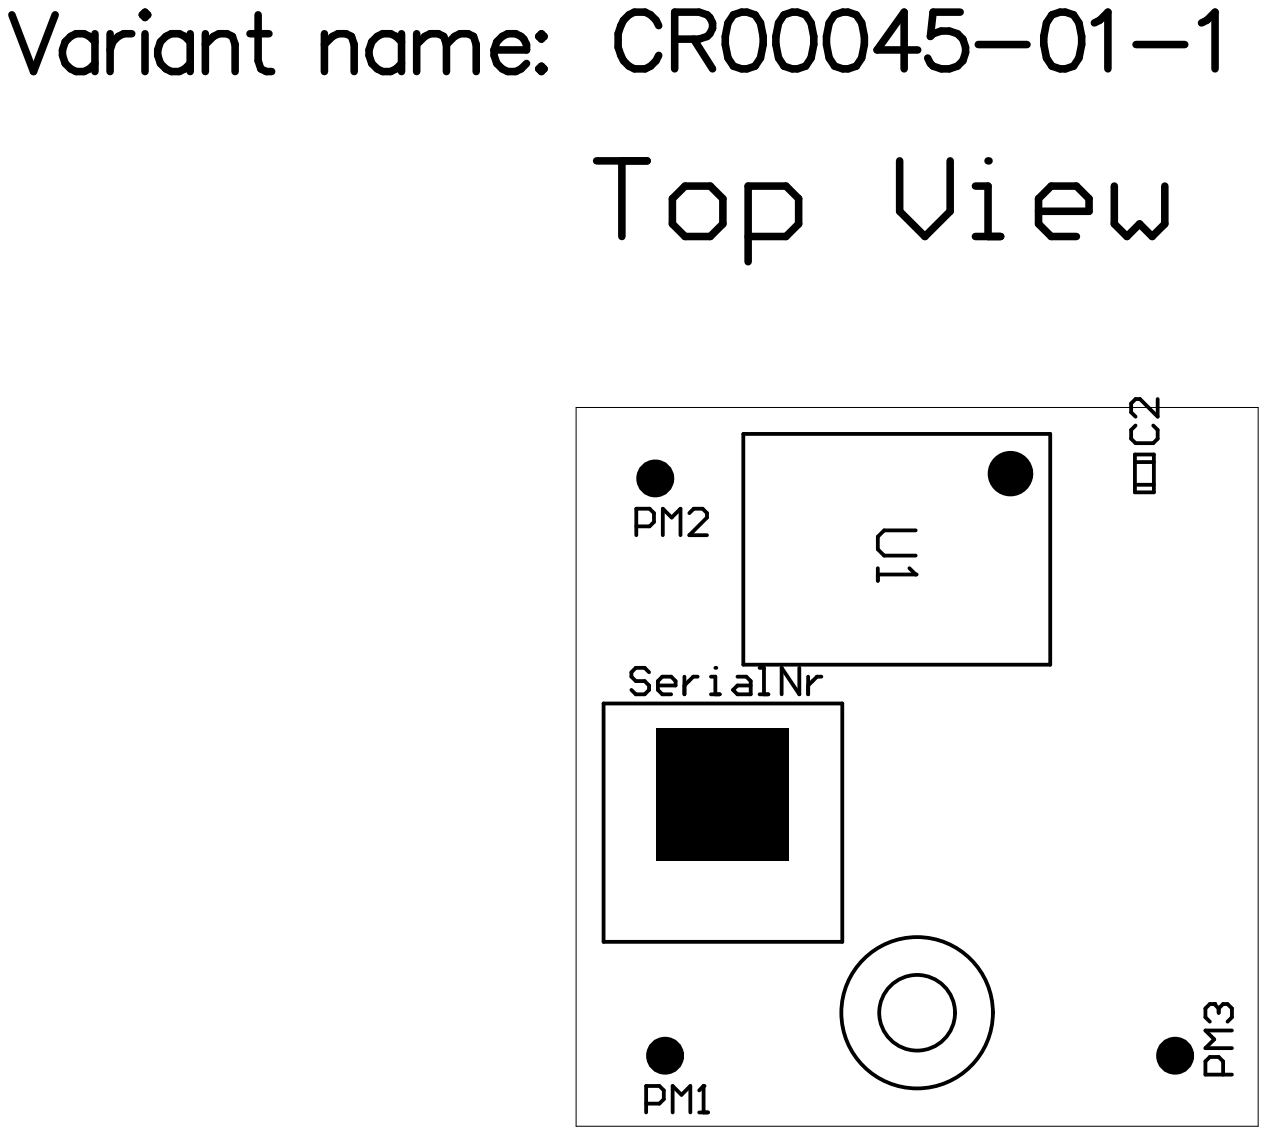
[picture p72: page 1]

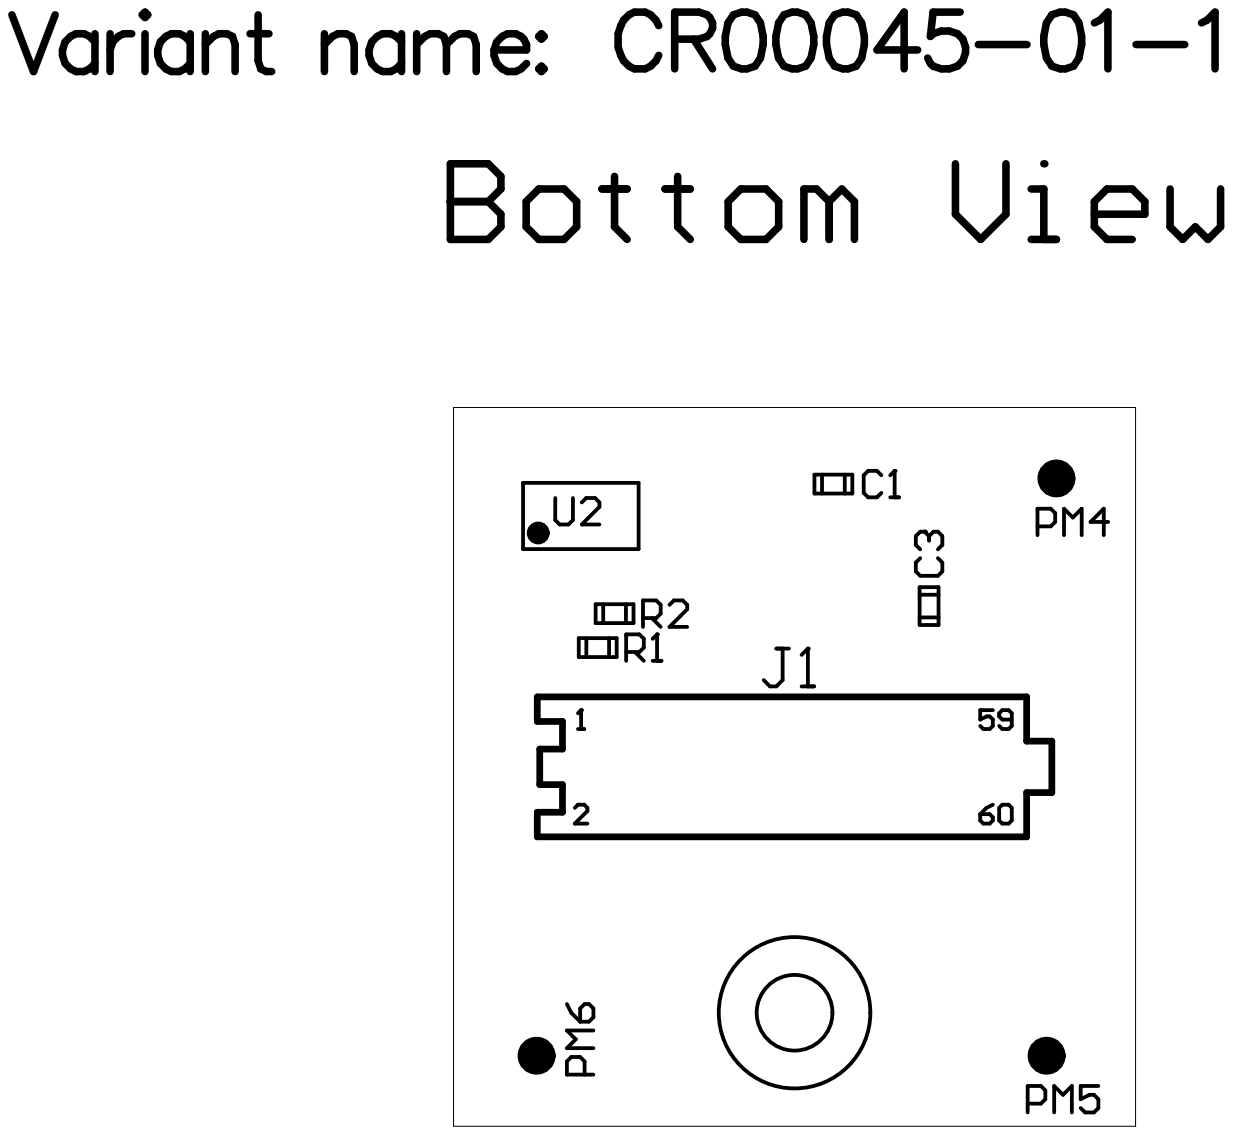
[picture p73: page 2]
