micro-FPGA/CRUVI/CAD/Altium/boards/CR00045/docs/DIM-CR00045-01-1.PDF

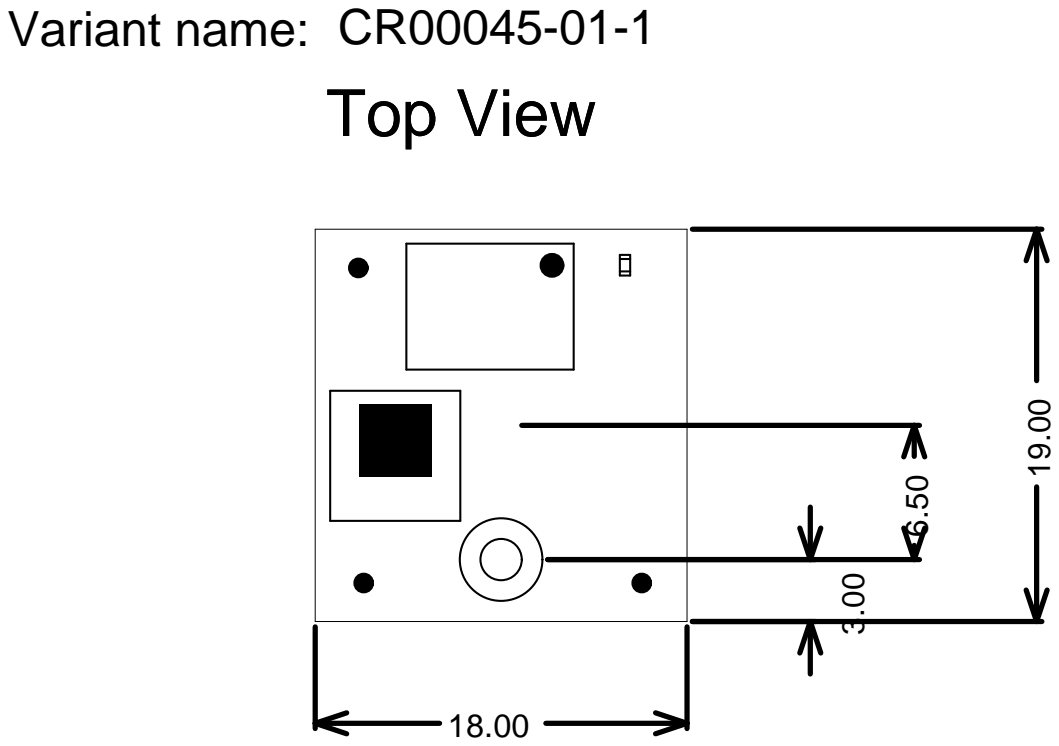
[picture p74: page 1]

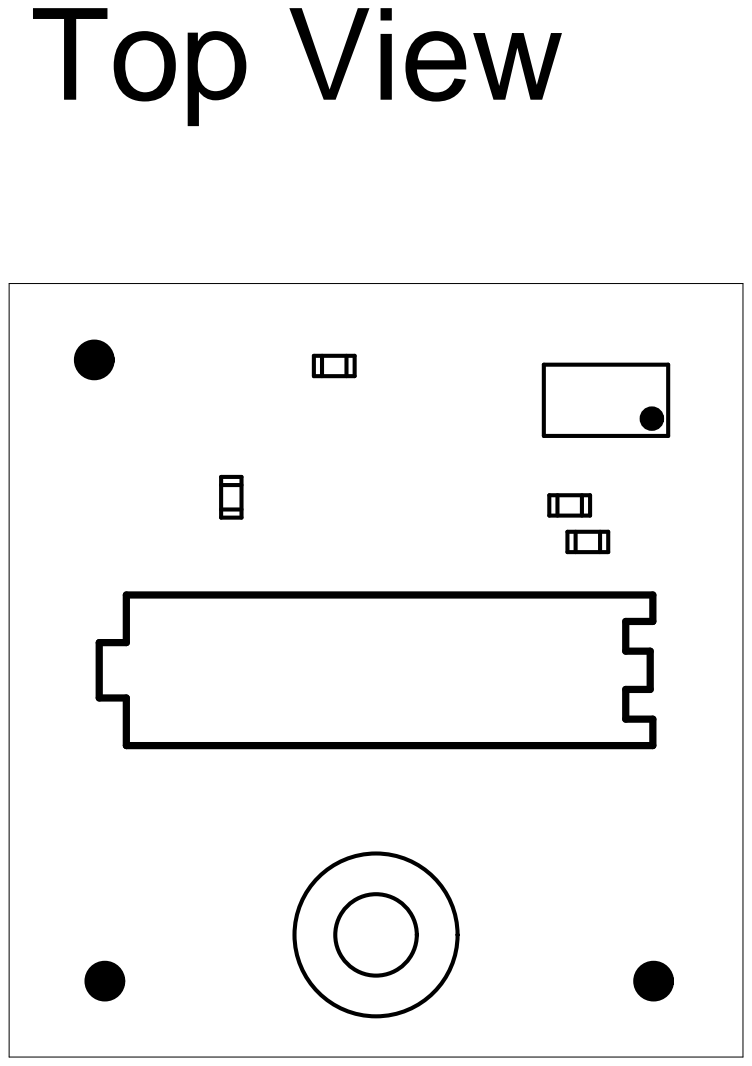
[picture p75: page 2]
