micro-FPGA/CRUVI/CAD/Altium/boards/CR00045/docs/SCH-CR00045-01-1.PDF

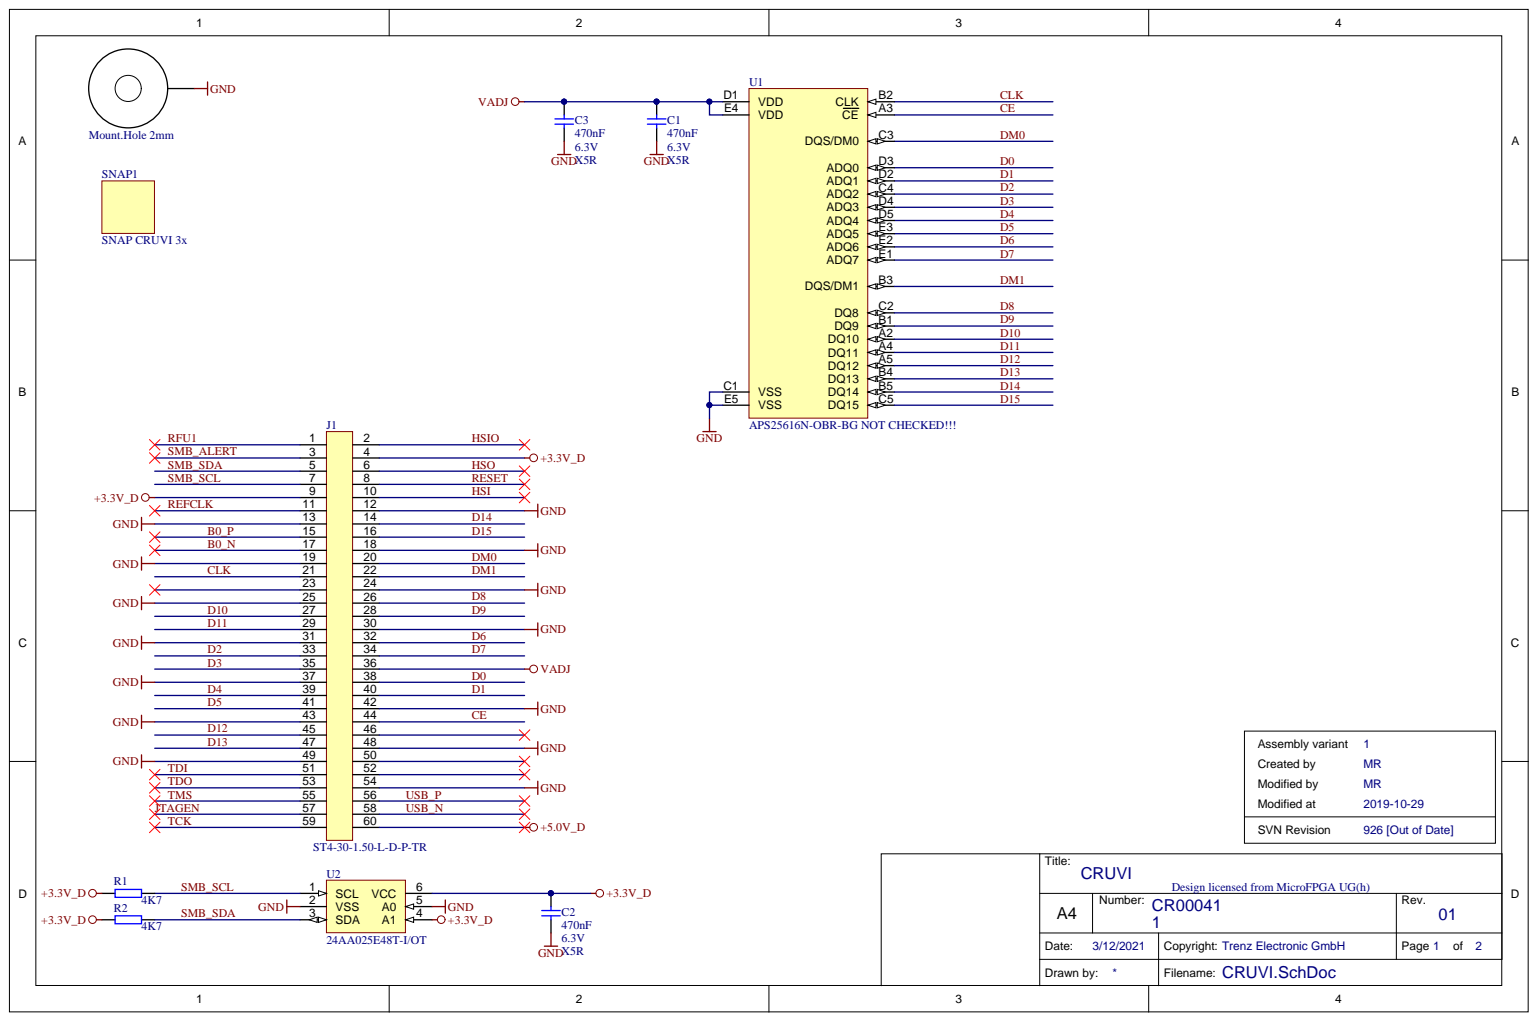
[picture p76: page 1]

APS25616N-OBR-BG NOT CHECKED!!!

Title: CRUVI Design licensed from MicroFPGA UG(h)

A4 | Number: CR00041 1 | Rev. 01

Date: 3/12/2021 | Copyright: Trenz Electronic GmbH | Page 1 of 2

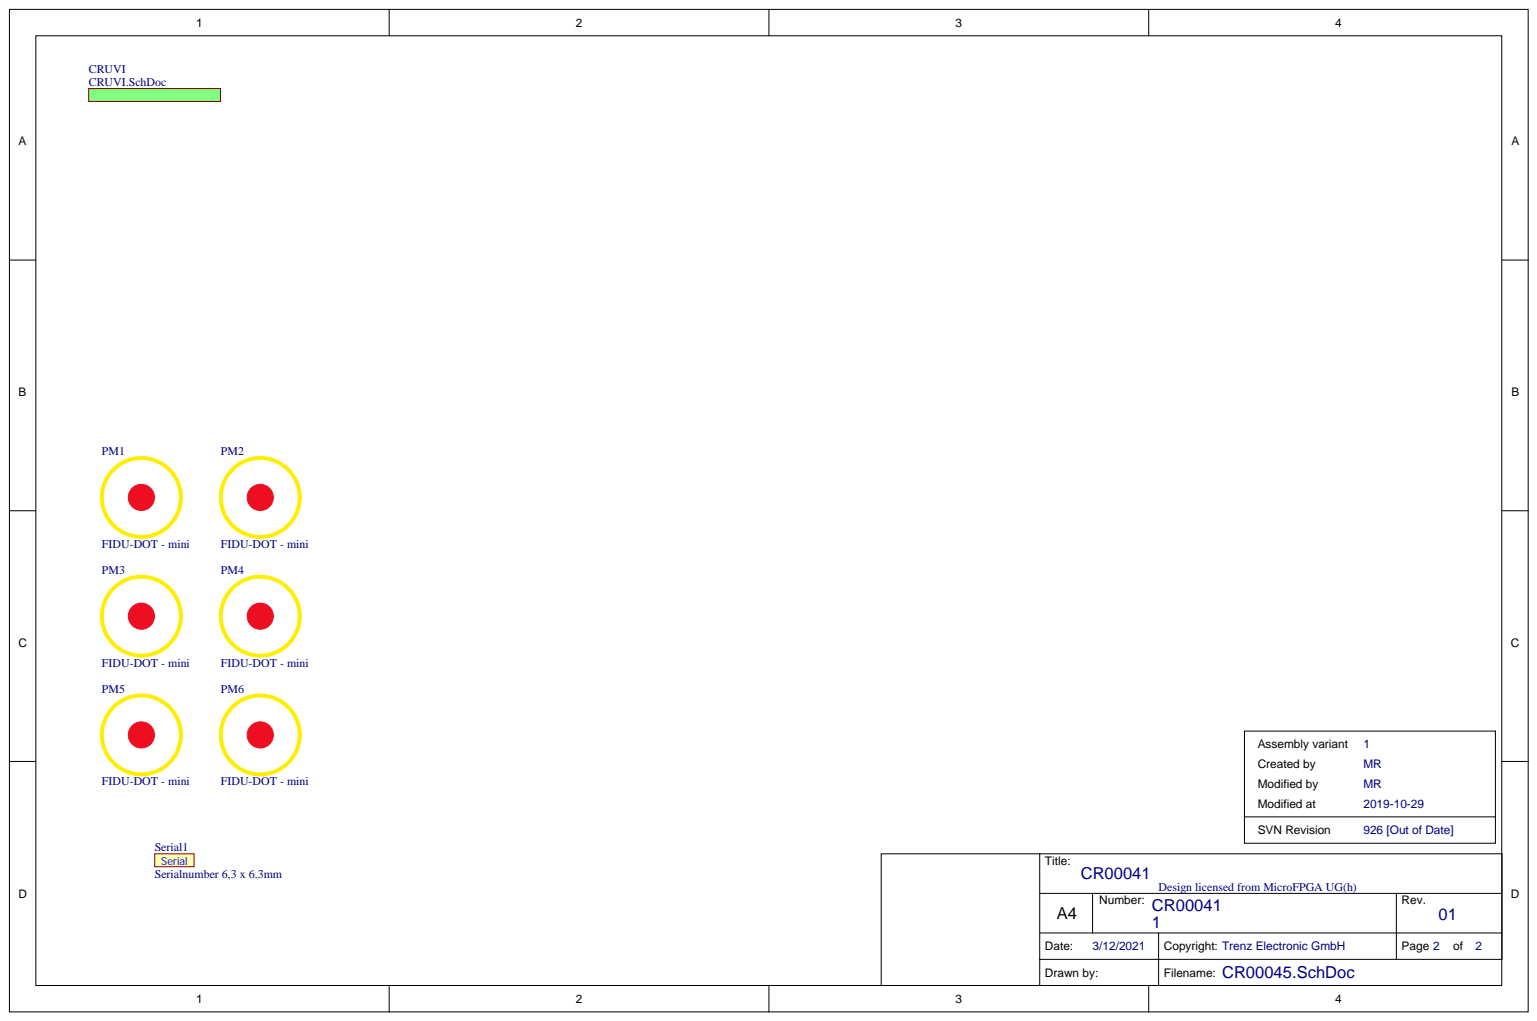
[picture p77: page 2]

Design licensed from MicroFPGA UG(h)

A4 | Number: CR00041 1 | Rev. 01

Date: 3/12/2021 | Copyright: Trenz Electronic GmbH | Page 2 of 2
