micro-FPGA/CRUVI/CAD/Altium/boards/CR00026/docs/AD-CR00026-01-1.PDF

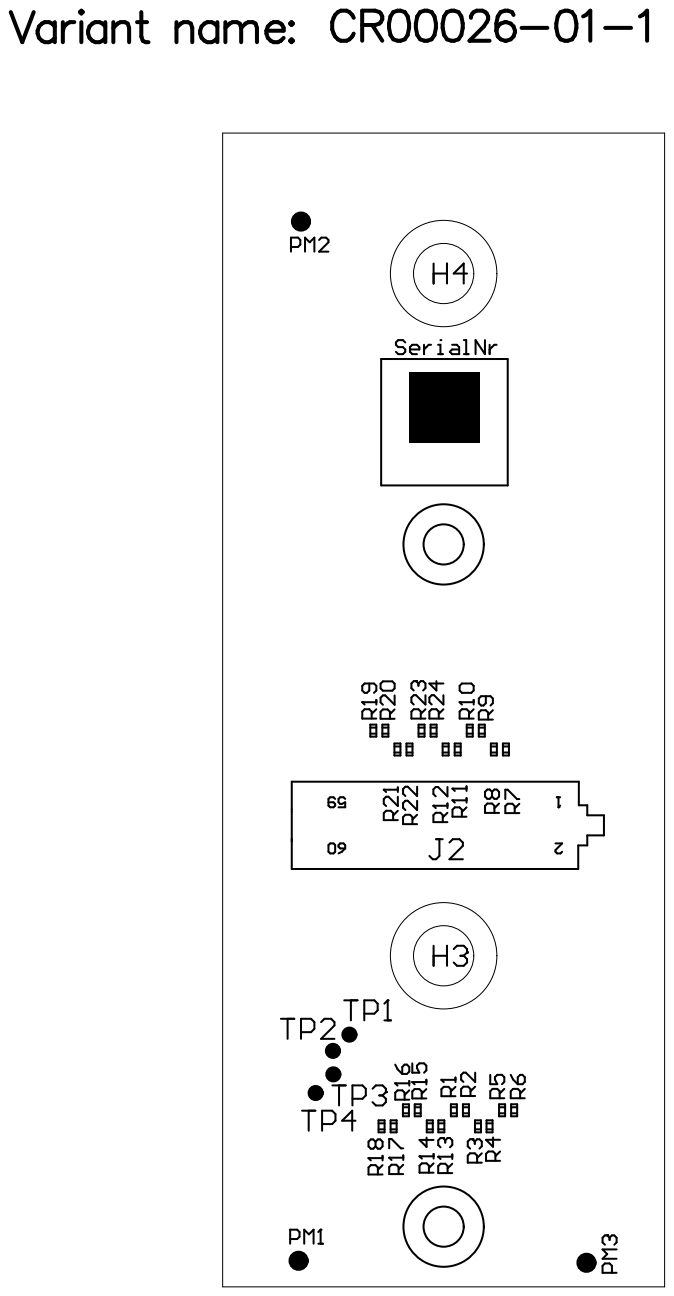
[picture p78: page 1]

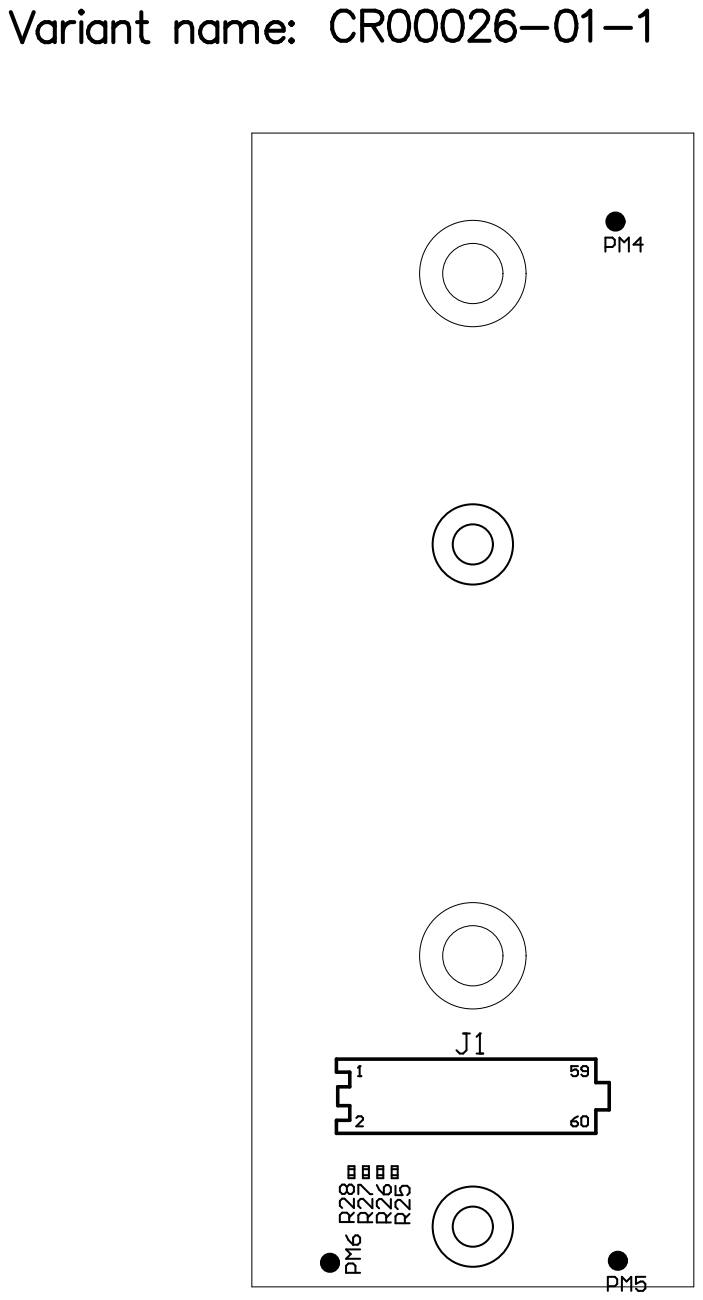
[picture p79: page 2]
