micro-FPGA/CRUVI/CAD/Altium/boards/CR00026/docs/DIM-CR00026-01-1.PDF

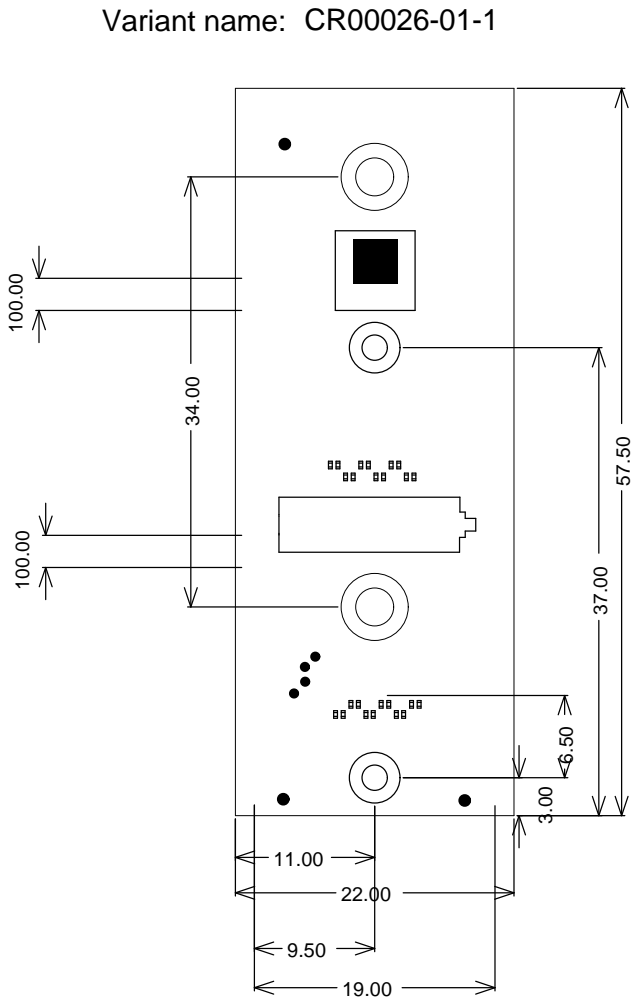
[picture p80: page 1]

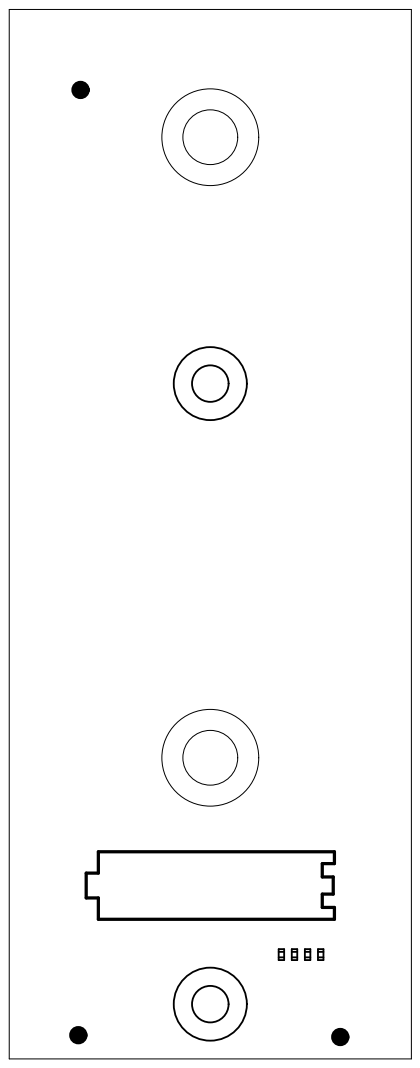
[picture p81: page 2]
