micro-FPGA/CRUVI/(list of files, drawings)

Other design files:
CAD/Altium/boards/CR00026/hw/CR00026.PcbDoc
CAD/Altium/boards/CR00026/hw/CR00026.PrjPCB
CAD/Altium/boards/CR00026/hw/CRUVI.SchDoc
CAD/Altium/boards/CR00026/hw/headers.SchDoc
CAD/Altium/boards/CR00041/hw/CR00041.PcbDoc
CAD/Altium/boards/CR00041/hw/CR00041.PrjPCB
CAD/Altium/boards/CR00041/hw/CR00041.SchDoc
CAD/Altium/boards/CR00041/hw/CRUVI.SchDoc
CAD/Altium/boards/CR00045/hw/CR00045.PcbDoc
CAD/Altium/boards/CR00045/hw/CR00045.PrjPCB
CAD/Altium/boards/CR00045/hw/CR00045.SchDoc
CAD/Altium/boards/CR00045/hw/CRUVI.SchDoc
CAD/Altium/templates/CR99001/current/hw/pcb/CR99001.PcbDoc
CAD/Altium/templates/CR99001/current/hw/pcb/CR99001.PrjPCB
CAD/Altium/templates/CR99001/current/hw/pcb/CR99001.SchDoc
CAD/Altium/templates/CR99003/current/hw/pcb/CR99003.PcbDoc
CAD/Altium/templates/CR99003/current/hw/pcb/CR99003.PrjPCB
CAD/Altium/templates/CR99003/current/hw/pcb/CR99003.SchDoc
CAD/Altium/templates/CR99004/current/hw/pcb/CR99004.PcbDoc
CAD/Altium/templates/CR99004/current/hw/pcb/CR99004.PrjPCB
CAD/Altium/templates/CR99004/current/hw/pcb/CR99004.SchDoc
CAD/Altium/templates/CR99101/current/hw/pcb/CR99101.PcbDoc
CAD/Altium/templates/CR99101/current/hw/pcb/CR99101.PrjPCB
CAD/Altium/templates/CR99101/current/hw/pcb/CRUVI.SchDoc
CAD/Altium/templates/CR99102/current/hw/pcb/CR99102.PcbDoc
CAD/Altium/templates/CR99102/current/hw/pcb/CR99102.PrjPCB
CAD/Altium/templates/CR99102/current/hw/pcb/CRUVI.SchDoc
CAD/Altium/templates/CR99400/current/hw/pcb/CR99400.PcbDoc
CAD/Altium/templates/CR99400/current/hw/pcb/CR99400.PrjPCB
CAD/Altium/templates/CR99400/current/hw/pcb/CR99400.SchDoc
CAD/Altium/templates/CR99400/current/hw/pcb/CRUVI.SchDoc
CAD/Altium/templates/CR99500/current/hw/pcb/CR99500.PrjPCB
CAD/Altium/templates/CR99500/current/hw/pcb/CR99500.SchDoc
CAD/Altium/templates/CR99500/current/hw/pcb/CRUVI-GT.SchDoc
