micro-FPGA/CRUVI/(commit log)

2020-01-27 remove PCB files
2021-05-21 Add first Altium templates
    [CR99001.PcbDoc, CR99001.PrjPCB, CR99001.SchDoc, CR99003.PcbDoc, CR99003.PrjPCB, CR99003.SchDoc, CR99004.PcbDoc, CR99004.PrjPCB]
2021-05-27 added 2 templates
    [CR99101.PcbDoc, CR99101.PrjPCB, CR99101.SchDoc, CR99102.PcbDoc, CR99102.PrjPCB, CR99102.SchDoc, CRUVI.SchDoc]
2021-09-17 added CR00026 files
    [CR00026.PcbDoc, CR00026.PrjPCB, CR00026.SchDoc, CRUVI.SchDoc, headers.SchDoc]
2021-09-17 added CR00041, CR00045
    [CR00041.PcbDoc, CR00041.PrjPCB, CR00041.SchDoc, CR00045.PcbDoc, CR00045.PrjPCB, CR00045.SchDoc, CRUVI.SchDoc]
2021-09-17 fixed design license
    [CR00041.SchDoc]
2024-03-13 Added two templates
    [CR99400.PcbDoc, CR99400.PrjPCB, CR99400.SchDoc, CR99500.PrjPCB, CR99500.SchDoc, CRUVI-GT.SchDoc, CRUVI.SchDoc]
2024-03-13 updated CR99400
    [CR99400.PrjPCB, CR99400.SchDoc, CRUVI.SchDoc]
2024-05-06 Added CR00103 LiteX test project
    This is the project that is used to pre-flash the CR00103 at factory.
    [mypll.cfg]
